erdemcanaz/EE464-Emine-BOOSTanci/Reports/Emine_BOOSTanci_simulation_presentation_24_04_2024_09_21.pptx

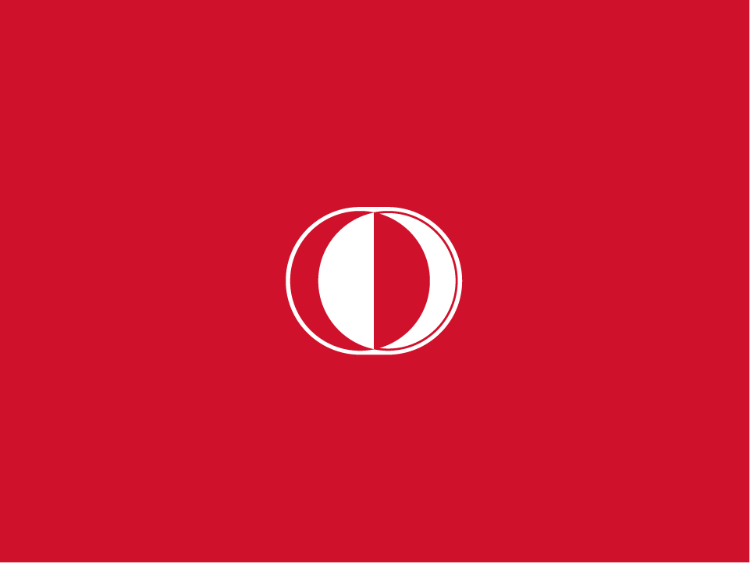
[picture p19: figure]

## Slide 2

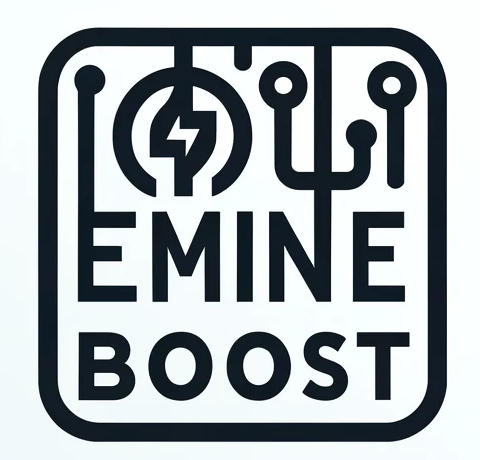
[picture p20: figure]

EE464 HARDWARE PROJECT PRESENTATION
By Emine BOOSTancı

Canberk Kaçan
Erdem Canaz
Erkin Atay Toka

24.04.2024

## Table of Contents

1. Design Criteria
2. Topology & Design Selection
3. Magnetic Design
4. Simulation Results
5. Component Selection
6. Future Work

## 1. Design Criteria

- Minimum Input Voltage: 20 V
- Maximum Input Voltage: 40 V
- Output Voltage: 12 V
- Output Power: 60 W
- Output Voltage Peak-to-Peak Ripple: 3%
- Line Regulation: 3%
- Load Regulation: 3%
- Isolated Converter
- Close Loop Feedback

## 2. Topology & Design Selection

- Flyback Converter: low power applications
- (up to 100 Watts)
- Forward Converter: 50 Watts to a couple of hundred watts
- Push Pull Converter: medium power levels (100 Watts to a few kilowatts)
- Half and Full Bridge Converter: medium to high power ranges (100 Watts to over 500 Watts)
- Push Pull, Half and Full Bridge Convertes are overdesign.

## 2. Topology & Design Selection

- Flyback Converter

- No restriction on D
- Less components (only transformer)
- No resetting the core’s flux
- Easiest to design
- Leakage inductance
- Less efficiency
- More ripple and worse regulation

- Forward Converter

- Restriction on D
- More components (transformer & inductor)
- Resetting the core’s flux
- Harder to design
- Magnetizing inductance
- Higher efficiency
- Less ripple and better regulation

## 2. Topology & Design Selection

- Single Switch Flyback Converter

- Two Switch Flyback Converter

- D < 0.5 for CCM
- Complexity (high side switch)
- High input capacitance
- Higher efficiency

Target Efficiency = %80

- No restriction on D
- Simplicity
- Snubber Design
- Less efficiency

## 2. Topology & Design Selection

- CCM or DCM: CCM. Less ripple but worse core utilization. Analytically easy but nonlineer Bode plot.
- Switching Frequency: 90 kHz.
- Turns Ratio and Duty Cycle Range: 0.23<D<0.375 N=1


## 3. Magnetic Design

- Lm Determination:

L_m >((V_(in)^(max) D_(min) )^2)/(2 P_(in) f_s K_(RF))=((40V 0.238)^2)/(2 (75W)(90kHz)0.7)=9.6 μH


L_m =20 μH

## 3. Magnetic Design

- Core Selection:
- Aim: Operate around 100mT to minimize losses.
- Disadvantage: Volume increase. Losses might increase.
- Choose ferrite core → less leakage. Fringing fields problem
- Higher window area → fill factor auxilary winding
- 0R45530EC (https://www.mag-inc.com/Media/Magnetics/Datasheets/0R45530EC.pdf)

## 3. Magnetic Design

- Core Selection: N_1 ∅=L_m I_(max,pri)

## 3. Magnetic Design

- Core Selection:

L_m =(N_1^2)/(R_(gap))

N1=N2=7 turns
lgap=0.7 mm
Bmax=96 mT

## 3. Magnetic Design

- Cable Selection:
- Choose 2δ (@90kHz 0.44 mm) > Dconductor
- AWG 26 ( D=0.4 mm, A=0.129 mm^2 )
- Maximum RMS Current is 10A.
- J=3 A/mm^2
- #parallels=(I_(rms,max))/(J A)=26
- For safety take 30 parallel.
- From core geometry find MLT and length of the copper.
- R_(primary) =R_(secondary) =3.9mΩ
- P_(Cu) =P_(primary) +P_(secondary) =0.793 W
- Fill Factor=0.1683

[1]

## 3. Magnetic Design

- Core Losses:
- Steinmetz Coefficients

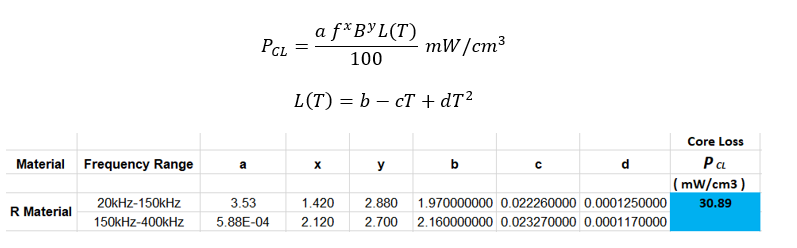
[picture p21: figure]

P_(core) =2VP_(CL) =3.21 W

[2]

## 3. Magnetic Design

- Experimental Results:

L_m =20.94 μH L_(leak) =0.21μH R_(Cu) =4.6 mΩ

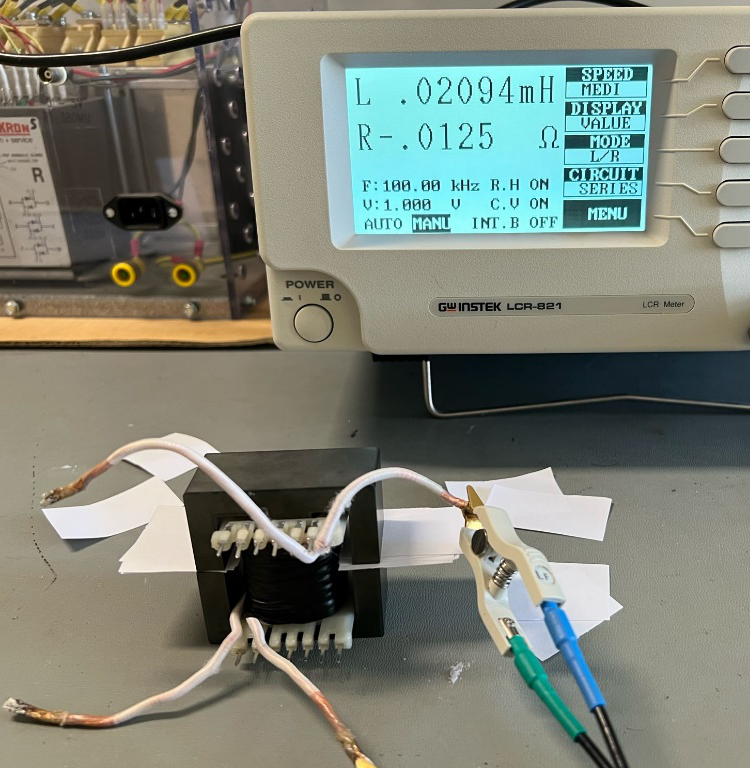
[picture p22: figure]
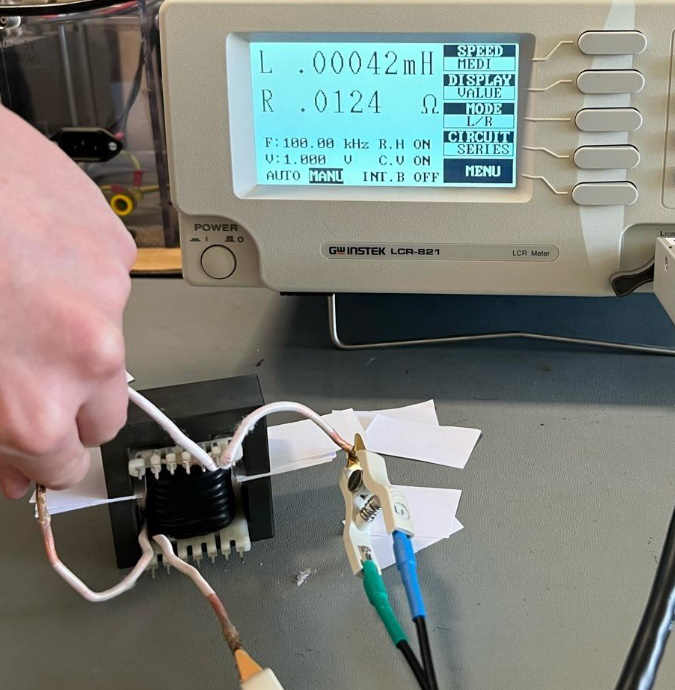
[picture p23: figure]

## 4. Simulation Results:Block diagram

Source model

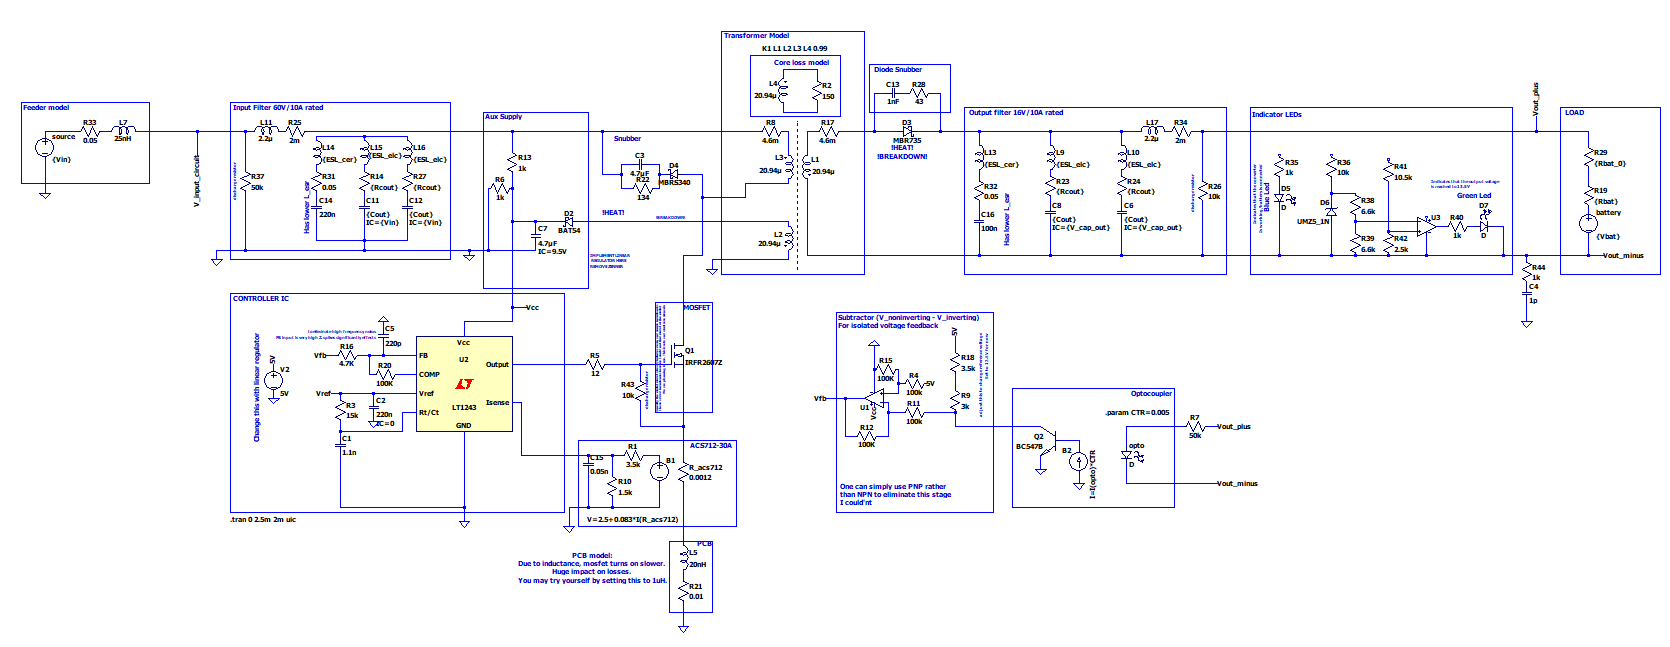
[picture p24: figure]

Input Fil.

Aux. Sup.

Transformer

Diode Snub.

Output Fil.

Indicators

Bat. Model

Snub.

Controller IC

MOSFET

Current
feedback

PCB model

Voltage
feedback

## 4. Simulation Results:Block diagram

Single run for Vin = 40V, Vbat = 12V

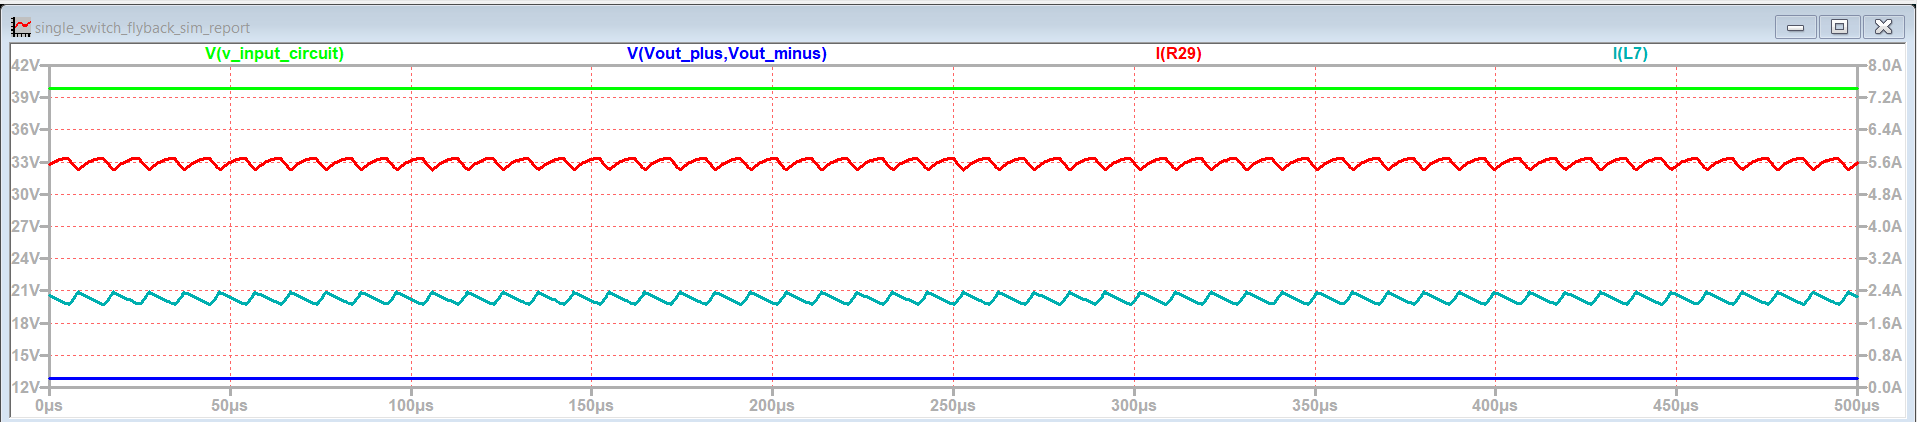
[picture p25: figure]

Vin

Iin

Iout

Vout

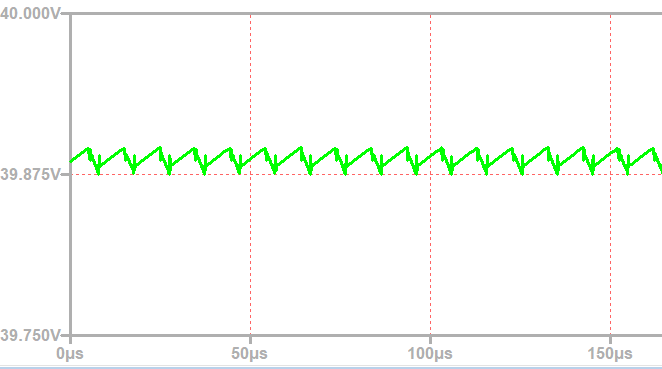
[picture p26: figure]

Vin

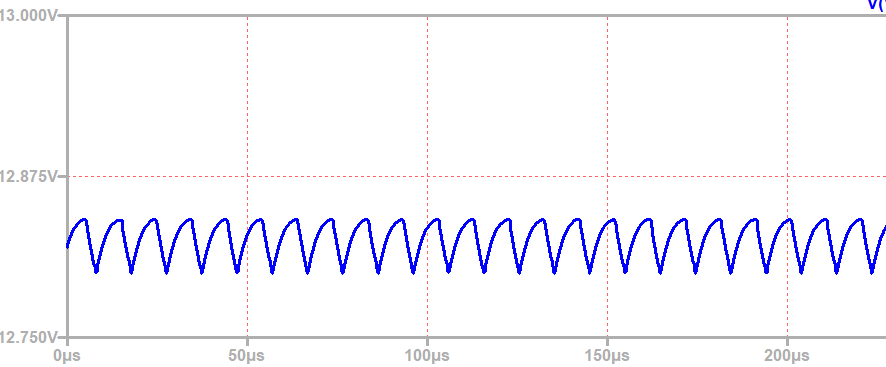
[picture p27: figure]

Vout

## Slide 18

4. Simulation models: Current Feedback

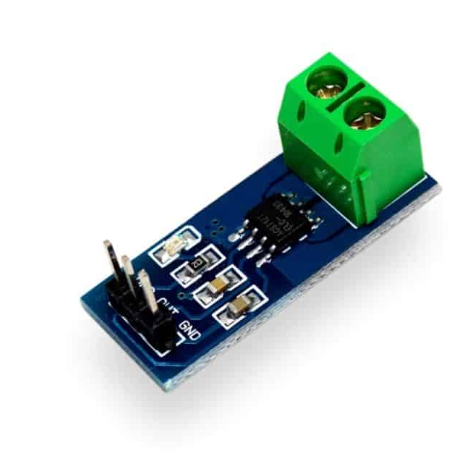
[picture p28: figure]
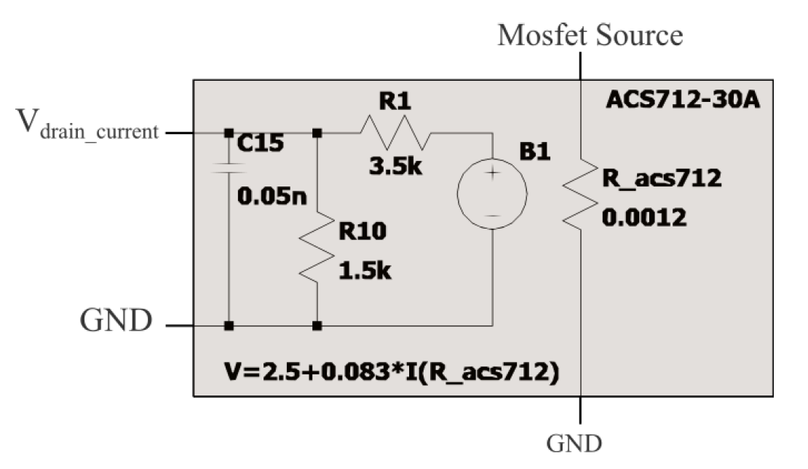
[picture p29: figure]

## Slide 19

4. Simulation Results: Voltage Feedback

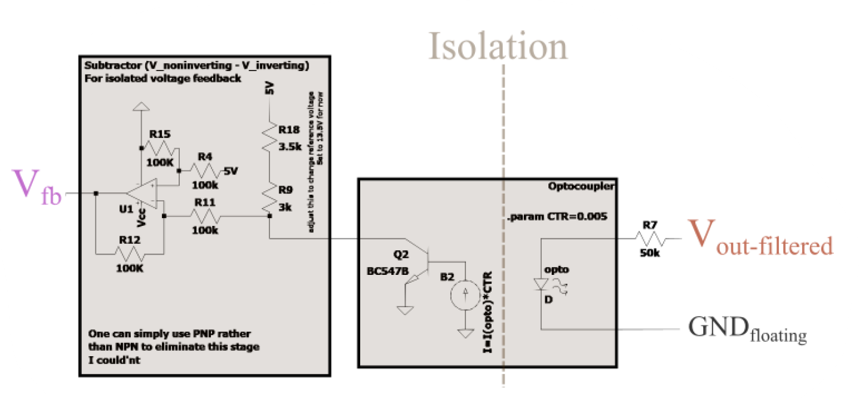
[picture p30: figure]

## Slide 20

4. Simulation Results: Snubber (40V Vin)

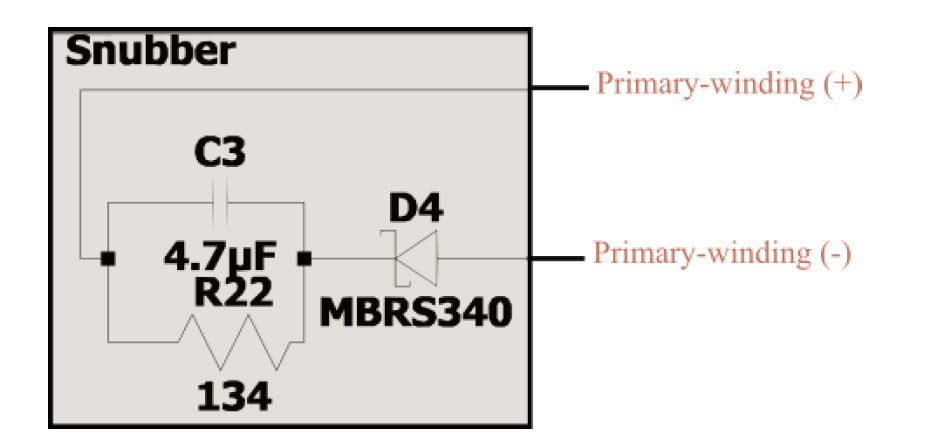
[picture p31: figure]

20v

3.2w

60v

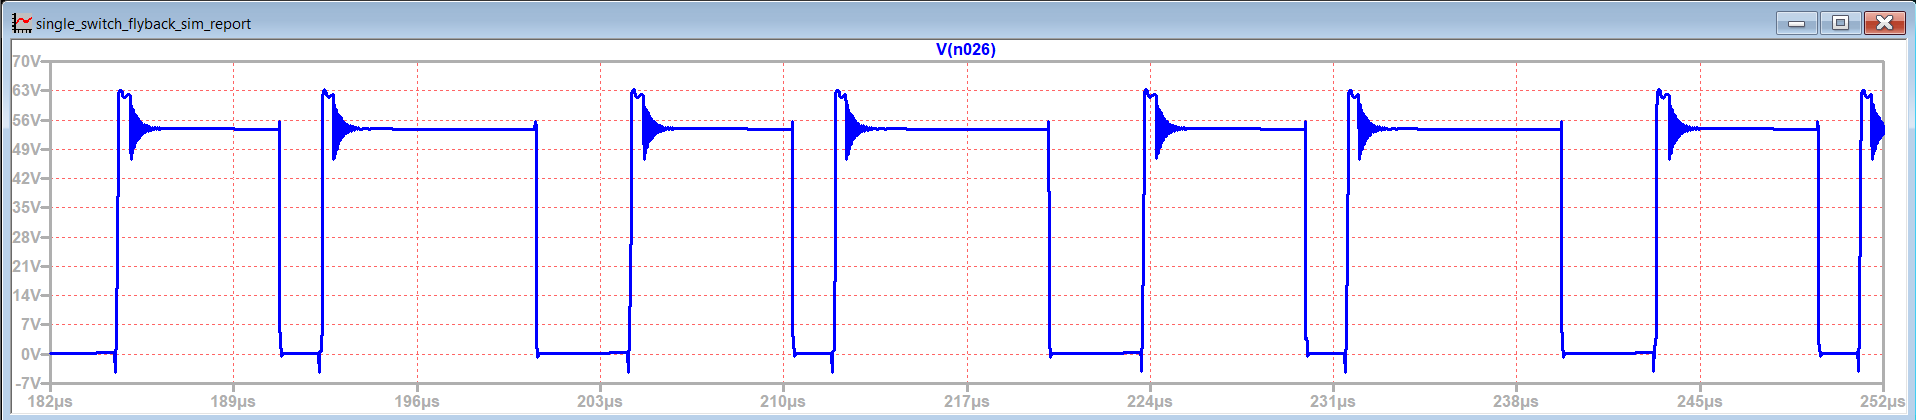
[picture p32: figure]

Drain-to-Source Voltage of MOSFET

## Slide 21

4. Simulation Results: Transformer Model

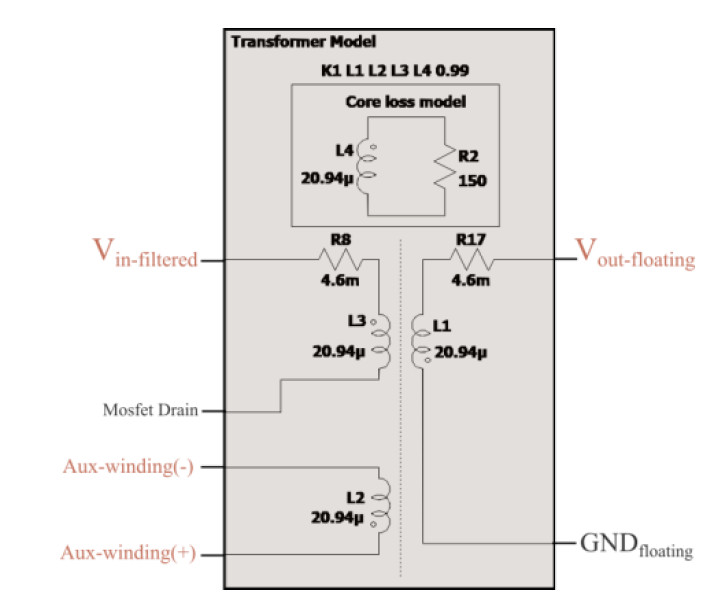
[picture p33: figure]

Coupling Factor
%1

## Slide 22

4. Simulation Results: Output Filter Model

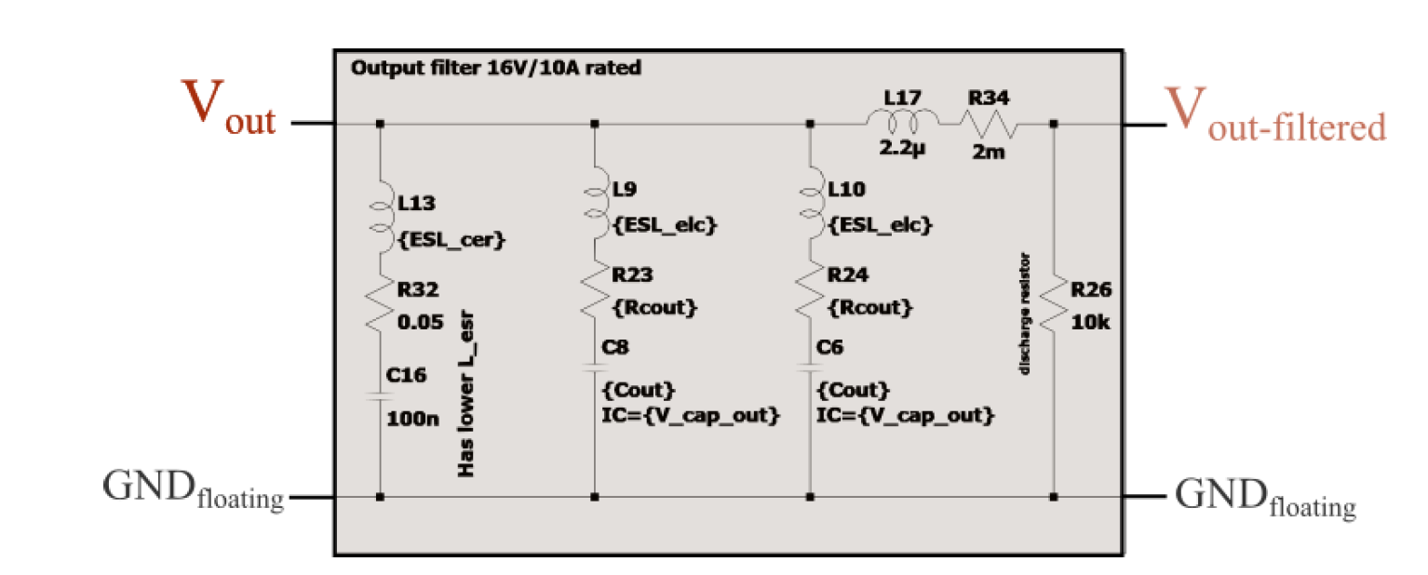
[picture p34: figure]

## Slide 23

4. Simulation Results: Capacitor Model

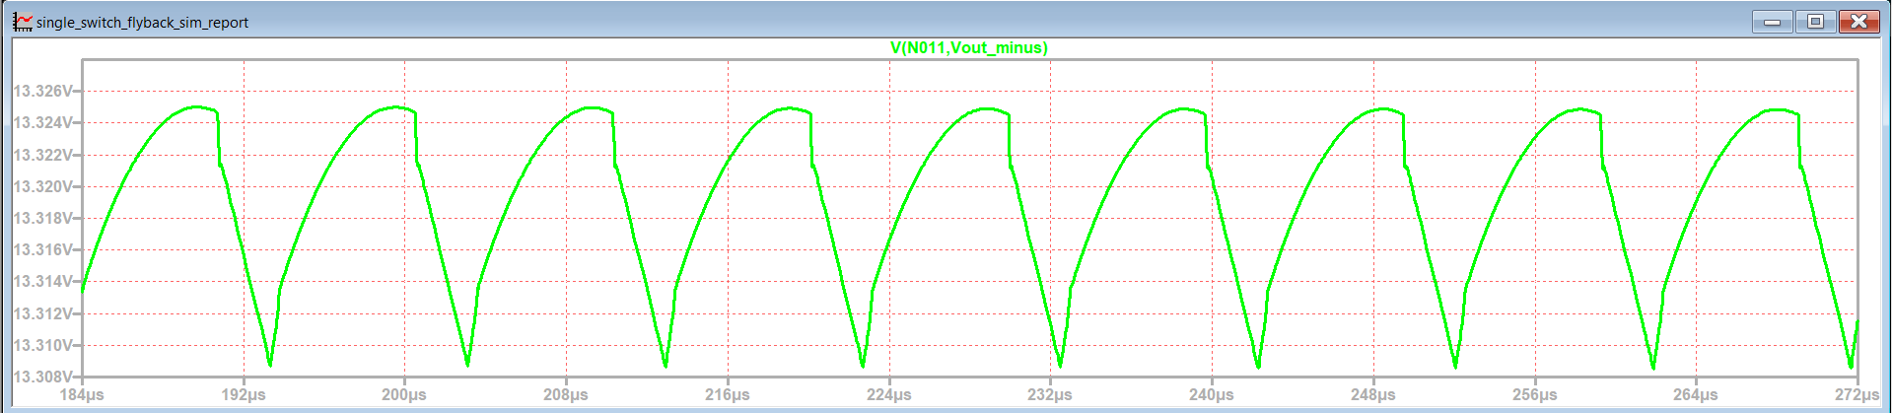
[picture p35: figure]

C

C-R

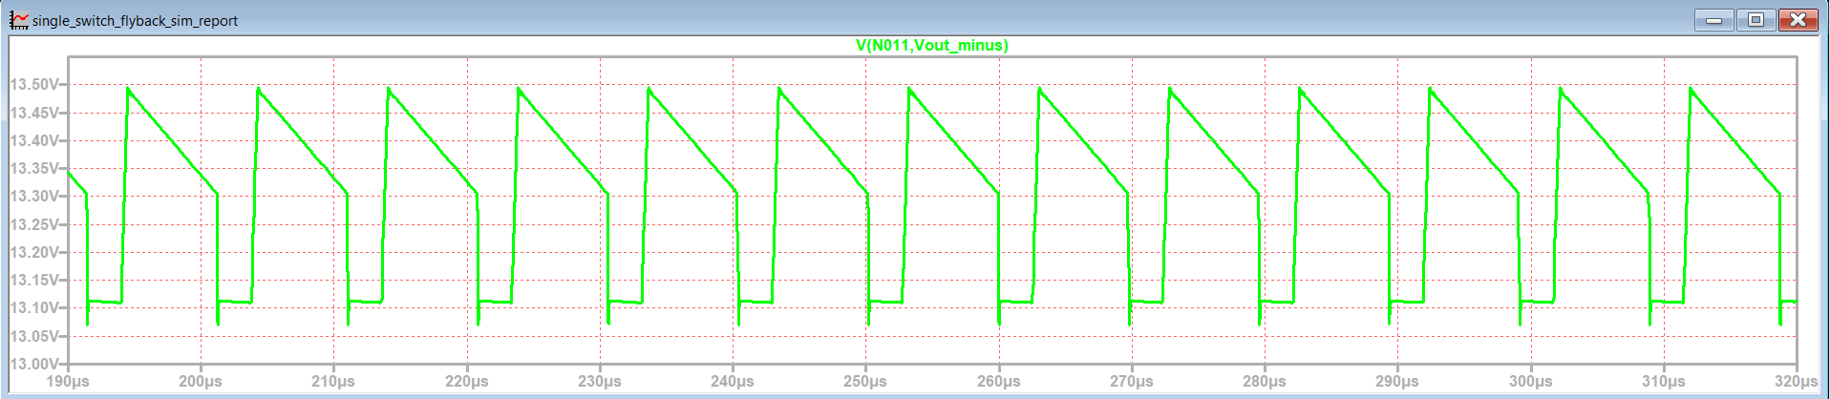
[picture p36: figure]
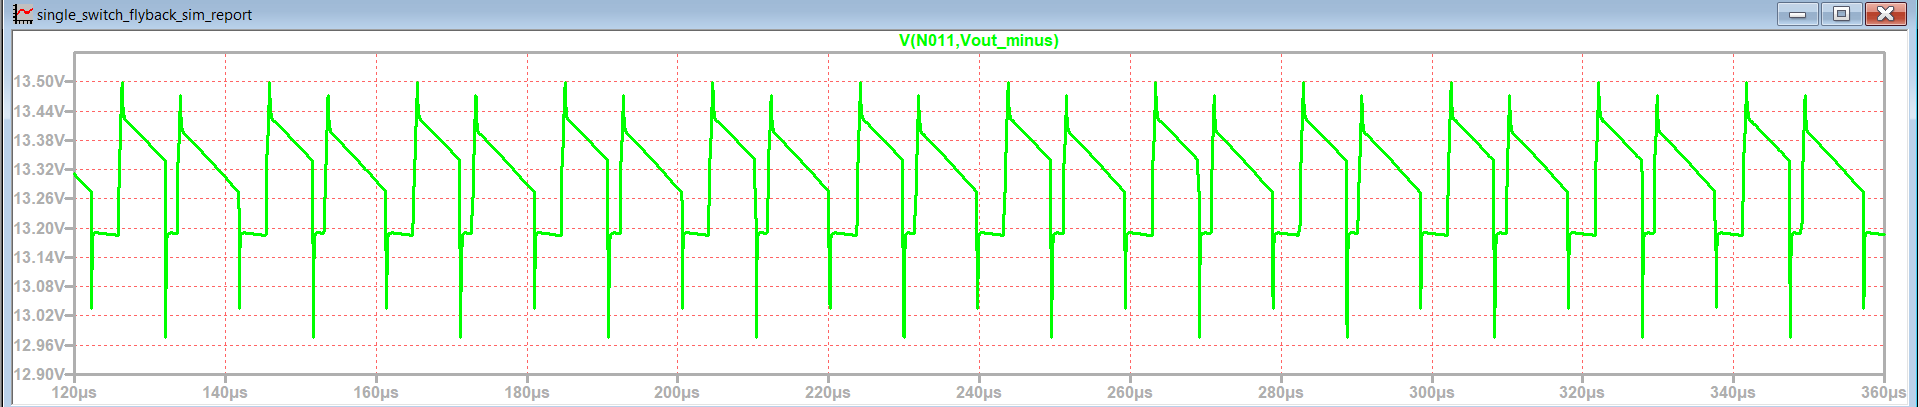
[picture p37: figure]

Output voltages seen at secondary terminals

C-R-L

## Slide 24

4. Simulation Results: Auxiliary Supply Model

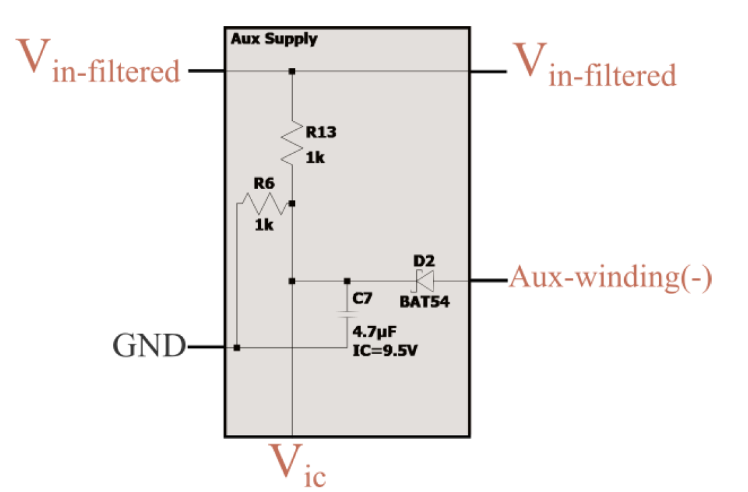
[picture p38: figure]

## Slide 25

4. Simulation Results: Indicator LEDs

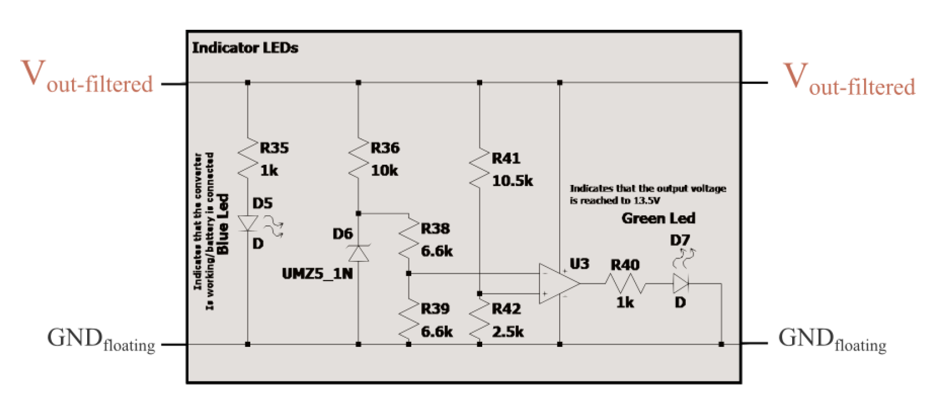
[picture p39: figure]

## 4. Simulation Results: Summary

Vin = {20, 25, 30, 35, 40}V

Vbat = {11, 12, 13}V

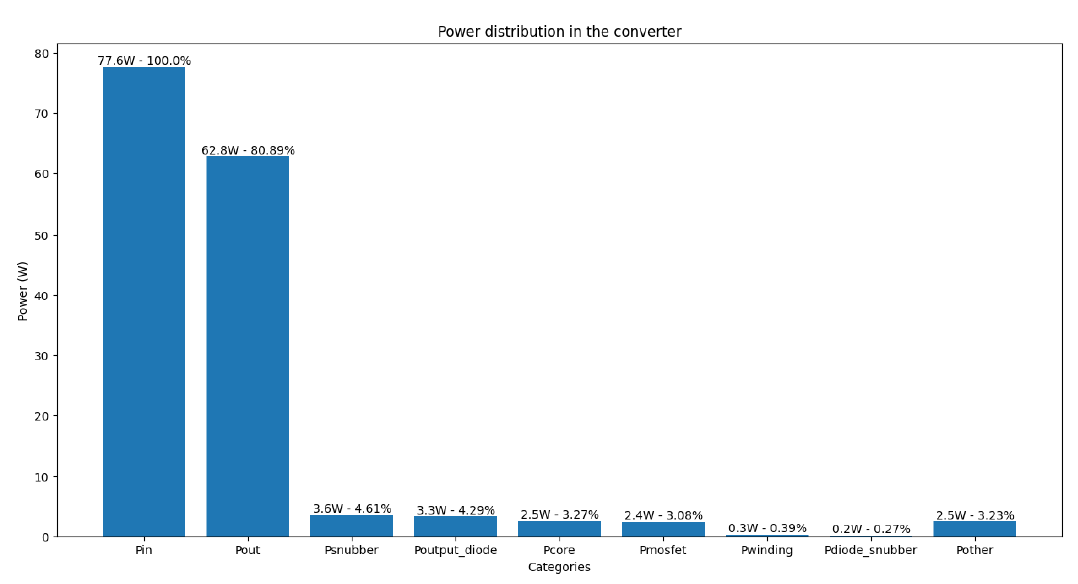
[picture p40: figure]

## 4. Simulation Results: Detailed results

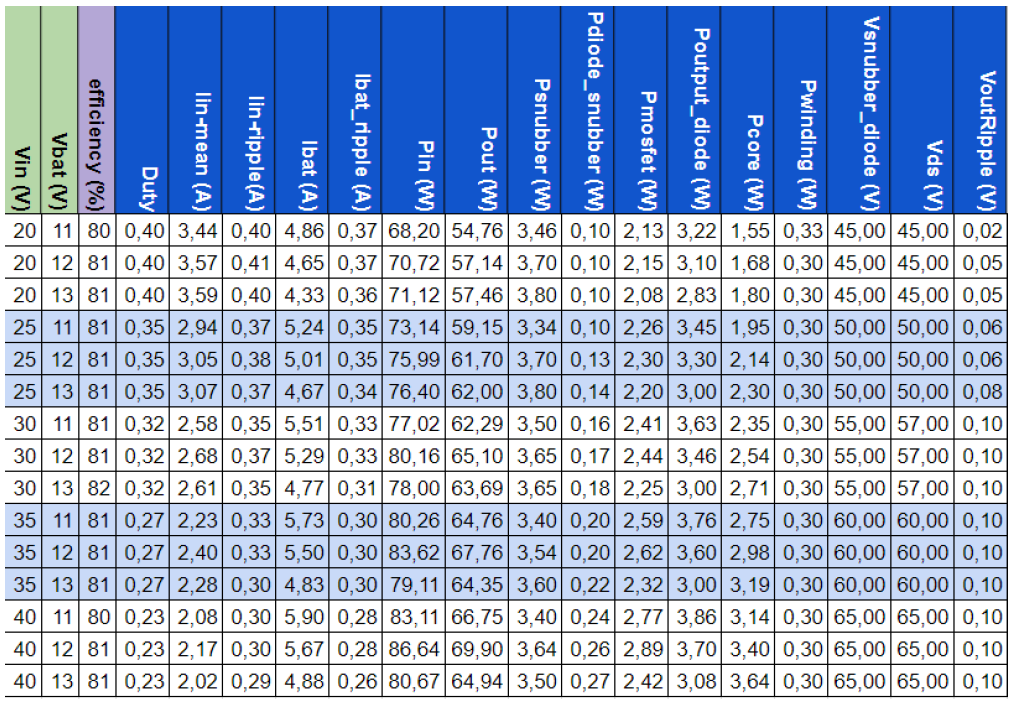
[picture p41: figure]

## 4. Simulation Results: Summary

- About %75-80 efficiency is expected
- Ratings are acceptable
- The snubber works properly
- Voltage regulations are satisfied

## 5. Component Selection

- MOSFET: IRFU3710ZPbF (https://cdn.ozdisan.com/ETicaret_Dosya/652386_243124.pdf)
- ID,max ≈ 10A
- VDS,max ≈ 65V

| Parameter | Max. | Units
ID @ TC = 25°C | Continuous Drain Current VGS @ 10V | 56 | A
ID @ TC = 100°C | Continuous Drain Current, VGS @ 10V | 39 | A
VGS | Gate-to-Source Voltage | ± 20 | V
RDS(on) | Drain-to-Source On-Resistance | 18 | mΩ
VGS(th) | Gate Threshold Voltage | 4.0 | V
tr | Rise Time | 43 | ns
tf | Fall Time | 42 | ns

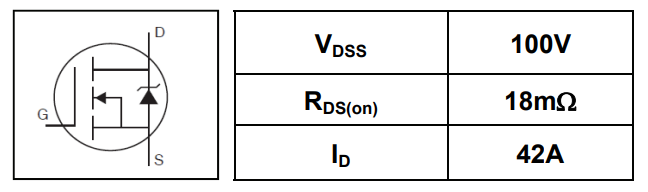
[picture p42: figure]

[3]

## 5. Component Selection

- Diode: DSA30C100PB (https://cdn.ozdisan.com/ETicaret_Dosya/483083_5853486.pdf) (Both for the snubber and the secondary side)
- Schottky diode is chosen due to its speed.

| Parameter | Max. | Units
VRRM(TVJ = 25°C) | max. repetitive reverse blocking voltage | 100 | V
VF (IF = 15A, TVJ = 25°C) | forward voltage drop | 0.91 | V
VF (IF = 15A, TVJ = 125°C) | forward voltage drop | 0.73 | V
IFAV (TVJ = 125°C) | average forward current | 15 | A
CJ | junction capacitance | 146 | pF
IR | reverse current, drain current | 250 | µA

Snubber
IF,max ≈ 8A
Vmax ≈ 65V

Secondary Side
IF,max ≈ 9.5A
Vmax ≈ 62V

[4]

## 5. Component Selection

- Output Filter Inductance: SRI1209-100M (https://pdf.direnc.net/upload/10uh-12x12-datasheet.pdf)

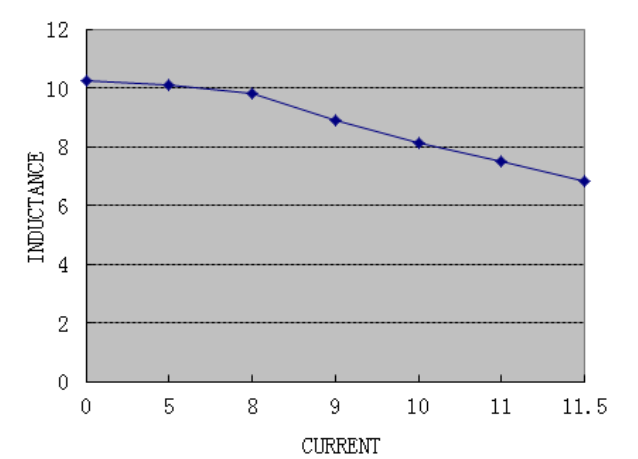
[picture p43: figure]

Parameter | Max. | Units
L | 10 ± 20% | µH
RDC | 0.03 | Ω
IDC | 10 | A

Test Conditions:
1KHZ / 0.25V

Output
Current

[5]

## 5. Component Selection

Input Capacitor:
4xPKLH-063V471 (https://cdn.ozdisan.com/ETicaret_Dosya/465839_6115297.pdf)
63V 470µF

Output Capacitor:
4xPKLH-016V471 (https://cdn.ozdisan.com/ETicaret_Dosya/342170_703953.pdf)
16V 470µF

Control IC:
UC3845AN (https://cdn.ozdisan.com/ETicaret_Dosya/501245_5372110.pdf)
Due to duty cycle limiting behaviour

Current Sensor IC:
ACS712-30A (https://pdf.direnc.net/upload/acs712-datasheet.pdf)

And various resistors

[6-9]

## 6. Future Work

- Optocoupler Design Finalization
- Design Implementation on Stripboard
- Thermal Analysis
- PCB Design (Bonus)
- Case Design (Bonus)

## 6. References

[1] W. (n.d.). Round Wire ac Resistance Calculator. https://chemandy.com/calculators/round-wireac-resistance-calculator.htm
[2]“Magnetics - Ferrite Core Loss Calculator.” https://www.mag-inc.com/Design/DesignTools/Ferrite-Core-Loss-Calculator
[3] https://cdn.ozdisan.com/ETicaret_Dosya/652386_243124.pdf [4]https://cdn.ozdisan.com/ETicaret_Dosya/483083_5853486.pdf
[5] https://pdf.direnc.net/upload/10uh-12x12-datasheet.pdf
[6] https://cdn.ozdisan.com/ETicaret_Dosya/465839_6115297.pdf
[7] https://cdn.ozdisan.com/ETicaret_Dosya/342170_703953.pdf
[8] https://pdf.direnc.net/upload/acs712-datasheet.pdf
[9] https://cdn.ozdisan.com/ETicaret_Dosya/501245_5372110.pdf

## In memory of …

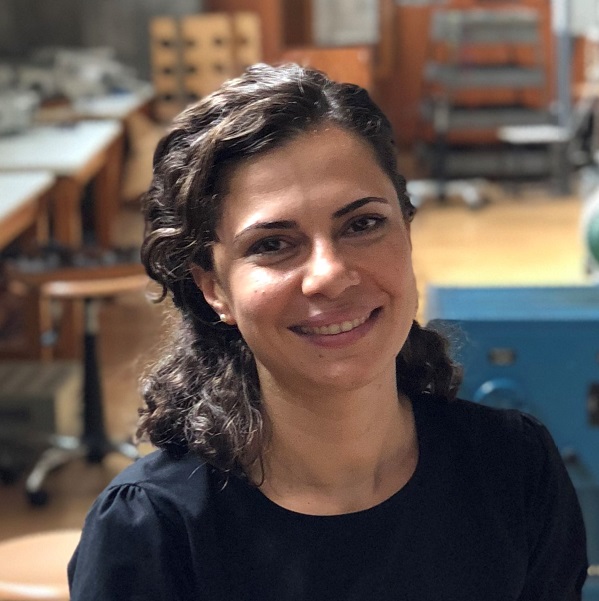
[picture p44: figure]
Powerlab - Team

## Slide 36
