erdemcanaz/EE464-Emine-BOOSTanci/Reports/HW1.docx

Formlar ve Görseller | ODTÜ ELEKTRİK - ELEKTRONİK MÜHENDİSLİĞİ

MIDDLE EAST TECHNICAL UNIVERSITY

DEPARTMENT OF ELECTRICAL AND ELECTRONICAL ENGINEERING

EE 464 HOMEWORK 1

Magnetic Design of the Hardware Project

Student 1: Erkin Atay Toka 2443968

Student 2: Canberk Kaçan 2443240

Student 3: Erdem Canaz 2374676

GitHub Page: https://github.com/canberkkacan/EE464_HW1

Submission Date: 24.03.2024

# Introduction

In this homework, the magnetic design and the basic analysis of the project is completed. The specifications of the project are listed below.

Minimum Input Voltage: 20 V

Maximum Input Voltage: 40 V

Output Voltage: 12 V

Output Power: 60 W

Output Voltage Peak-to-Peak Ripple: 3%

Line Regulation (Deviation of percent output voltage when input voltage is changed from its minimum to maximum or vice versa): 3%

Load Regulation (Deviation of percent output voltage when load current is changed from 10% to 100% or vice versa): 3%

DC/DC Converter must be isolated.

For this project flyback converter working in the CCM operation is chosen as the topology. First, duty cycle range and the turns ratio are determined. Then magnetic design of the project is completed by selecting the core deciding the magnetizing inductance and turn numbers of the primary and secondary. While making these decisions DCM boundary and the core saturation are taken into account. Then the AWG cables are selected for primary and secondary considering the AC resistance and current carrying capacity. After that the fill factor is calculated. Then the copper losses and the core losses which is given by the manufacturer are calculated for the transformer. Later, ideal condition and the unideal condition is simulated. In the unideal condition besides the losses the leakage inductance is taken into account. For flyback converters leakage inductance may harm the switches. Thus, a snubber design is made. At the end efficiency of the converter is evaluated for different load conditions considering the magnetic core losses, copper losses and semiconductor losses.

# Question 1

a) Select a duty cycle range for your topology. For this selection, find the turns ratio of transformer.

Flyback converter is selected as isolated converter for this project. The input output voltage relation for the flyback converter is given below.

(V_(out))/(V_(in))=(N_2)/(N_1)D/((1-D))

For this project (V_(out))/(V_(in)) is in the range of 0.6 to 0.3. To decide the turns ratio and the duty cycle range these parameters are plotted with respect to each other for maximum and minimum voltage gain. This plot is given in Figure 1.

Figure 1 Duty Cycle vs Turns Ratio wrt Max and Min Voltage Gain

Selecting duty cycle high will fail due to the parasitic elements. Moreover, selecting duty cycle small will also fail due to small charging time in the power transformer inductance. This will lead to saturation. Thus, it is safe to choose duty cycle around 0.5. According to Figure 1 turns ratio is selected as 0.5 so that the duty cycle range is between 0.375 to 0.5455 which is shown with yellow dashed line in Figure 1.

b) Design a transformer and estimate its equivalent circuit parameters. Explain the design procedure in detail. The cores given in the link will be available for you to borrow, but you can use any commercially available core.

Before selecting the core the magnetizing inductance in the primary side L_m is determined. The L_m decided so that the converter does not work in DCM mode but also the peak inductor current is not too high so that the core is not saturated. For these conditions the average inductor current and the current ripple are important. The average inductor current depends on the average current and duty cycle. To find average input current the efficiency of the converter must be known. For now, efficiency of the converter will be estimated as 83%.

P_(in) =(P_(out))/tf=72.29 W

I_(in,avg,max) =(P_(in))/(V_(in,min))=3.6145 A

I_(in,avg,min) =(P_(in))/(V_(in,max))=1.8073 A

Input current is equal to the primary side inductor current for DTs and zero for the rest of the switching period. The relationship between the primary side inductor current and the input current is given as follows.

I_(Lm,avg) =(I_(in,avg))/D

Maximum and minimum average primary side inductor current is calculated as 6.6265 A and 4.8193 A respectively.

For current ripple Krf is defined as ripple factor as given in Figure 2.


Figure 2 Ripple Factor

In order to avoid DCM operation KRF must be smaller than 1. Also, smaller KRF will decrease the output voltage ripple. However, lower KRF might increase the transformer flux which will lead to the saturation of the core. For safety 0.7 KRF is avoided. The needed inductance can be calculated as follows.

L_m >((V_(in)^(max) D_(min) )^2)/(2 P_(in) f_s K_(RF))=((40V 0.375)^2)/(2 (72.29W)(100kHz)0.7)=22.23 μH

Primary side inductance is selected as 30 µH.

The saturation must be avoided. The saturation is determined by the peak current. The primary peak current is plotted with respect to the input voltage in Figure 3.

Figure 3 Peak Primary Current vs Input Voltage

From Figure 3 it can be seen that the maximum peak current occurs when the input voltage is minimum. This value is calculated as 8.45 A.

Now it is time for magnetic core selection. For core selection there are two options, a distributed gap core or a ferrite core. Relative permeability of the distributed gap cores is small, the leakage inductance is higher with respect to the ferrite core. Since the leakage inductance is dangerous for the switches a ferrite core 0R45530EC which is available in the laboratory is selected. One of the reasons to select this core is that its cross section area is high thus the saturation of the core can be easily avoided. Also, operating around 100 mT is aimed so that the core losses will be minimized although the volume of the core is increased. Another reason for selecting this core is the fact that its window area is the largest. This will ease the winding procedure. In addition to the primary and secondary windings we will utilize the auxiliary winding to power up the controller.

To decide the number of turns in the primary side the core flux density and the length of the air gap will be considered. Half of the flux passing through the center leg of the core will be passing through the side legs. Nevertheless, the cross section area of the side legs is not exactly the half of the cross section area of the center leg. Therefore, the magnetic field density will not be equal in the center leg and the side legs. It is known that maximum primary current will occur when duty cycle is maximum. Thus, the maximum magnetic field density will occur in maximum duty cycle. The relationship between primary turns number and magnetic field density is given below.

R_(core) =(N_1^2)/(L_m)

∅=(N_1 I_(Lm,peak))/(R_(core))=(L_m I_(Lm,peak))/(N_1)

B=(∅)/A=(L_m I_(Lm,peak))/(A N_1)

To illustrate the relation between magnetic flux density and primary turns number these two are plotted with respect to each other in Figure 4. It can be seen that the center leg saturates more than the side legs.

Figure 4 Magnetic Field Density vs Primary Turns Number

Before selecting the primary turns number, we need to also consider the air gap length. Since the relative permeability of the core is 2300 the reluctance of the core is negligible with respect to air gap reluctance. The magnetic circuit of the transformer is given in Figure 5.


Figure 5 Magnetic Circuit of the Transformer

Reluctance of side legs and center leg can be found as follows.

R_(side) =(l_(gap))/(μ_0 A_(side))

R_(center) =(l_(gap))/(μ_0 A_(center))

R_(core) =R_(center) +(R_(side))/2=(N_1^2)/(L_m)

l_(gap) =(N_1^2)/(L_m)(2μ_0 A_(center) A_(side))/(A_(center) +2A_(side))

In order to determine the primary turns number, the air gap length is plotted with respect to the primary turns number in Figure 6.

From Figure 5 it can be seen that increasing the primary turns number will decrease the magnetic field density. However, increasing the primary turns number will also increase the air gap length. This is not desired due to the increasing fringing fields with increasing airgap length which can be seen from Figure 6. From both of these figures the primary turns number is selected as 6. It can be seen that maximum magnetic flux density of the center leg is 100.3 mT and air gap length is 3.315 mm for the selected turns number. The peak magnetic flux density is small enough to minimize the core loss and also the air gap length is small enough to ignore the fringing fields.

N_1 =6 turns

N_2 =(N_2)/(N_1)N_1 =0.5*6=3 turns

Figure 6 Air Gap Length vs Primary Turns Number

Magnetic field density vs the duty cycle for center and side legs are given in Figure 7.

Figure 7 B Field vs Duty Cycle

Now we need to choose an AWG cable for primary and secondary. First the skin depth is calculated for the switching frequency which is 100 kHz.

δ=√((ρ_(Cu))/(μ_0 πf_s))=√((1.724 10^(-8))/(μ_0 π 100 10^3))=0.209 mm

A_(strand) =πδ^2 =0.1372 mm^2

The copper area must be equal or smaller than the strand area. Hence, AWG26 with 0.129 mm² is selected as primary and secondary cable.

Now we need to find how many cables to parallel in order to carry primary and secondary currents. Thereby, the rms value of the primary and the secondary currents are calculated. RMS value for a inductor current given in Figure 8 can be calculated as follows.

Shows inductor current ripple with minimum and maximum peak | Download Scientific Diagram

Figure 8 Typical Inductor Current

I_(L,rms) =√(I_L^2 +(∆I_L^2)/12)

According to this formulation rms primary current vs input voltage is plotted in Figure 9. From Figure 9 it can be seen that the rms primary current reaches its maximum value of 6.71 A at minimum input voltage. The secondary maximum rms current can be found as 13.42 A from the below relation.

I_(secondary) =(N_1)/(N_2)I_(primary)

Figure 9 RMS Primary Current vs Input Voltage

The current carrying capacity of the AWG26 cable is 0.361 A. However, this value is indicated for straight line. Since we will wound the cable, the capacity will drop. For take wounding effect into count, the current carrying capacity will be multiplied with 0.75. Number of parallel cabled can be found as follows.

#parallel cables=nearest integer((I_(rms max))/(0.75 Current carrying capacity_(AWG26)))

For primary and secondary the number of parallel cables is calculated as 25 and 50 respectively. The area of an AWG26 cable is 0.129 mm². Total cable area can be calculated as follows.

A_(Cable) =A_(AWG26) (N_1 #primary parallel cables+ N_2 #secondary parallel cables)

A_(Cable) =38.7 mm^2

The window area of the core is calculated from its dimensions as 375 mm².

Fill Factor=(A_(Cable))/(A_(window))=0.103

The fill factor is acceptable up to 0.3 to 0.4. Although our choice might seem like an overdesign, we plan to utilize auxiliary winding to power up the controller.

Since the radius of the conductor is chosen smaller than the skin depth both AC resistance is quite same as the DC resistance. This is verified from a website that measures AC resistance of a specified cable [1]. The mean length turn of the core is calculated from the geometry in order to find the length of the wounded cable. Also, a safety factor of 1.15 is taken due to the cable thickness. This mean length turn is multiplied by the turns number to find total length of the cables.

R_(primary) =ρl/A=1.678 10^(-8) Ωm (0.5756 m)/(25 π((0.439 10^(-3))/2m)^2)=3.1 mΩ

R_(secondary) =ρl/A=1.678 10^(-8) Ωm (0.2878 m)/(50 π((0.439 10^(-3))/2m)^2)=0.77 mΩ

Maximum copper losses can be calculated from the maximum rms current which is found as 6.71 A and 13.42 A for primary and secondary respectively.

P_(copper,primary) =I_(primary rms)^2 R_(primary) =0.1387 W

P_(copper,secondary) =I_(secondary rms)^2 R_(secondary) =0.1387 W

P_(copper) =P_(copper,primary) +P_(copper,secondary) =0.2774 W

For core losses an excel file is obtained for ferrite materials from [2]. In this Excel file Steinmetz coefficients are available. Steinmetz equation and coefficients for the R type material are given below.

P_(CL) =(a f^x B^y L(T))/100 mW/cm^3

L(T)=b-cT+dT^2

Figure 10 Steinmetz Coefficients for R Material

For maximum core loss, maximum flux density which is 1.03 T has been chosen. For operating temperature and frequency 60°C and 100kHz is chosen respectively. Core loss density is calculated as 63.53 mW/cm³ for this operation condition. To find the core loss the core loss density is multiplied with twice the volume of the core (volume of the core is 208 cm³). Since two EC cores are used. Total core loss is found to be 6.67 W. Core loss is approximately 20 times higher than the copper loss. Since we operate at high frequencies this is acceptable.

For maximum core loss, maximum flux density which is 1.03 T has been chosen. For operating temperature and frequency 60°C and 100kHz is chosen respectively. Core loss density is calculated as 63.53 mW/cm³ for this operation condition. To find the core loss the core loss density is multiplied with twice the volume of the core (volume of the core is 208 cm³). Since two EC cores are used. Total core loss is found to be 6.67 W. Core loss is approximately 20 times higher than the copper loss. Since we operate at high frequencies this is acceptable. In order to use in unideal modelling of the converter Rcore can be found as follows.

R_(core) =(V_(out)^2)/(P_(core))((N_1)/(N_2))^2 =86.35 Ω

c) Simulate the converter with ideal switches and transformer (including Lm of course). Calculate the main parameters of the converter and show the relevant graphs.

After calculating the transformer parameters, as discussed in part b, the output capacitance value must be calculated for the flyback converter. To calculate the output capacitor value, the following equation has been utilized:

C= (DV_O)/(Rf∆V_O)=(0.55*12)/(2.4*100k*0.36)≅77μF

After calculating the output capacitor value, the converter has been simulated. The converter circuit can be seen in Figure 11.

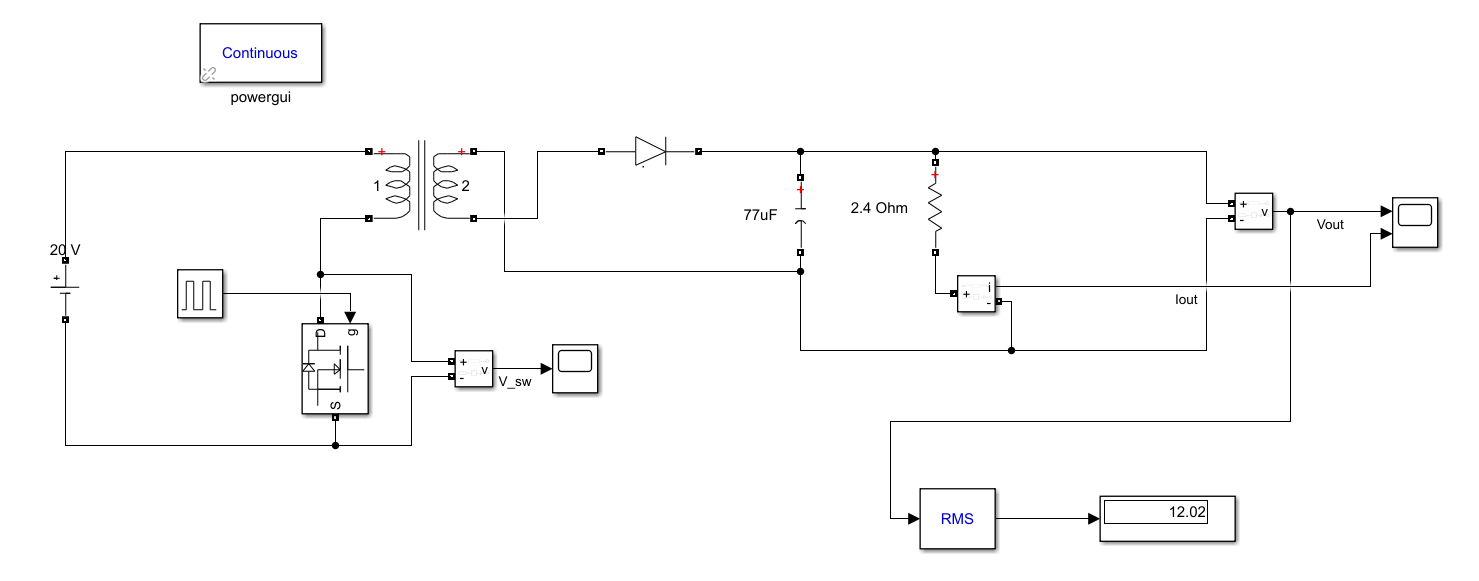
[picture p60: figure]

Figure 11 Simulated flyback converter

The converter has various parameters. First of all the duty cycle is one of the most important parameters of the converter which changes with the change of the input voltage since we try to supply a constant voltage at the load side. Change of the duty cycle with the input voltage can be seen in Figure 12.

Figure 12 Input voltage vs. duty cycle graph

The second parameter is the load voltage and current. In the project, a constant and nearly ripple free, peak-to-peak ripple must not exceed 3%, load voltage and current must be reached. In the simulation we have seen that we could meet these requirements, as shown in Figure 13.

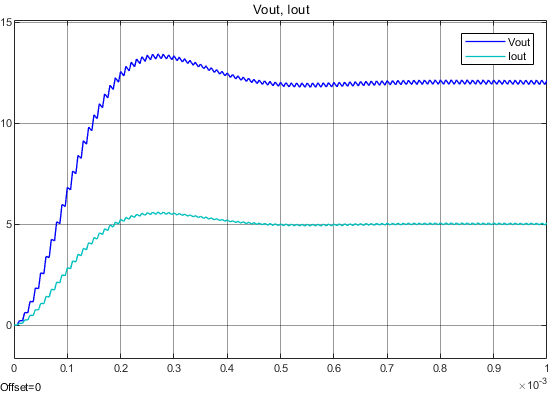
[picture p61: figure]

Figure 13 Output voltage and current waveforms.

The last parameter is the switch voltage. Since high voltage levels on the switch can cause switching failure, the voltage on the switch must be observed. You can see the switch voltage in Figure 14.

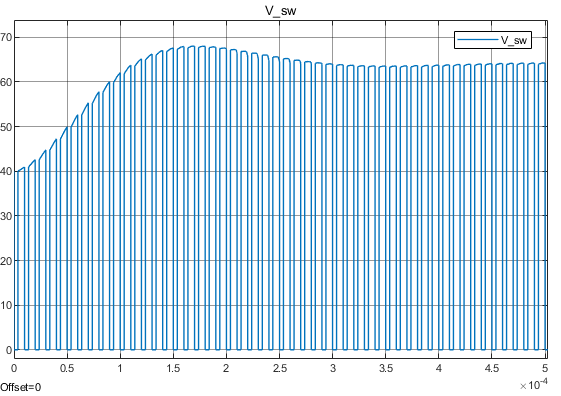
[picture p62: figure]

Figure 14 Switch voltage waveform.

As you can see, in the ideal case, the switch voltage goes up to approximately 70V, which is a value most of the switches can handle; thus, there is no need to implement a snubber circuit for the ideal case.

d) Calculate the minimum load current you can work without getting into the DCM, and calculate the min-max transformer current. (Your hardware design may be work in DCM, this question is just for homework).

At the boundary of DCM and CCM operation, the average current is half of the ripple. The minimum load current without entering DCM for Vin,max and Vin,min can be found as follows.

For V_(in,max) =40 V :

I_(LB) =((1-D_(min) ))/(2 L_m f_s) (N_1)/(N_2)V_o =((1-0.375))/(2 (30μH) (100kHz)) (2) (12)=2.5A

I_(load,min) =I_(LB) (N_1)/(N_2)(1-D_(min) )=3.125 A

For V_(in,min) =20 V :

I_(LB) =((1-D_(max) ))/(2 L_m f_s) (N_1)/(N_2)V_o =((1-0.5455))/(2 (30μH) (100kHz)) (2) (12)=1.818A

I_(load,min) =I_(LB) (N_1)/(N_2)(1-D_(max) )=1.6525 A

Maximum input voltage determines the minimum current so that the converter operates at CCM for all input voltage range. Minimum load current that ensures CCM operation is 3.125 A. Primary winding current is calculated as 2.5 A and secondary side current is 5A (primary current is divided by the turns ratio).

e) Simulate the transformer with parasitic components (transformer leakage inductance etc.) and non-ideal switches to observe the voltage-current oscillations in the switches. Although it is encouraged to choose the switch that you will use, you can make the simulations with any non-ideal switches. The idea is just to observe the voltage-current stress in the switches. Design any snubbers if required. You may refer to application notes for this purpose.

In Fig. 15, The simulated and practically realizable circuit is shown. In this circuit, the leakage is simply assumed to be %5 of the magnetizing inductance and the series winding resistance is assumed to be 0.1 Ω .

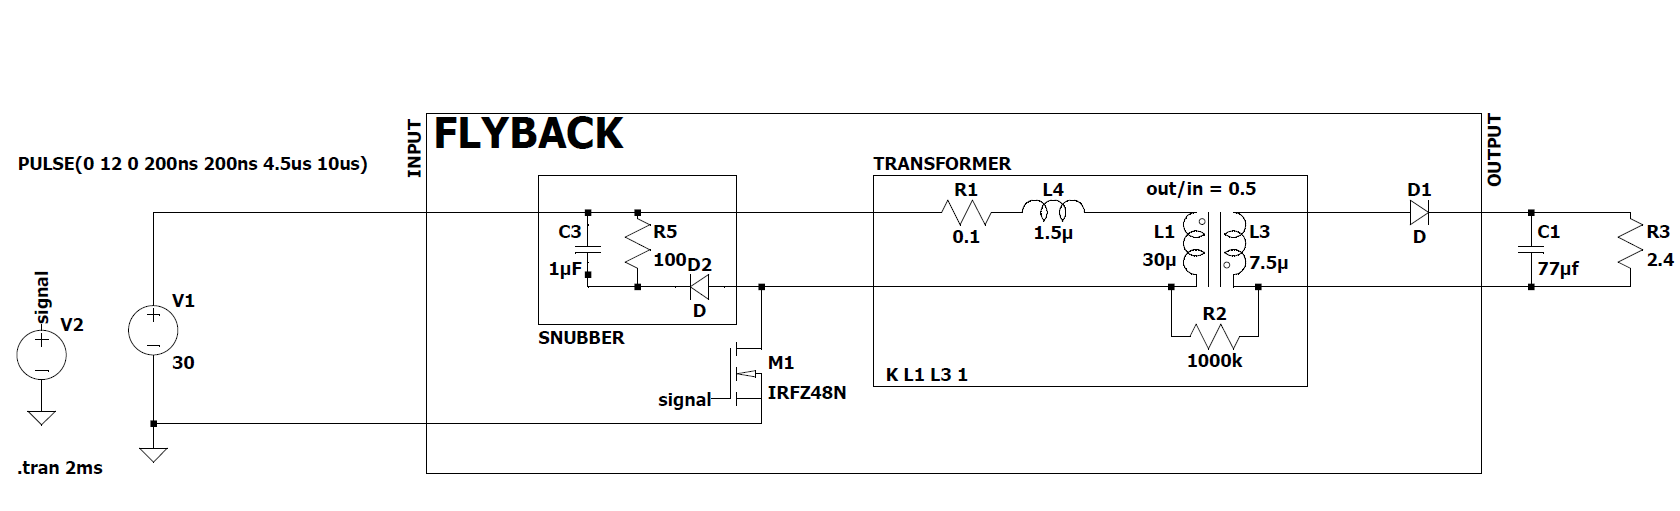
[picture p63: figure]

Figure 15 Simulation where parasitic effects of the transformer are considered

When the snubber is used, the drain to source voltage and drain current of the switch is given in Fig. 16

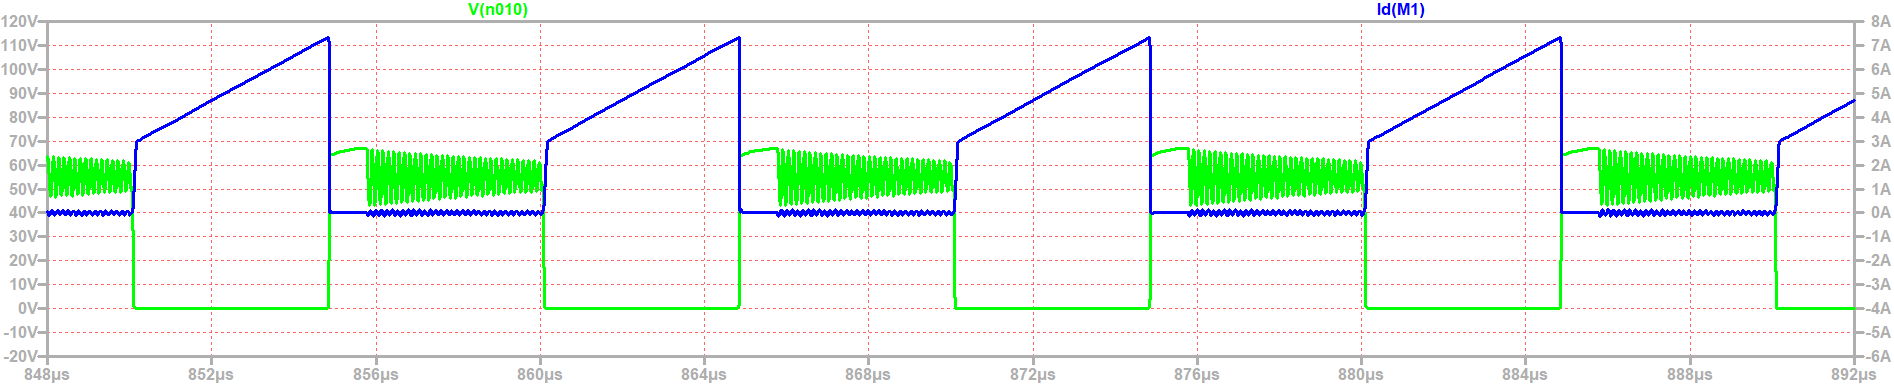
[picture p64: figure]

Figure 16 Simulation of the flyback where snubber is utilized

The case where snubber is disconnected (i.e. replace diode with open circuit), the drain to source voltage and drain current of the switch is given in Fig. 17.

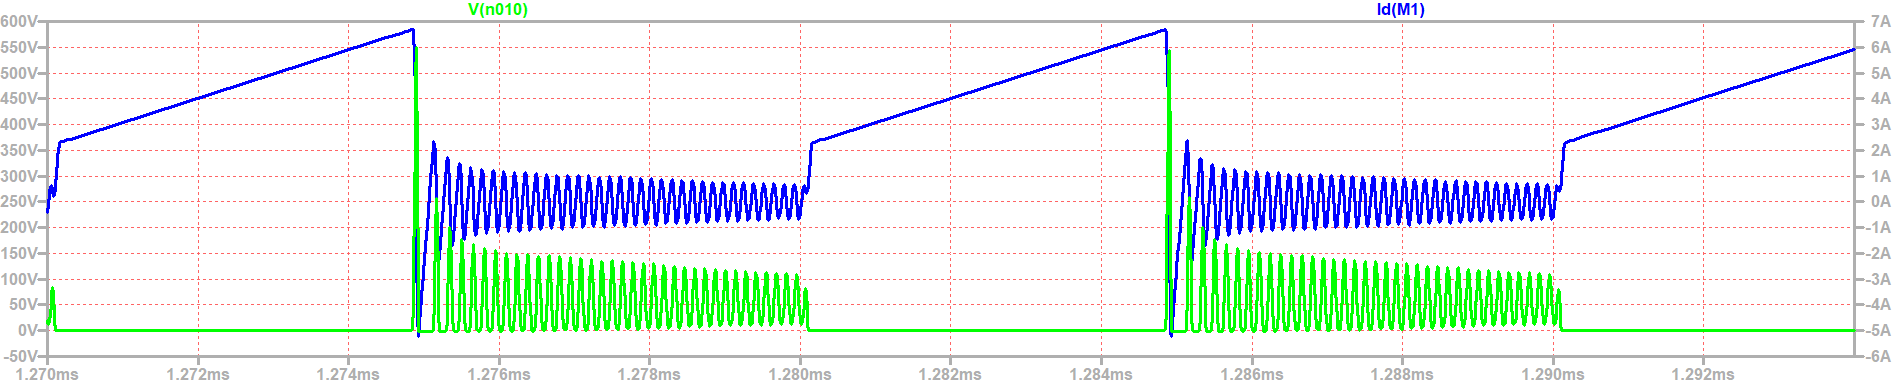
[picture p65: figure]

Figure 17 Simulation of the flyback where snubber is not utilized

It's clear that without a snubber circuit, the switch can be exposed to very high voltage levels that it might not be able to handle. This happens because the switch's very low drain-to-source capacity (about 50nC) compared to the transformer's leakage inductance (about 1.5uH), which leads to very strong and rapid voltage swings. Therefore, adding a snubber circuit is critical to keep the switch safe. However, a major downside of using a snubber circuit is that it turns some of the energy into heat. For example, the resistor R5 in Figure 16 uses up 12W of power. Considering the system needs to supply 60W to the load, losing this much power affects efficiency noticeably. In addition to searching for ways to design more efficient snubber, future work will look into topologies that can save this energy by sending it back to the power source or battery instead of turning it into heat, which could make the system more efficient. Regarding current stress, there are no dangerous effects. However, oscillations seen in Fig. 17 may lead to electromagnetic interference (EMI) issues, which can also be effectively addressed by a snubber circuit.

# f) Calculate the efficiency of your converter (including transformer and semicondutor losses) at 100%, 50% and 25% load conditions for both voltage limits.

In order to calculate efficiency of the converter LTSpice model shown in Figure 18 is constructed.

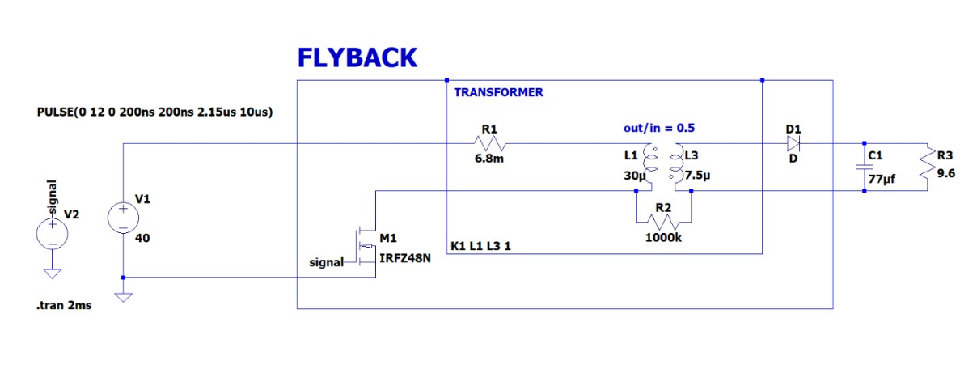
[picture p66: figure]

Figure 15 LTSpice Converter Model

For 100%, 50% and 25% load conditions output resistance is set to 2.4 Ω, 4.8 Ω and 9.6 Ω respectively and the duty cycle is adjusted so that output voltage is regulated to 12V. Input voltage is adjusted to 20V and 40V for each load condition. This model includes all losses except the core loss. From the peak primary current peak flux is calculated. By using the Steinmetz equation given in [2] the core losses are calculated. The real input power is calculated by adding the simulated average input power from LTSpice and core loss. Output power is also calculated from the LTSpice. The efficiency of the converter is calculated from these values. Results are tabulated below.

Load | Pin (W) (without Pcore) | Pcore (W) | Pin (W) | Pout (W) | Ƞ (%)
100% 20V | 66.05 | 5.028 | 71.08 | 60.58 | 85.23
100% 40V | 62.9 | 3.3 | 66.2 | 58 | 87.61
50% 20V | 33.6 | 1.4 | 35 | 30.8 | 88
50% 40V | 33.719 | 1.287 | 35 | 31.3 | 89.41
25% 20V | 16.59 | 0.46 | 17.05 | 15.42 | 90.44
25% 40V | 15.797 | 0.448 | 16.24 | 14.65 | 90.18

Table 1 Efficiency Table for Different Load Conditions

From Table 1, it can be seen that efficiency is not below 83% which is the target value.

# Conclusion

To conclude, in this homework we have made magnetic design for a flyback converter transformer. We have decided on the turns ratio and calculated the operating duty cycle of the converter. The decisions and calculations were made using various parameters such as leakage inductance values and switching frequency. We have simulated the converter for two cases, ideal and non-ideal case. We have seen that the converter was not working properly without a snubber in the non-ideal case and we have realized that the switching component choice is extremely important for the flyback converter since the voltage and current stress on the switch is quite high. Moreover, we have decided to progress swiftly to realization of transformer for acquiring real transformer parameters such as leakage values.

# References

[1] W. (n.d.). Round Wire ac Resistance Calculator. https://chemandy.com/calculators/round-wire-ac-resistance-calculator.htm

[2]“Magnetics - Ferrite Core Loss Calculator.” https://www.mag-inc.com/Design/Design-Tools/Ferrite-Core-Loss-Calculator
