erdemcanaz/EE464-Emine-BOOSTanci/Magnetic Design/Magnetics-Ferrite-Core-Loss-Equations.xlsx

 |  |  | FERRITE MATERIAL
 |  |  | CORE LOSS CALCULATOR
 |  |  |  |  |  |  | Enter
 |  |  | PCL | Core Loss ( mW/cm3 ) |  |  | Values Here | Units
 |  |  | f | Frequency ( Hertz )* |  |  | 100000 | Hertz
 |  |  | B | Peak Flux Density ( Tesla ) |  |  | 0.1 | Tesla
 |  |  | T | Temperature (°C) |  |  | 60 | (°C)
 |  |  | L(T)= | b-c(T)+d(T2) For All Other Temperatures
 |  |  | L(T) = | 1 for 100°C
 |  |  |  |  |  |  |  | Core Loss
Material | Frequency Range | a | x | y | b | c | d | PCL
 |  |  |  |  |  |  |  | ( mW/cm3 )
R Material | 20kHz-150kHz | 3.53 | 1.420 | 2.880 | 1.970000000 | 0.022260000 | 0.0001250000 | 63.53
 | 150kHz-400kHz | 0.000588 | 2.120 | 2.700 | 2.160000000 | 0.023270000 | 0.0001170000
P Material | 20kHz-200kHz | 3.2 | 1.460 | 2.750 | 2.450000000 | 0.031000000 | 0.0001650000 | 134.43
F Material | 10kHz-200kHz | 3.5 | 1.400 | 2.500 | 0.880000000 | 0.013000000 | 0.0001420000 | 67.65
T Material | 20kHz-150kHz | 92.1664345 | 1.045 | 2.440 | 1.332363000 | 0.007939800 | 0.0000461615 | 57.42
 | 150kHz-300kHz | 0.00747062 | 1.955 | 3.070 | 1.654230800 | 0.012600000 | 0.0000605769
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
