erdemcanaz/EE464-Emine-BOOSTanci/datasheet/figures/pout_efficiency.png

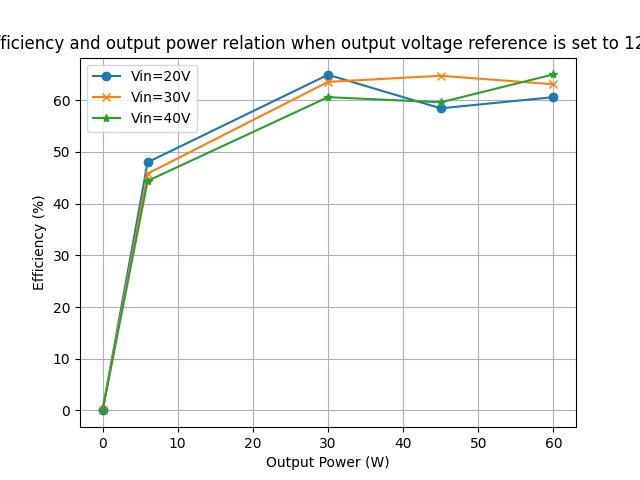
datasheet/figures/pout_efficiency.png
