erdemcanaz/EE464-Emine-BOOSTanci/datasheet/figures/pout_maxmostemp.png

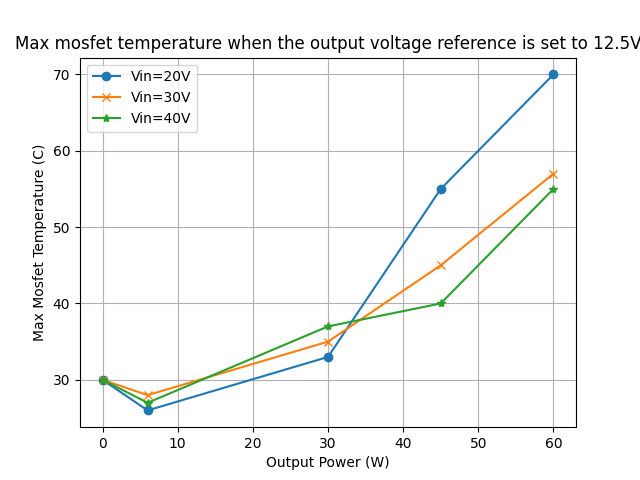
datasheet/figures/pout_maxmostemp.png
