erdemcanaz/EE464-Emine-BOOSTanci/datasheet/figures/pout_maxtemp.png

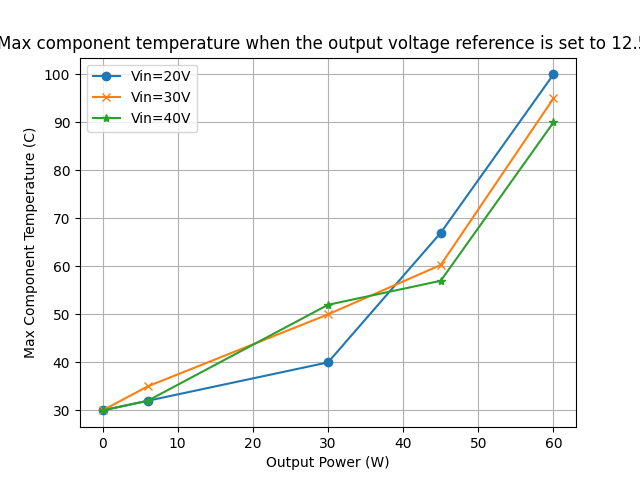
datasheet/figures/pout_maxtemp.png
