erdemcanaz/EE464-Emine-BOOSTanci/datasheet/figures/pout_pin.png

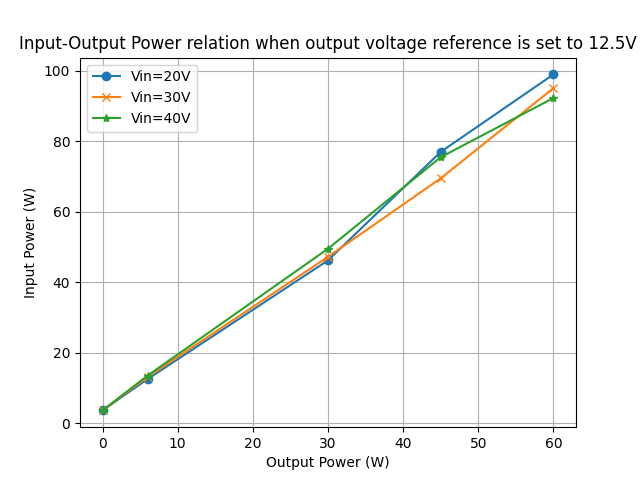
datasheet/figures/pout_pin.png
