erdemcanaz/EE464-Emine-BOOSTanci/datasheet/figures/pout_vout.png

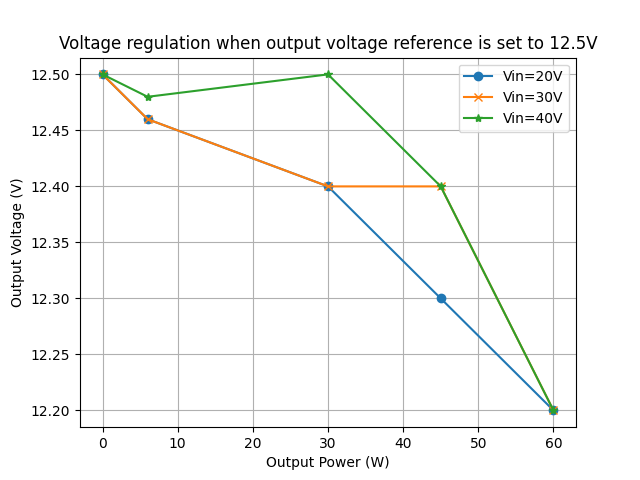
datasheet/figures/pout_vout.png
