erdemcanaz/EE464-Emine-BOOSTanci/Demo circuit/circuit schematic.png

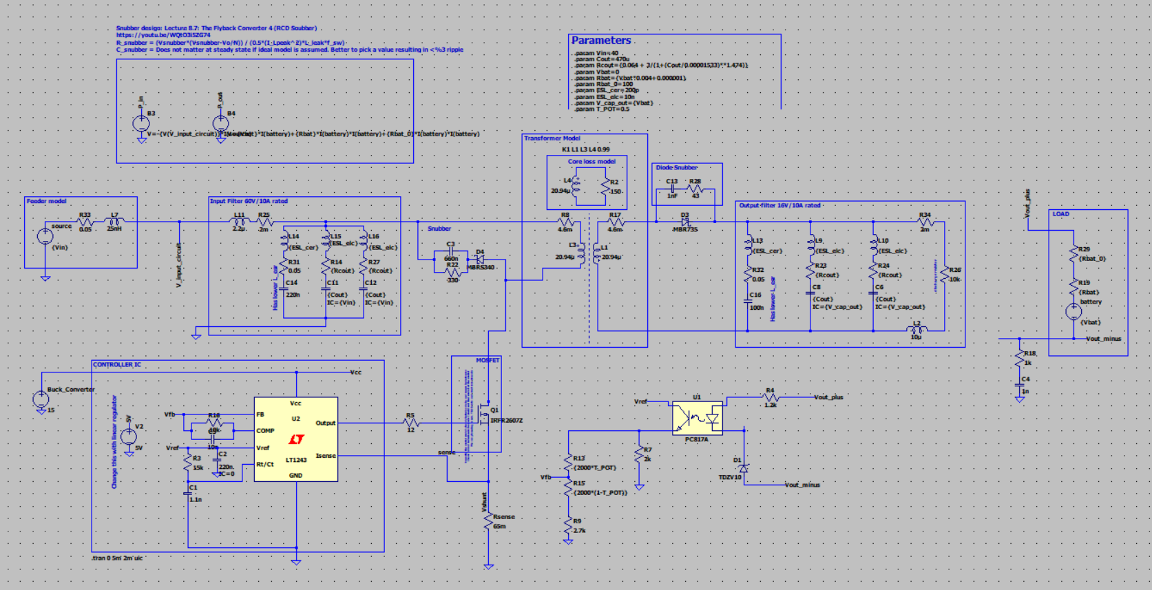
Demo circuit/circuit schematic.png
