erdemcanaz/EE464-Emine-BOOSTanci/Final report/power_distrubiton.png

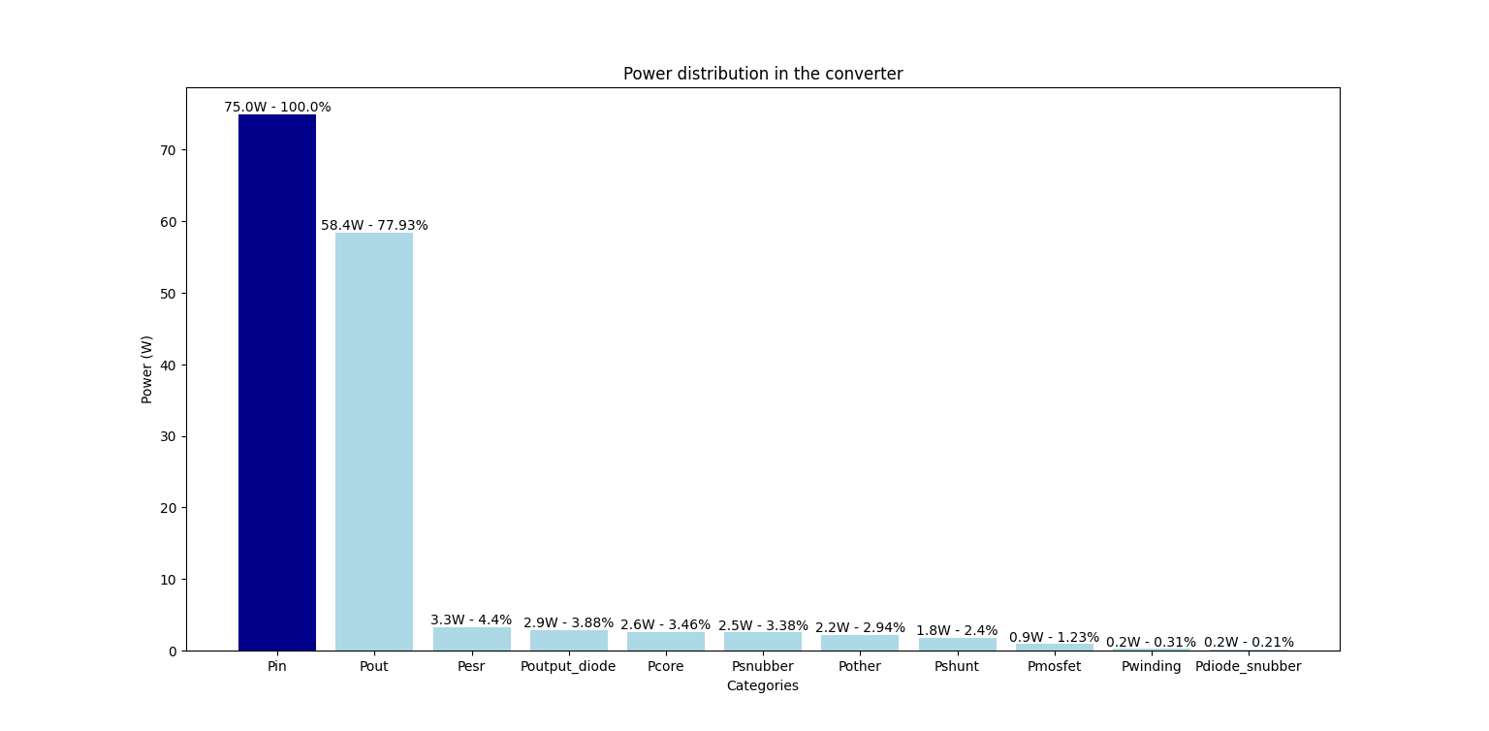
Final report/power_distrubiton.png
