erdemcanaz/EE464-Emine-BOOSTanci/Components/components.xlsx

diode | ringing 70V, 8A
mos | ringing 70V, Rds küçük olacak, akımı 42A çünkü patlarız diye korktuk
IXTP44N10T | https://ozdisan.com/guc-yari-iletkenleri/mosfetler/discrete-mosfetler/IXTP44N10T/340340
IRF540N | https://ozdisan.com/guc-yari-iletkenleri/mosfetler/discrete-mosfetler/IRF540NPBF/3488 | 3
IRFU3710ZPbF | https://ozdisan.com/guc-yari-iletkenleri/mosfetler/discrete-mosfetler/IRFR3710ZTRPBF/652386
DSA30C100PB | https://ozdisan.com/guc-yari-iletkenleri/diyotlar-modul-diyotlar-ve-dogrultucular/schottky-diyotlar/DSA30C100PB/483083 | 10
ACS712-30A | https://www.direnc.net/acs712-30a-smd-akim-sensoru-entegresi-soic8 | 4
ACS712 | https://www.direnc.net/acs712-akim-sensoru-30a-30a-modul | 4
LM78L12/TA-HTC | https://www.direnc.net/lm78l12/ta-htc-12v-100ma-lineer-voltaj-regulator-to92-3 | 3
LM78L15F-HTC | https://ozdisan.com/entegre-devreler-icler/guc-entegreleri/lineer-voltaj-regulatorleri/LM78L15F-HTC/587705 | 3
LM2596 | https://www.robolinkmarket.com/lm2596-ayarlanabilir-dc-dc-voltaj-regulatoru | 2
UC3845AN | https://ozdisan.com/entegre-devreler-icler/guc-entegreleri/dc-dc-voltaj-kontrolorleri/UC3845AN/501245 | 3
1N5351B | https://ozdisan.com/guc-yari-iletkenleri/diyotlar-modul-diyotlar-ve-dogrultucular/zener-diyotlar/1N5351B/14573 | 10
PKLH-063V471MH200-T/A5.0 | https://ozdisan.com/pasif-komponentler/kapasitorler/aluminyum-kapasitorler/PKLH-063V471MH200-TA5-0/465839 | 10
PKLH-063V102MJ355 | https://ozdisan.com/pasif-komponentler/kapasitorler/aluminyum-kapasitorler/PKLH-063V102MJ355/345727 | 10
PKLH-016V471MG125-T/A5.0 | https://ozdisan.com/pasif-komponentler/kapasitorler/aluminyum-kapasitorler/PKLH-016V471MG125-TA5-0/342170 | 10
PKLH-016V102MG200 | https://ozdisan.com/pasif-komponentler/kapasitorler/aluminyum-kapasitorler/PKLH-016V102MG200/501035 | 10
LTV-816 | https://ozdisan.com/optolar-ve-sensorler/optolar/transistor-ve-fotovoltaik-cikisli-optokuplorler/LTV-816/356190 | 10
LM358L-D08-T | https://ozdisan.com/entegre-devreler-icler/lineer-entegreler/amplifikatorler/LM358L-D08-T/502650 | 10
DELİKLİ PERTİNAKS 10X10 | https://ozdisan.com/maker-ve-iot-urunleri/maker-arac-ve-gerecleri/prototipleme-devreleri/DELIKLI-PERTINAKS-10X10/643012 | 3
DELİKLİ PERTİNAKS 5X5 | https://ozdisan.com/maker-ve-iot-urunleri/maker-arac-ve-gerecleri/prototipleme-devreleri/DELIKLI-PERTINAKS-5X5/643014 | 5
OZDAS0098EL25 | https://ozdisan.com/elektromekanik-komponentler/sogutucular/aluminyum-sogutucular/OZDAS0098EL25/495565 | 2
145AS15 AL. SOĞUTUCU | https://ozdisan.com/elektromekanik-komponentler/sogutucular/aluminyum-sogutucular/145AS15-AL-SOGUTUCU/443451 | 6
1R 5W Taş Direnç | https://www.direnc.net/1r-5w-tas-direnc | 5
3.3R 5W Taş Direnç | https://www.direnc.net/33r-5w-tas-direnc-1 | 5
6.8R 5W Taş Direnç | https://www.direnc.net/68r-5w-tas-direnc-1 | 5
10R 5W Taş Direnç | https://www.direnc.net/10r-5w-tas-direnc | 5
33R 5W Taş Direnç | https://www.direnc.net/33r-5w-tas-direnc | 5
68R 5W Taş Direnç | https://www.direnc.net/68r-5w-tas-direnc | 5
100R 5W Taş Direnç | https://www.direnc.net/100r-5w-tas-direnc | 5
680R 5W Taş Direnç | https://www.direnc.net/1r-5w-tas-direnc-11673 | 5
330R 5W Taş Direnç | https://www.direnc.net/330r-5w-tas-direnc | 5
1KR 5W Taş Direnç | https://www.direnc.net/1k-5w-tas-direnc | 5
2'li Bariyer Klemens | https://www.direnc.net/2li-bariyer-klemens | 5
10uH 12X12 10A | https://www.direnc.net/10uh-12x12-10a-smd-guc-bobini-sri1209 | 3
10uH 12X12 9.2A | https://www.direnc.net/10uh-12x12-92a-smd-guc-bobini-sri1207 | 3
IRF3710PBF | https://ozdisan.com/guc-yari-iletkenleri/mosfetler/discrete-mosfetler/IRF3710PBF/39256 | 3
IRF3710Z | https://www.arkotekelektronik.com/irf3710z-to-220?gad_source=1 | 5
