erdemcanaz/EE464-Emine-BOOSTanci/Demo circuit/measurement_points.txt

#######################
GND-1
vin_beforefilter
vin_afterfilter
mosfet_drain

IC_output
IC_FB
IC_comp
IC_rtct
IC_Isense

opto_feedback_voltage

snubber_positive
snubber_negative

output_current (additional acs712 will be used)

######################
GND-2
vout_afterfilter
vout_transformer
vout_beforefilter
