erdemcanaz/EE464-Emine-BOOSTanci/Demo circuit/lm741 files/webpage.pdf

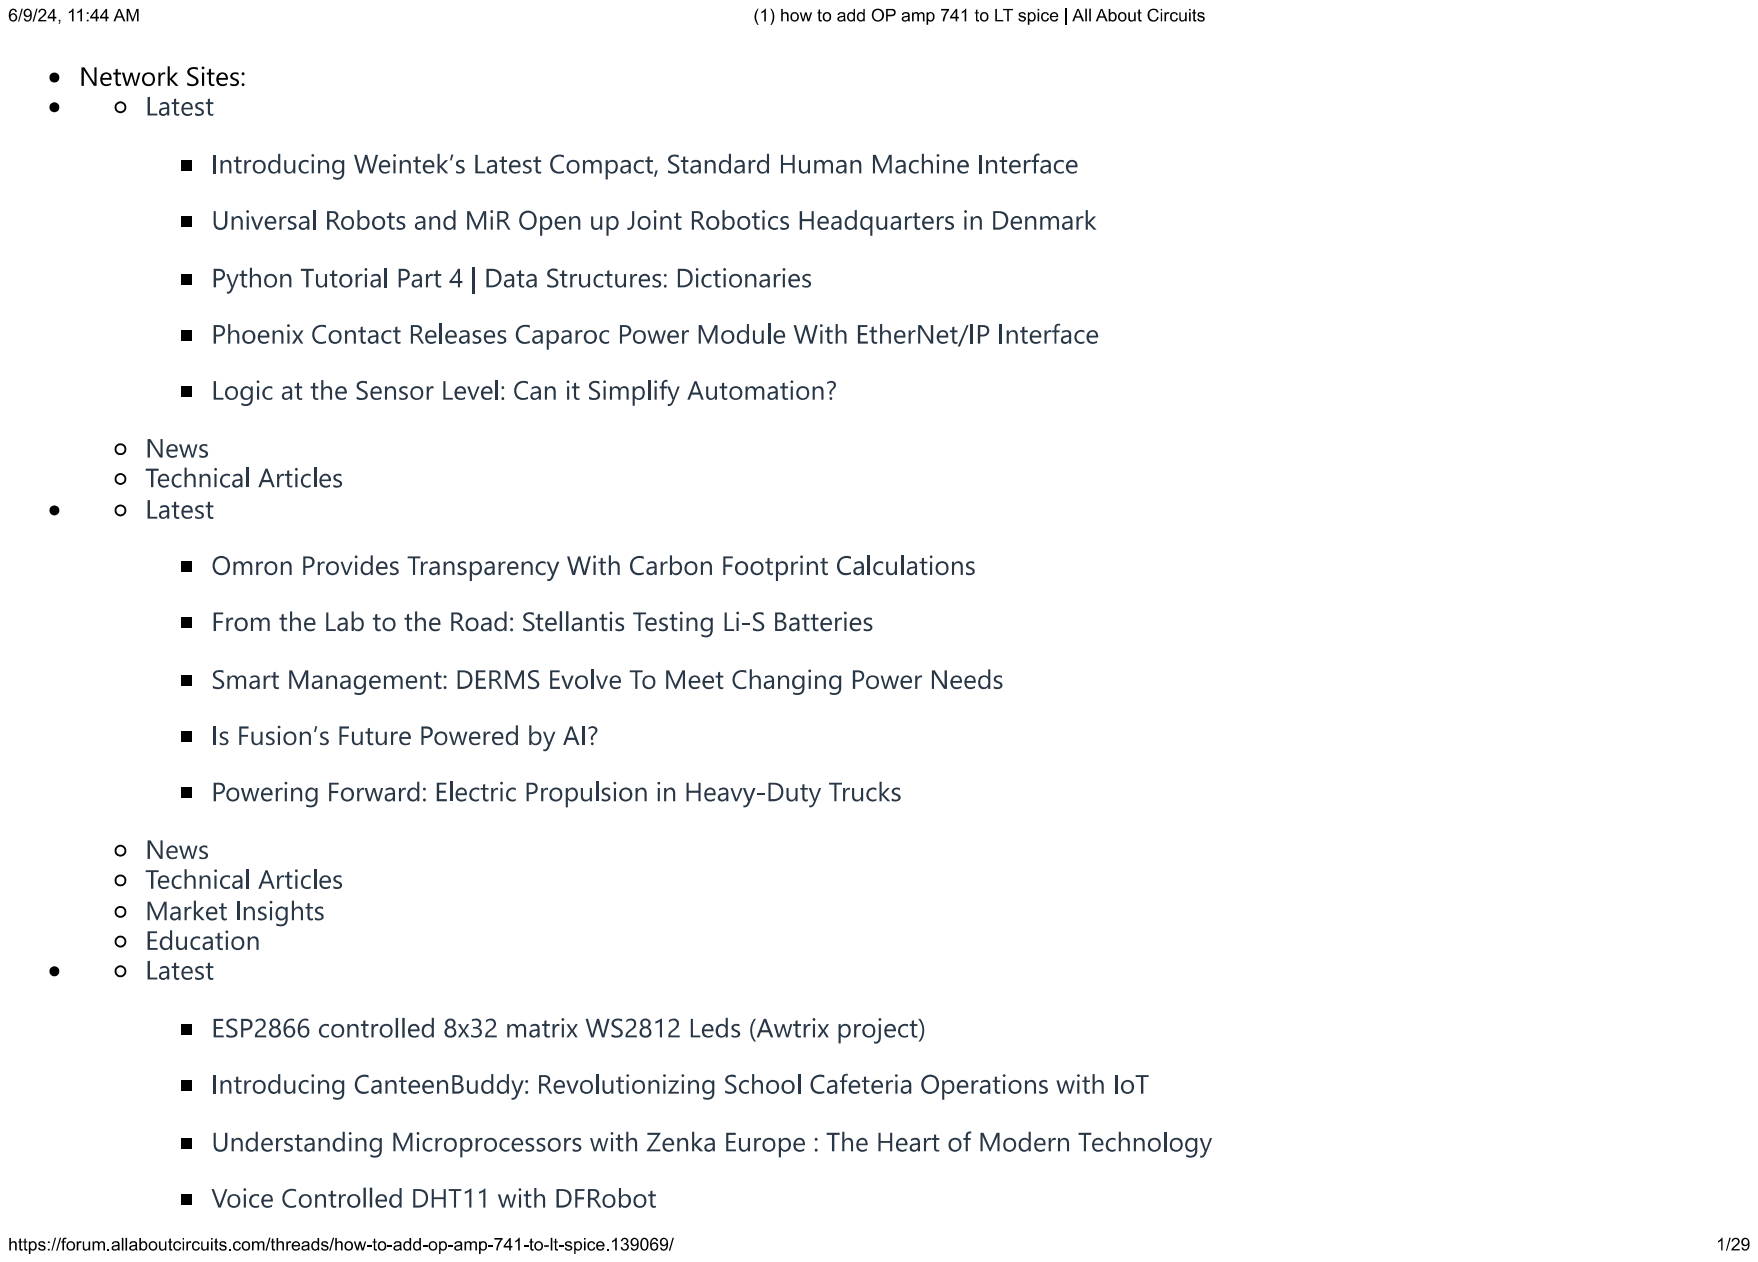
[picture p128: page 1]

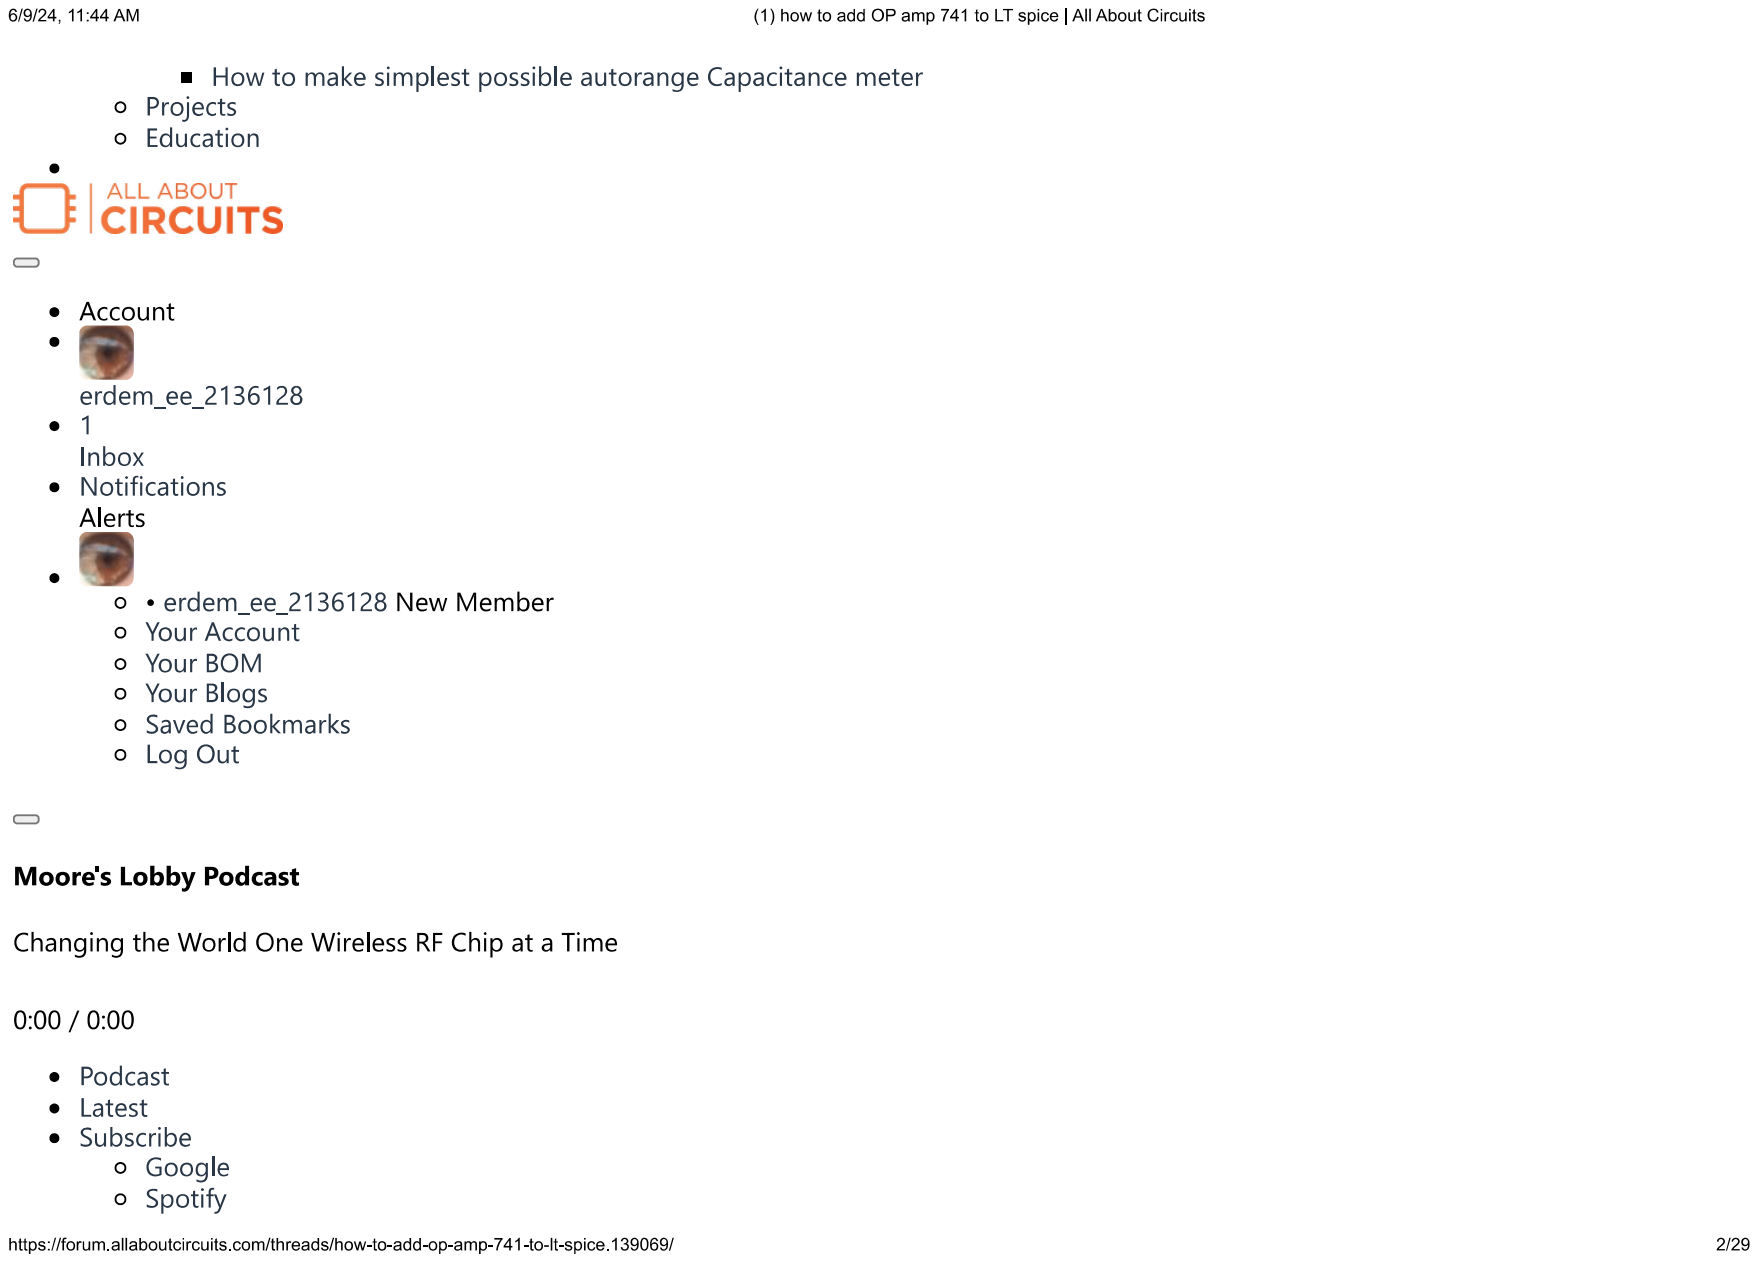
[picture p129: page 2]

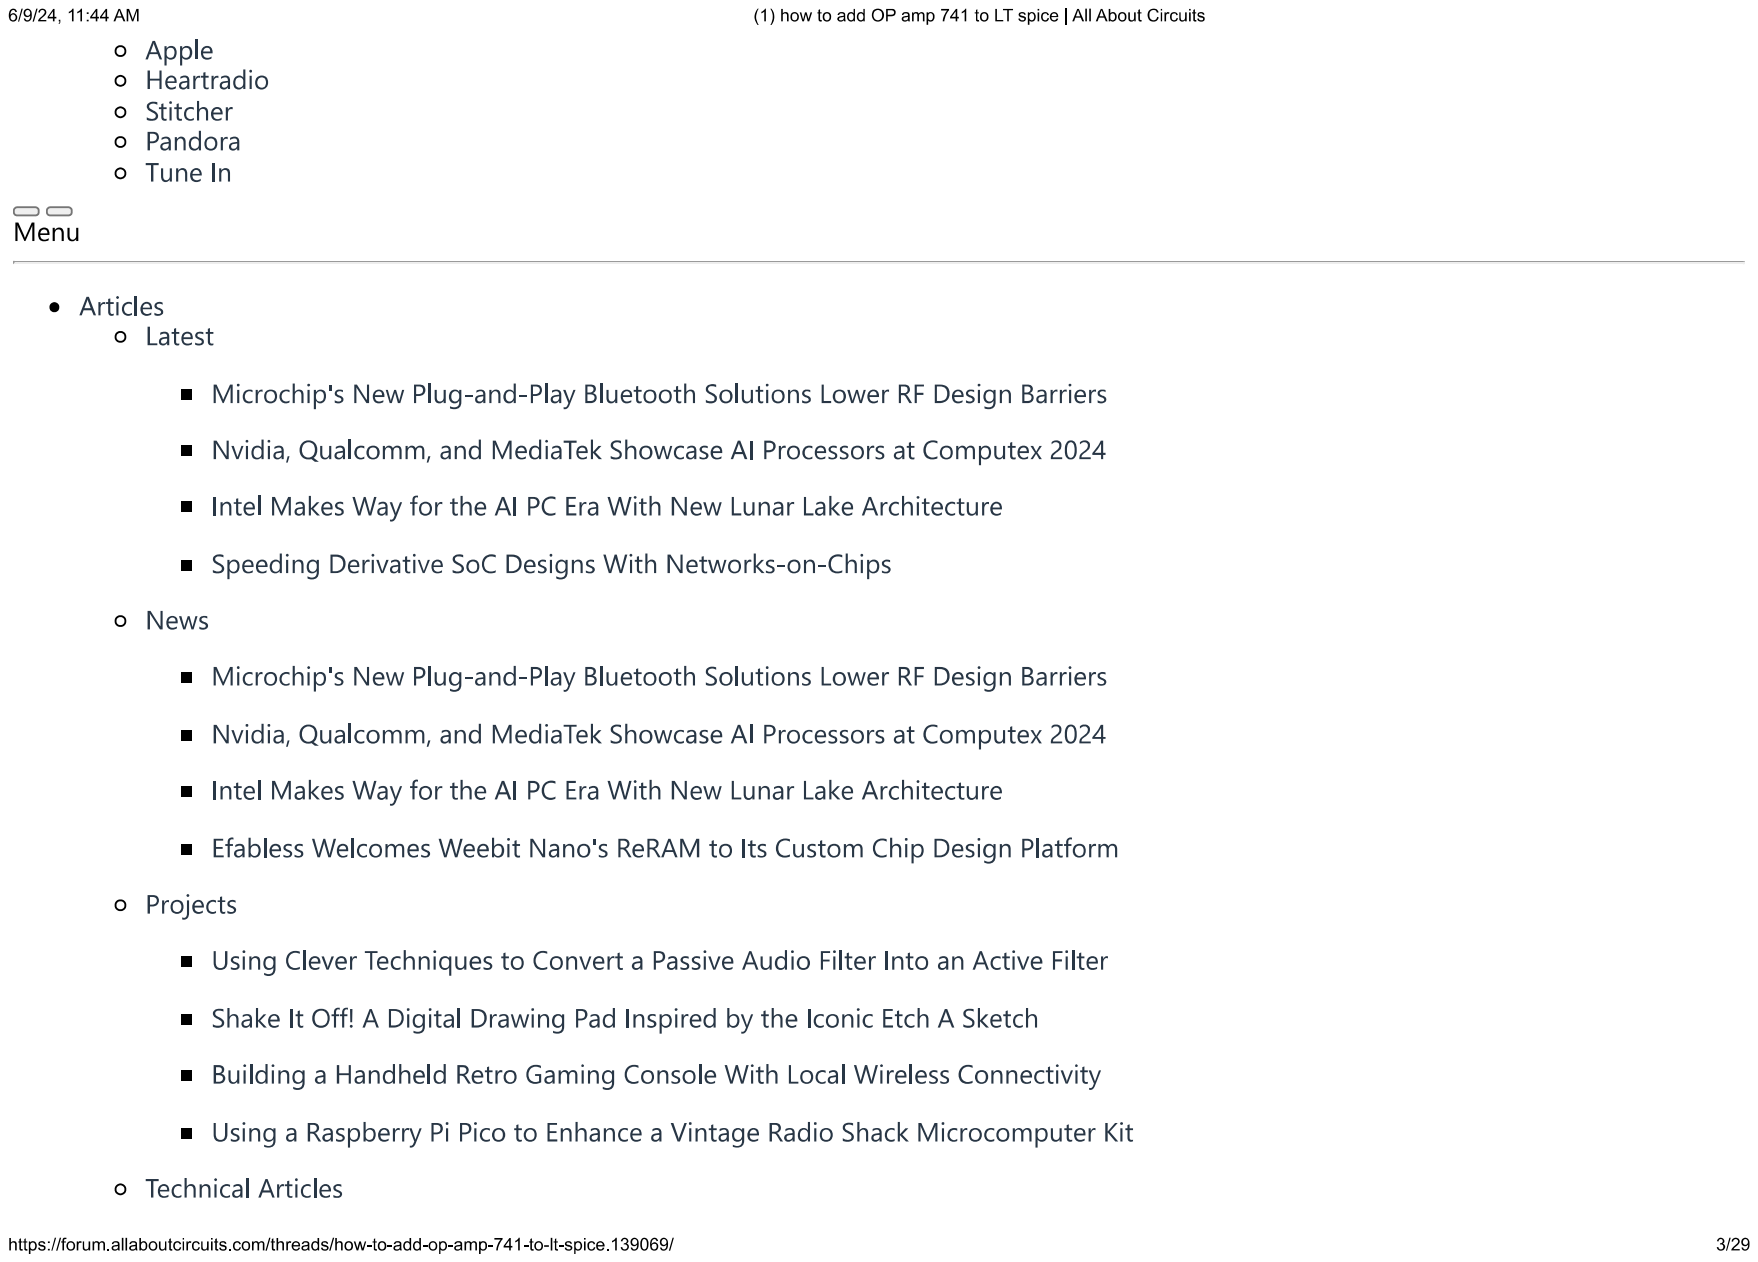
[picture p130: page 3]

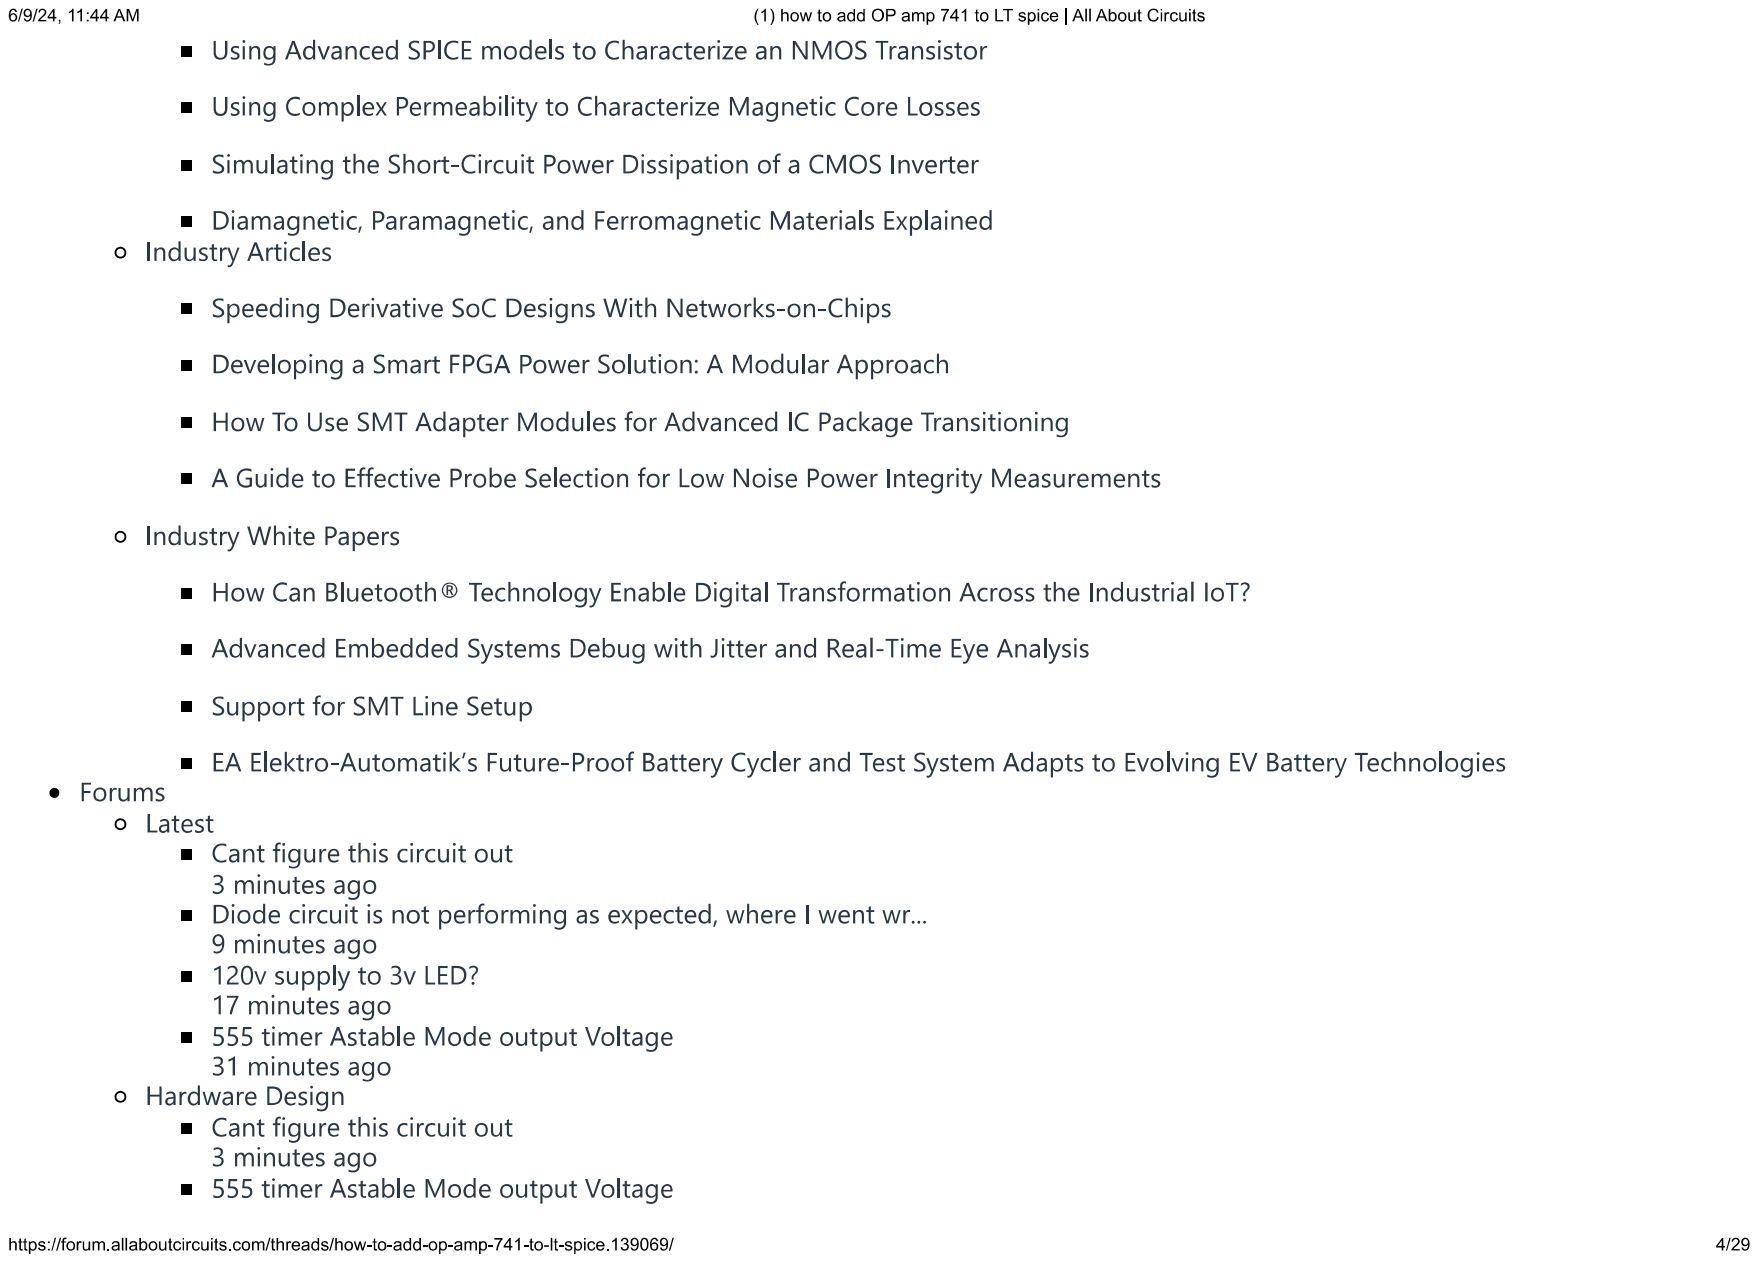
[picture p131: page 4]

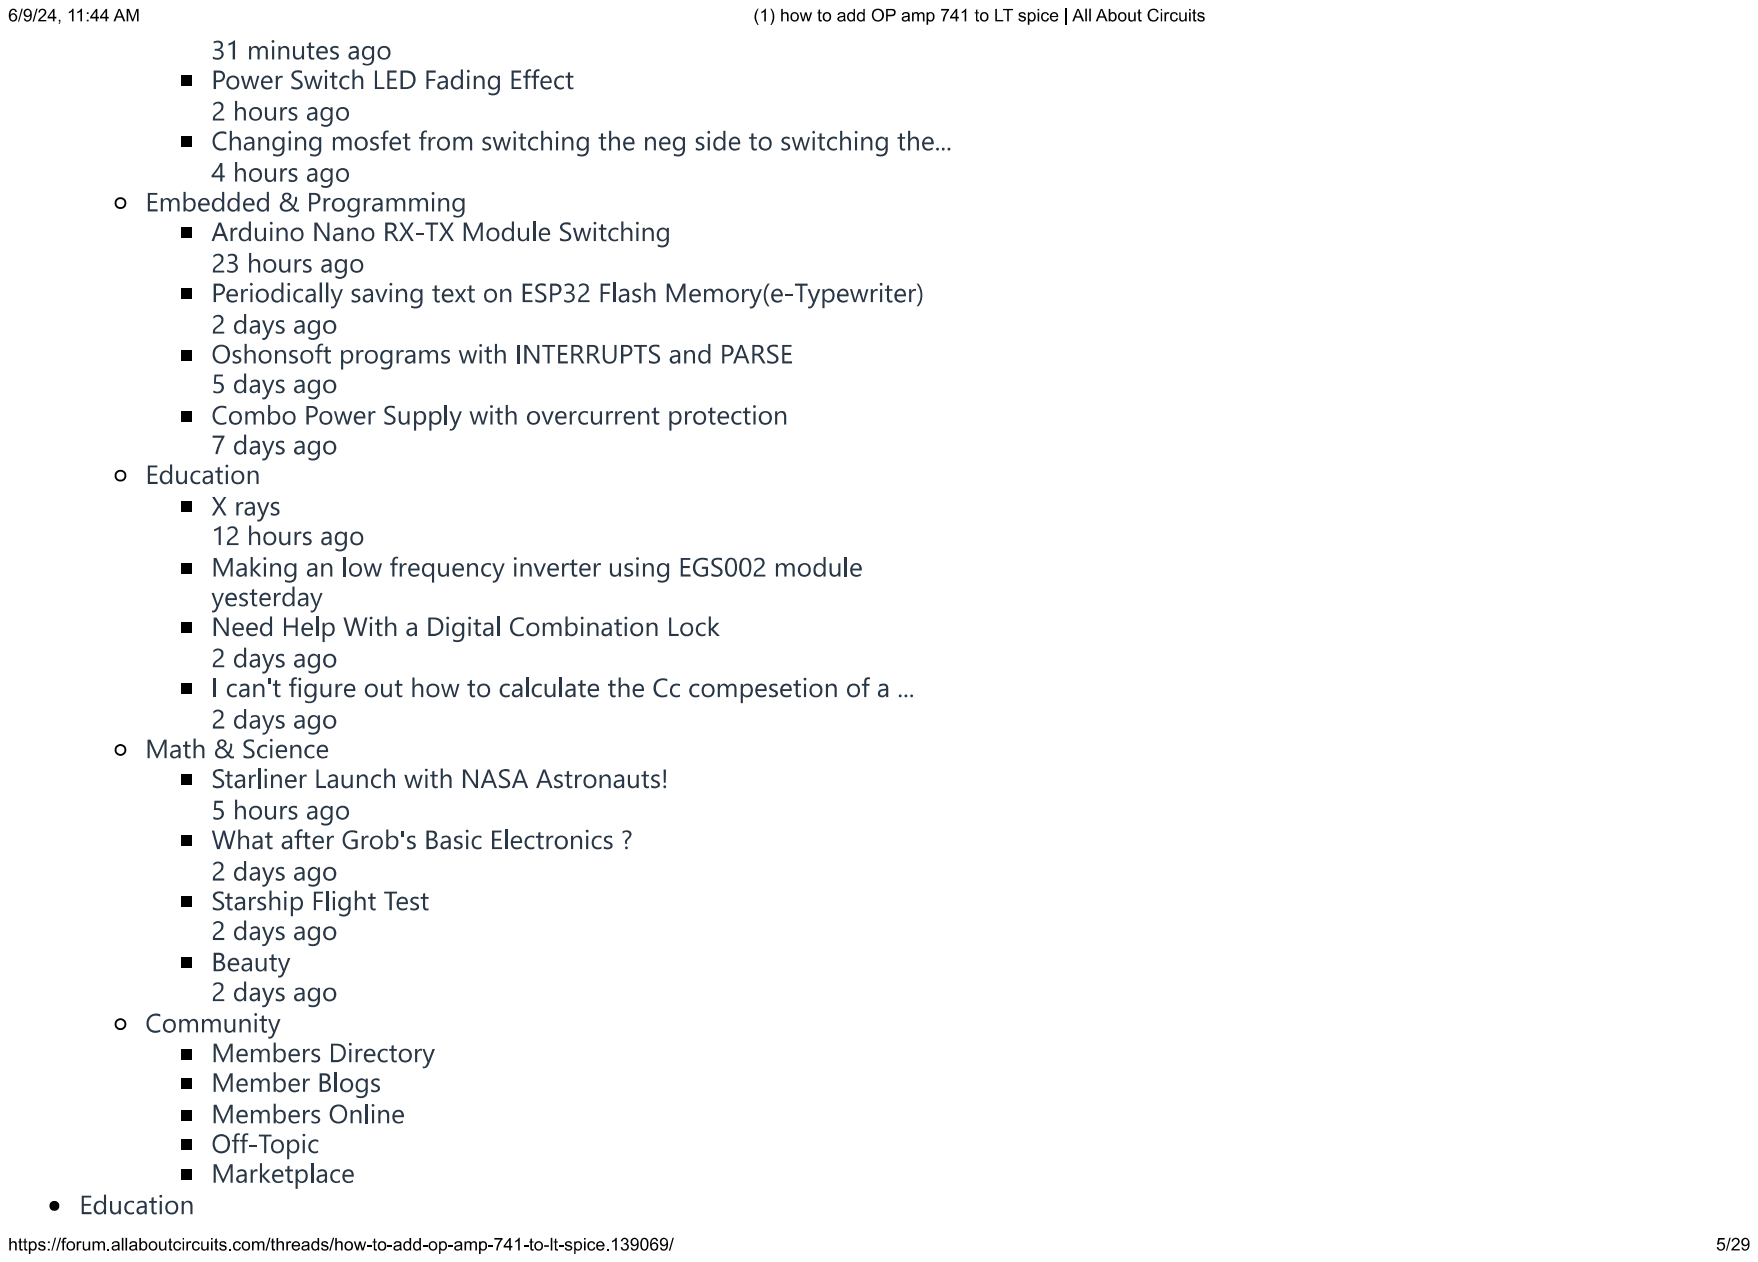
[picture p132: page 5]

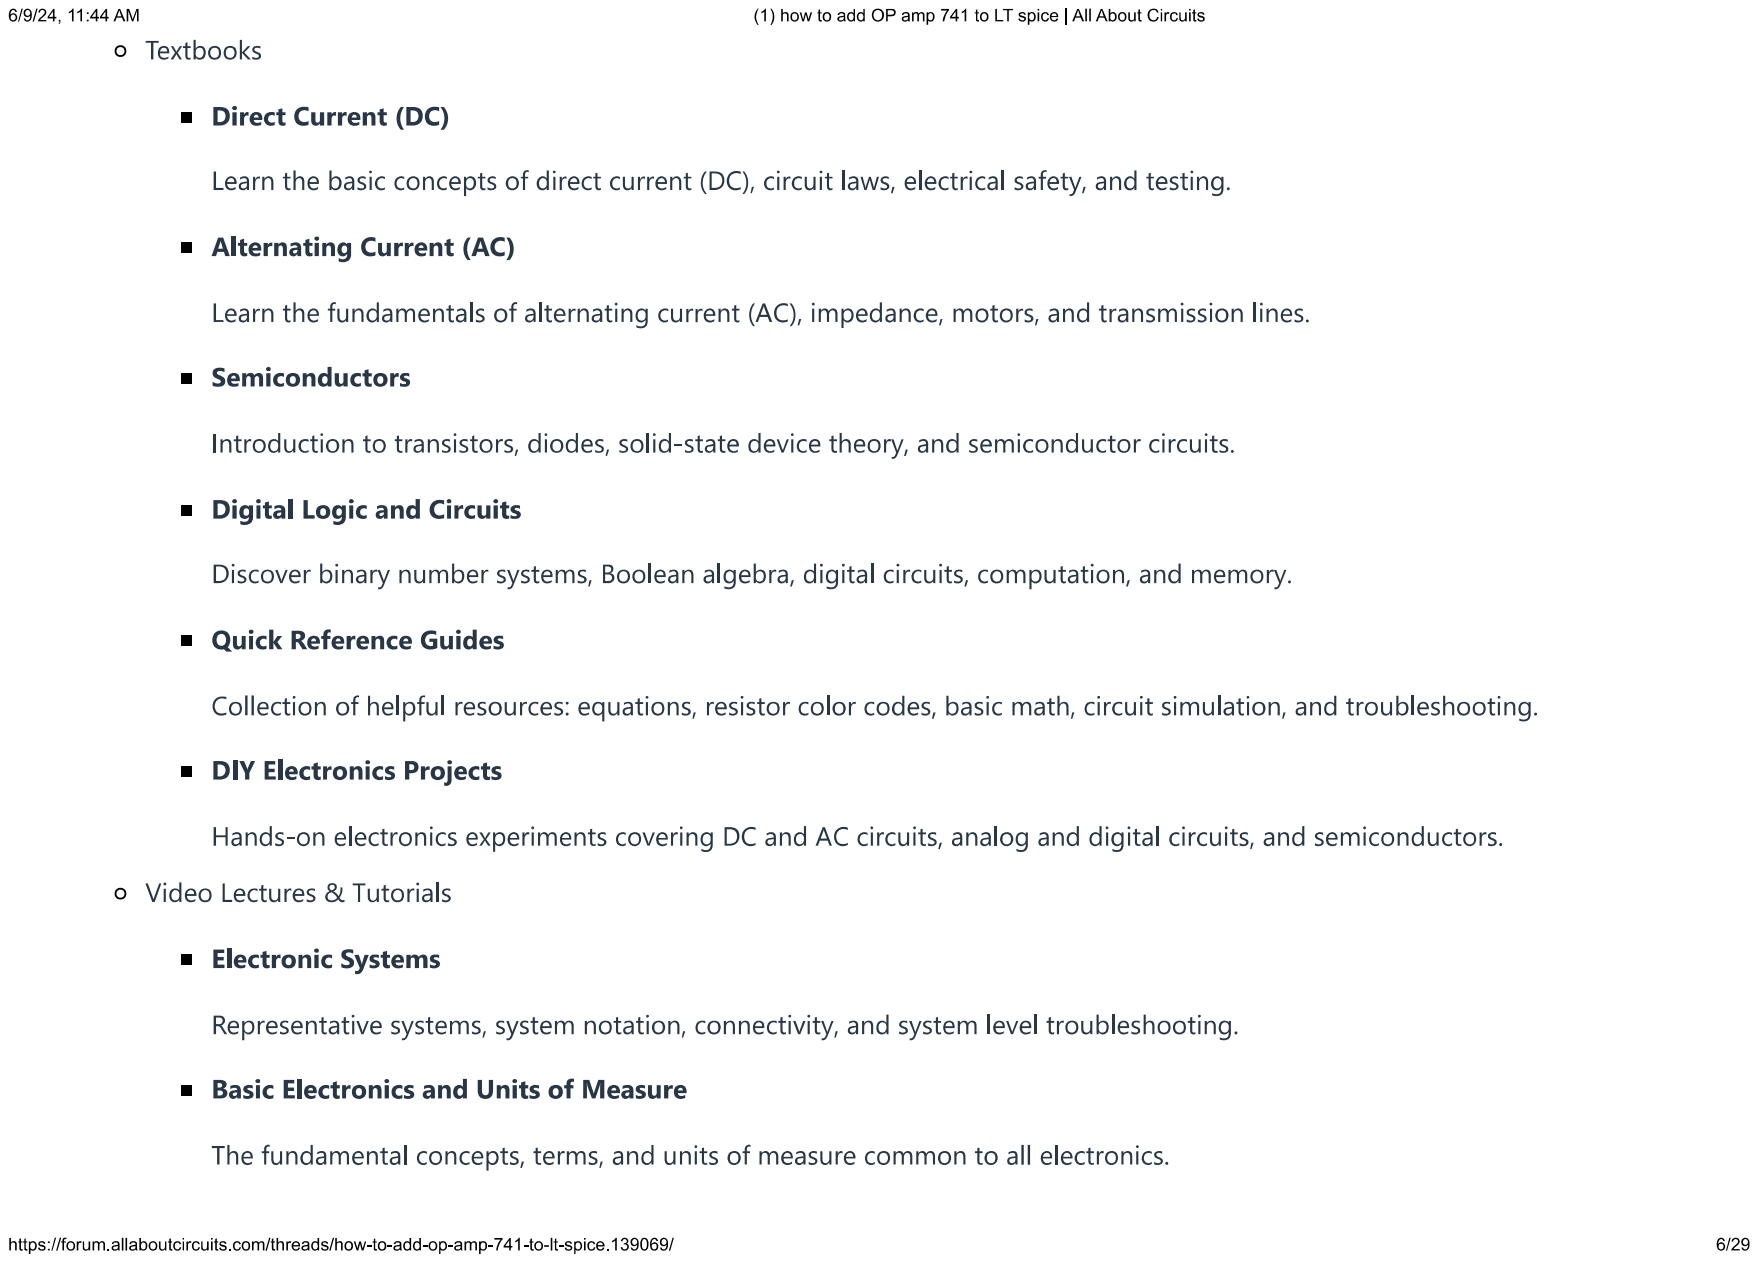
[picture p133: page 6]

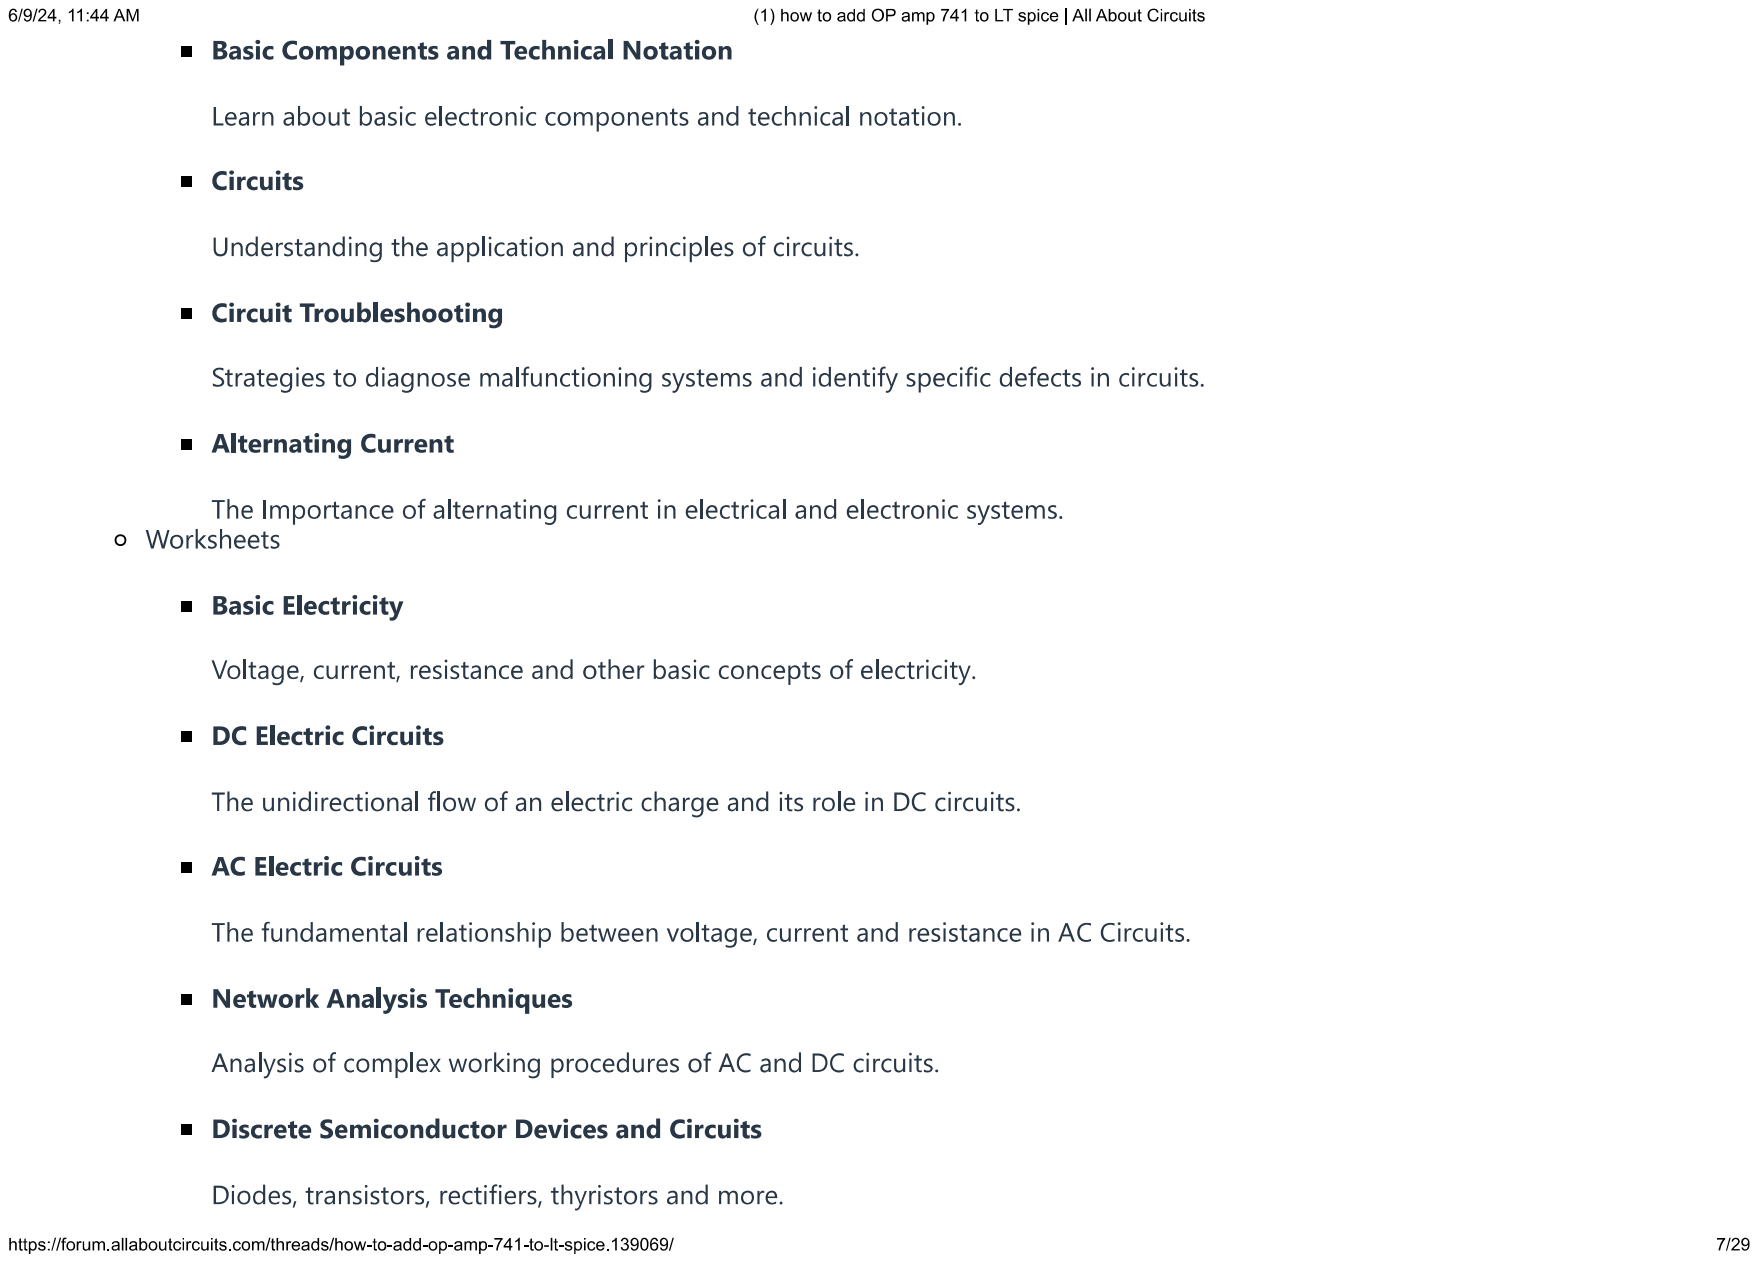
[picture p134: page 7]

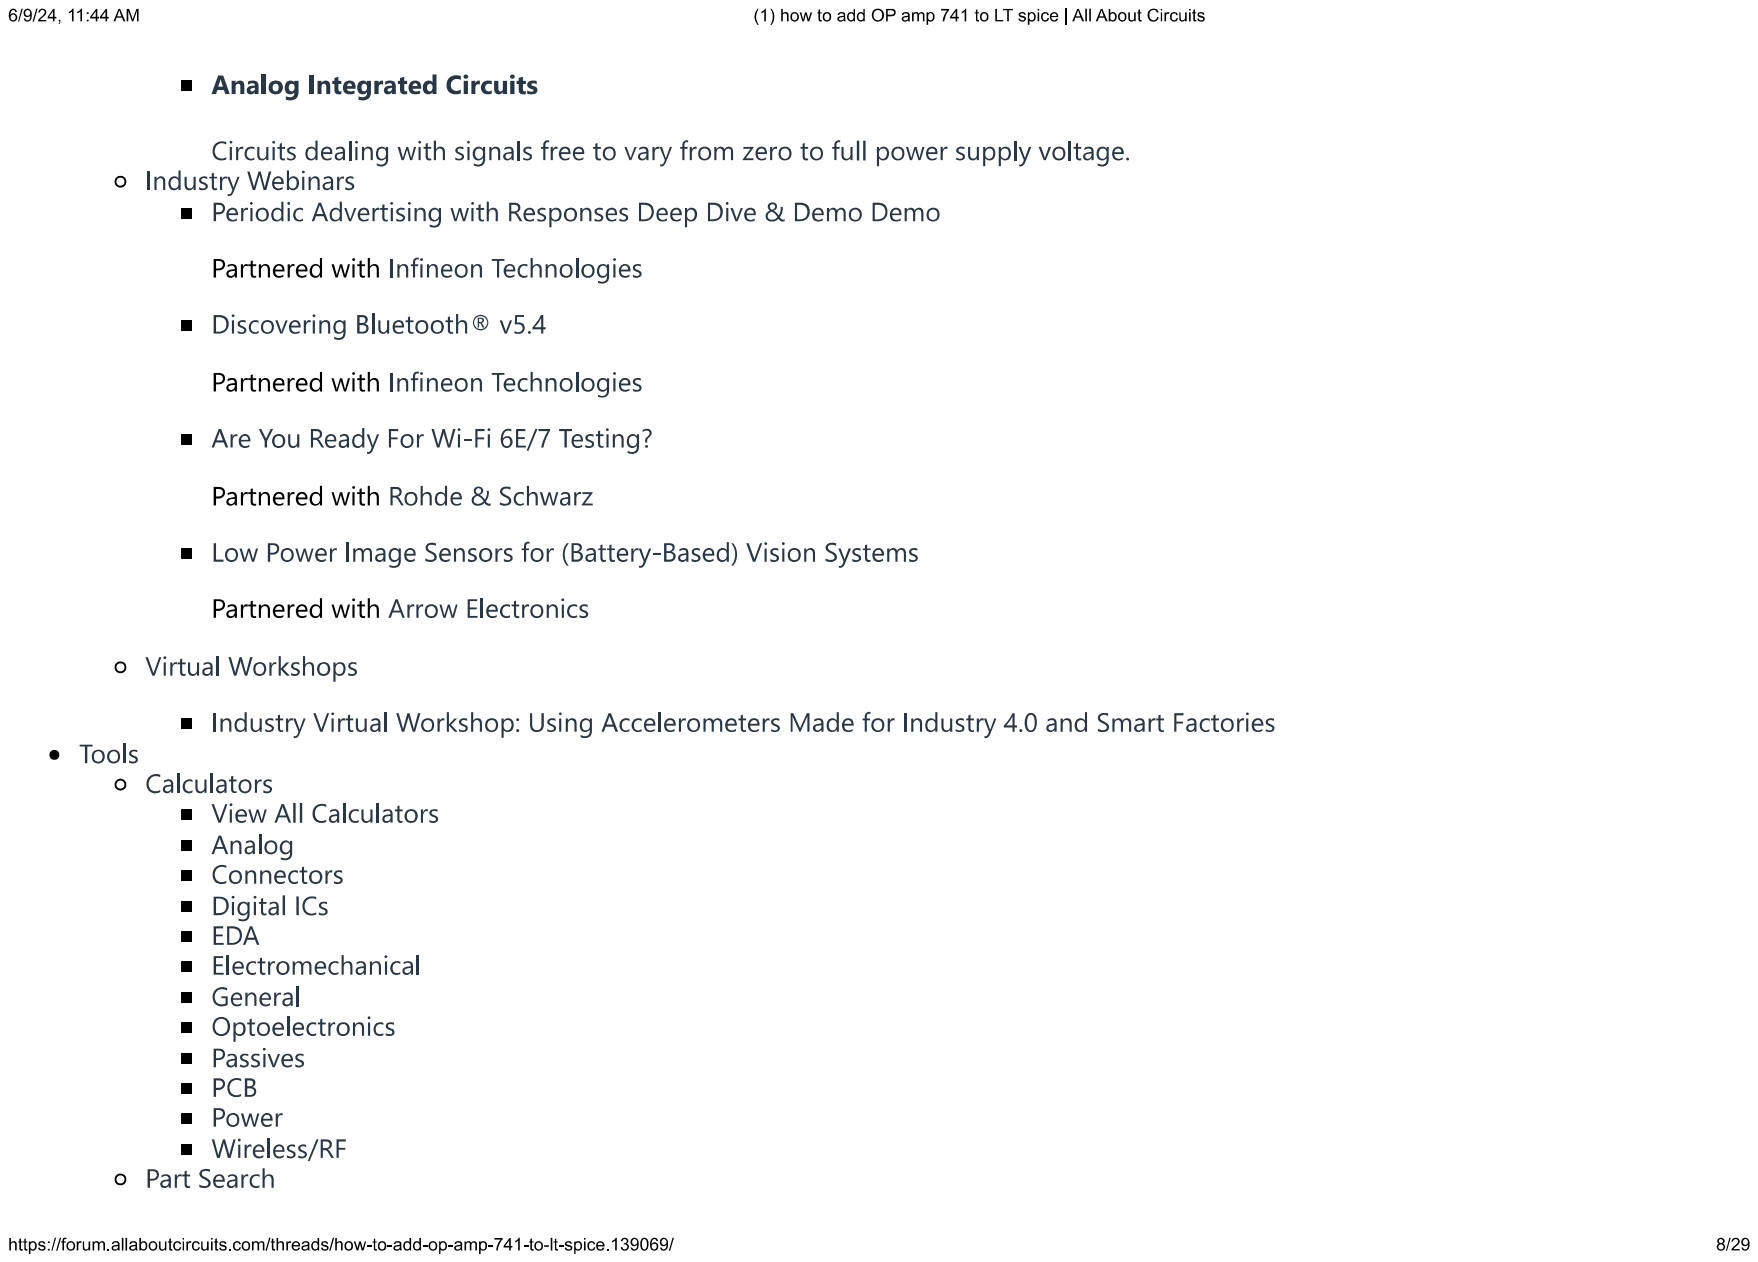
[picture p135: page 8]

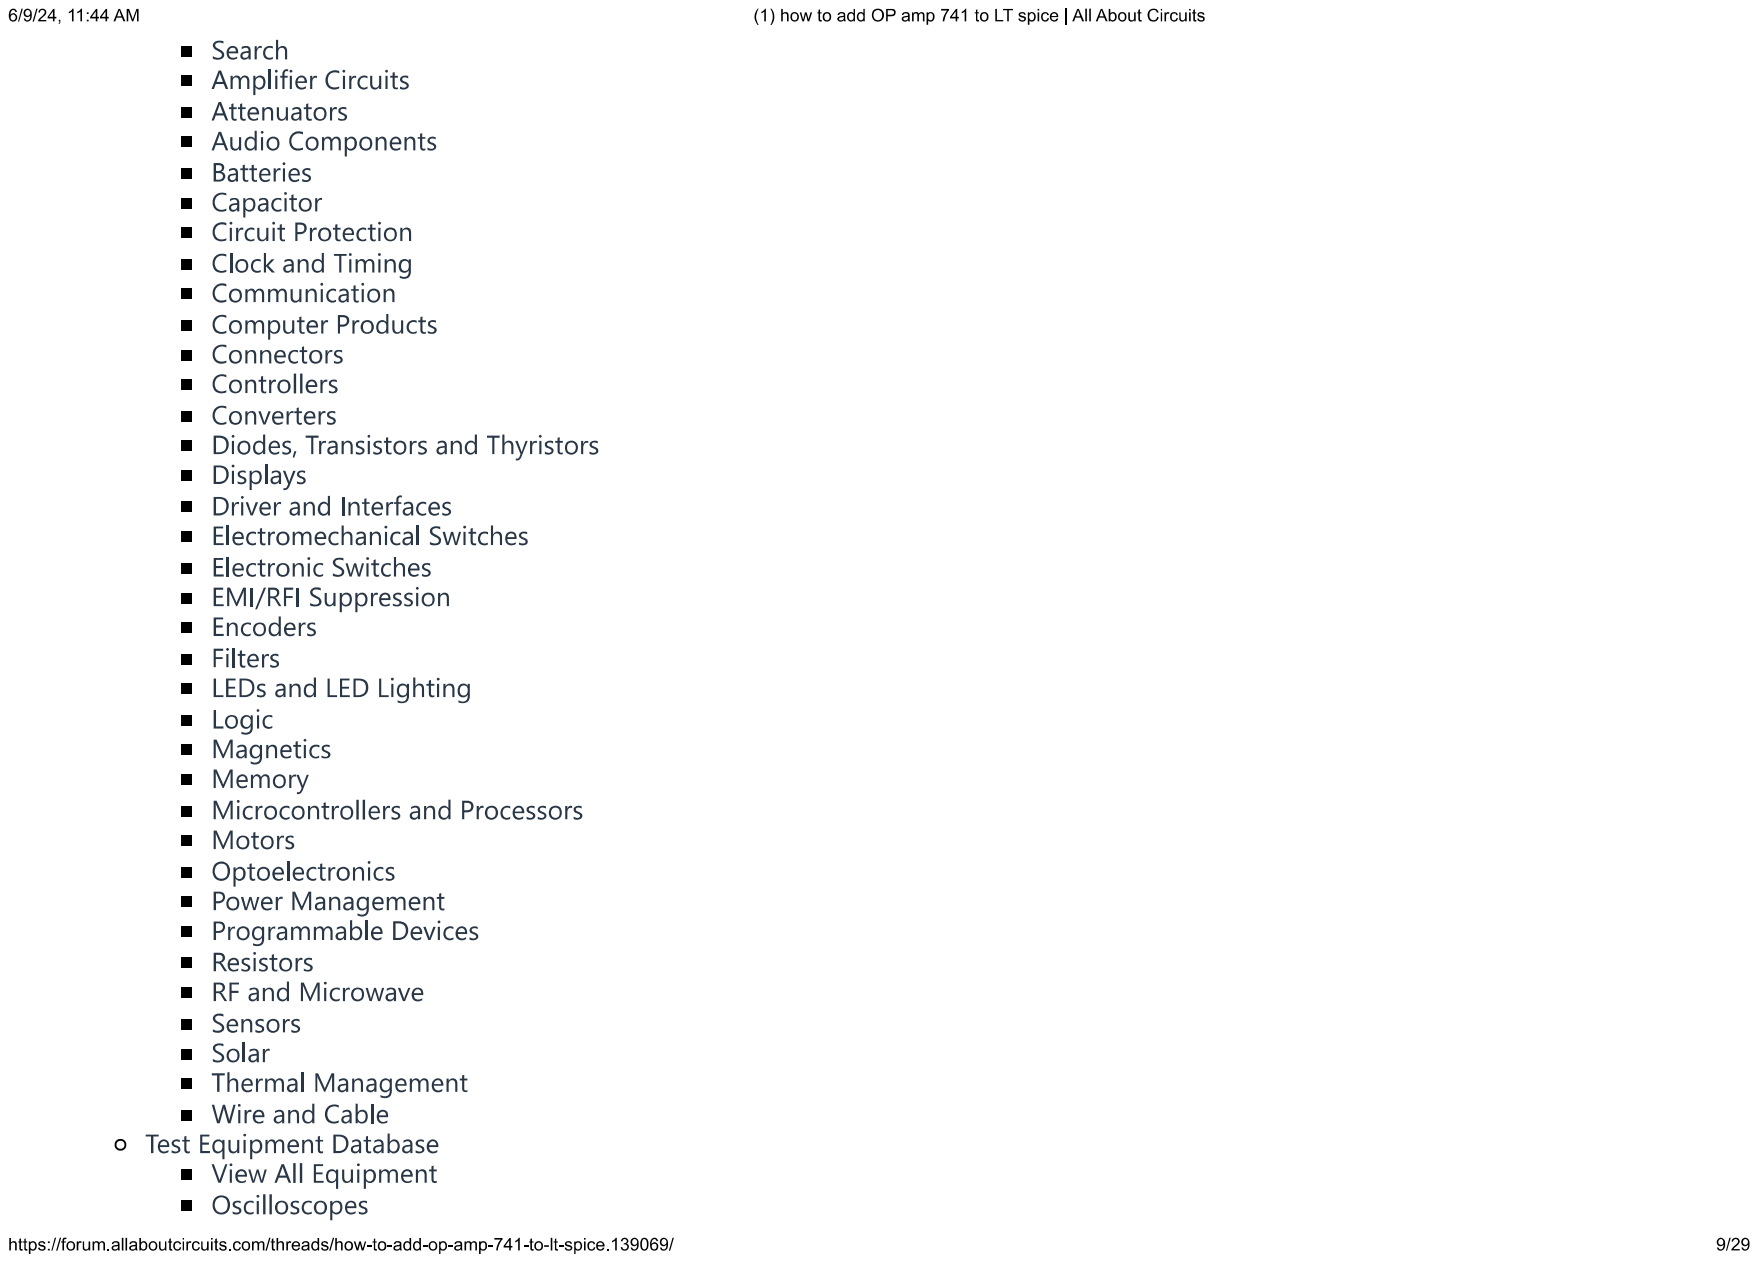
[picture p136: page 9]

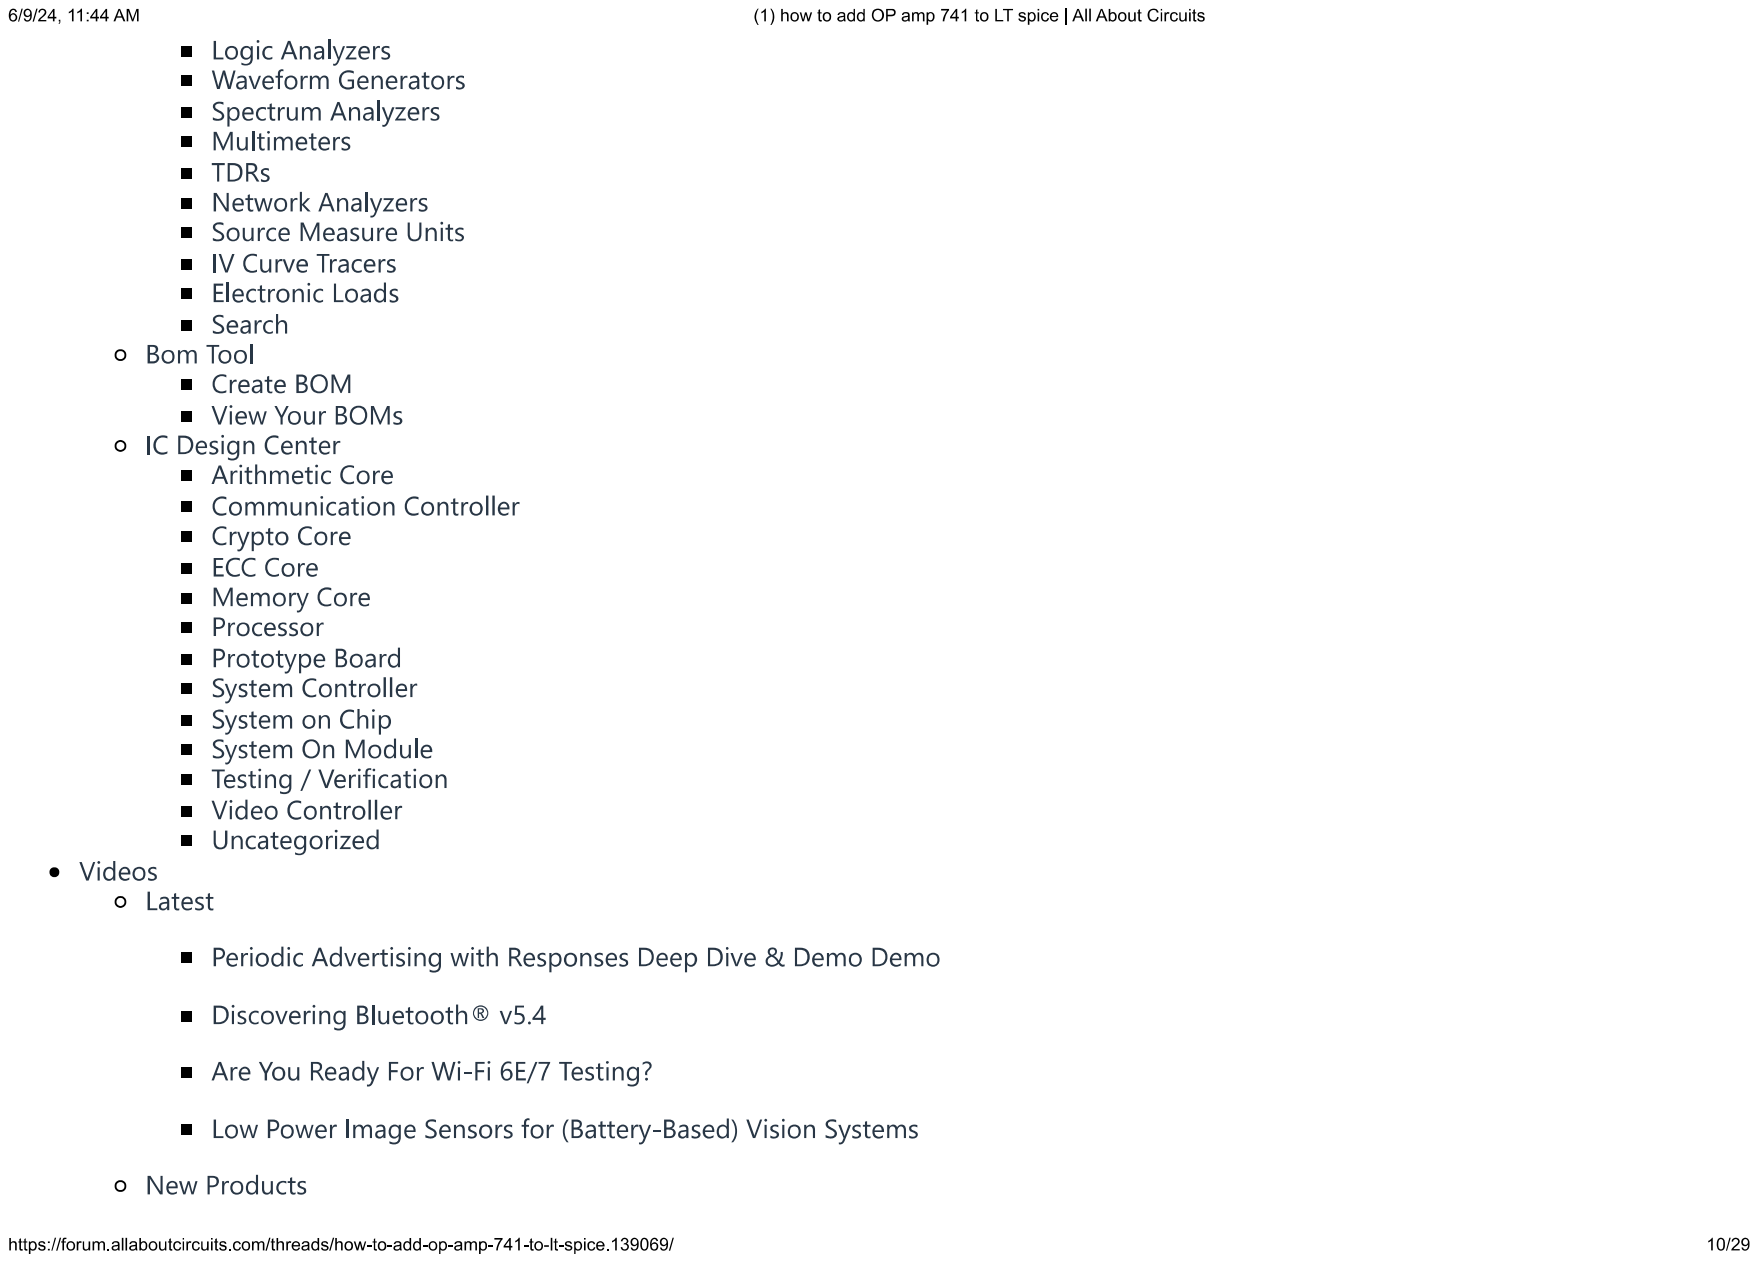
[picture p137: page 10]

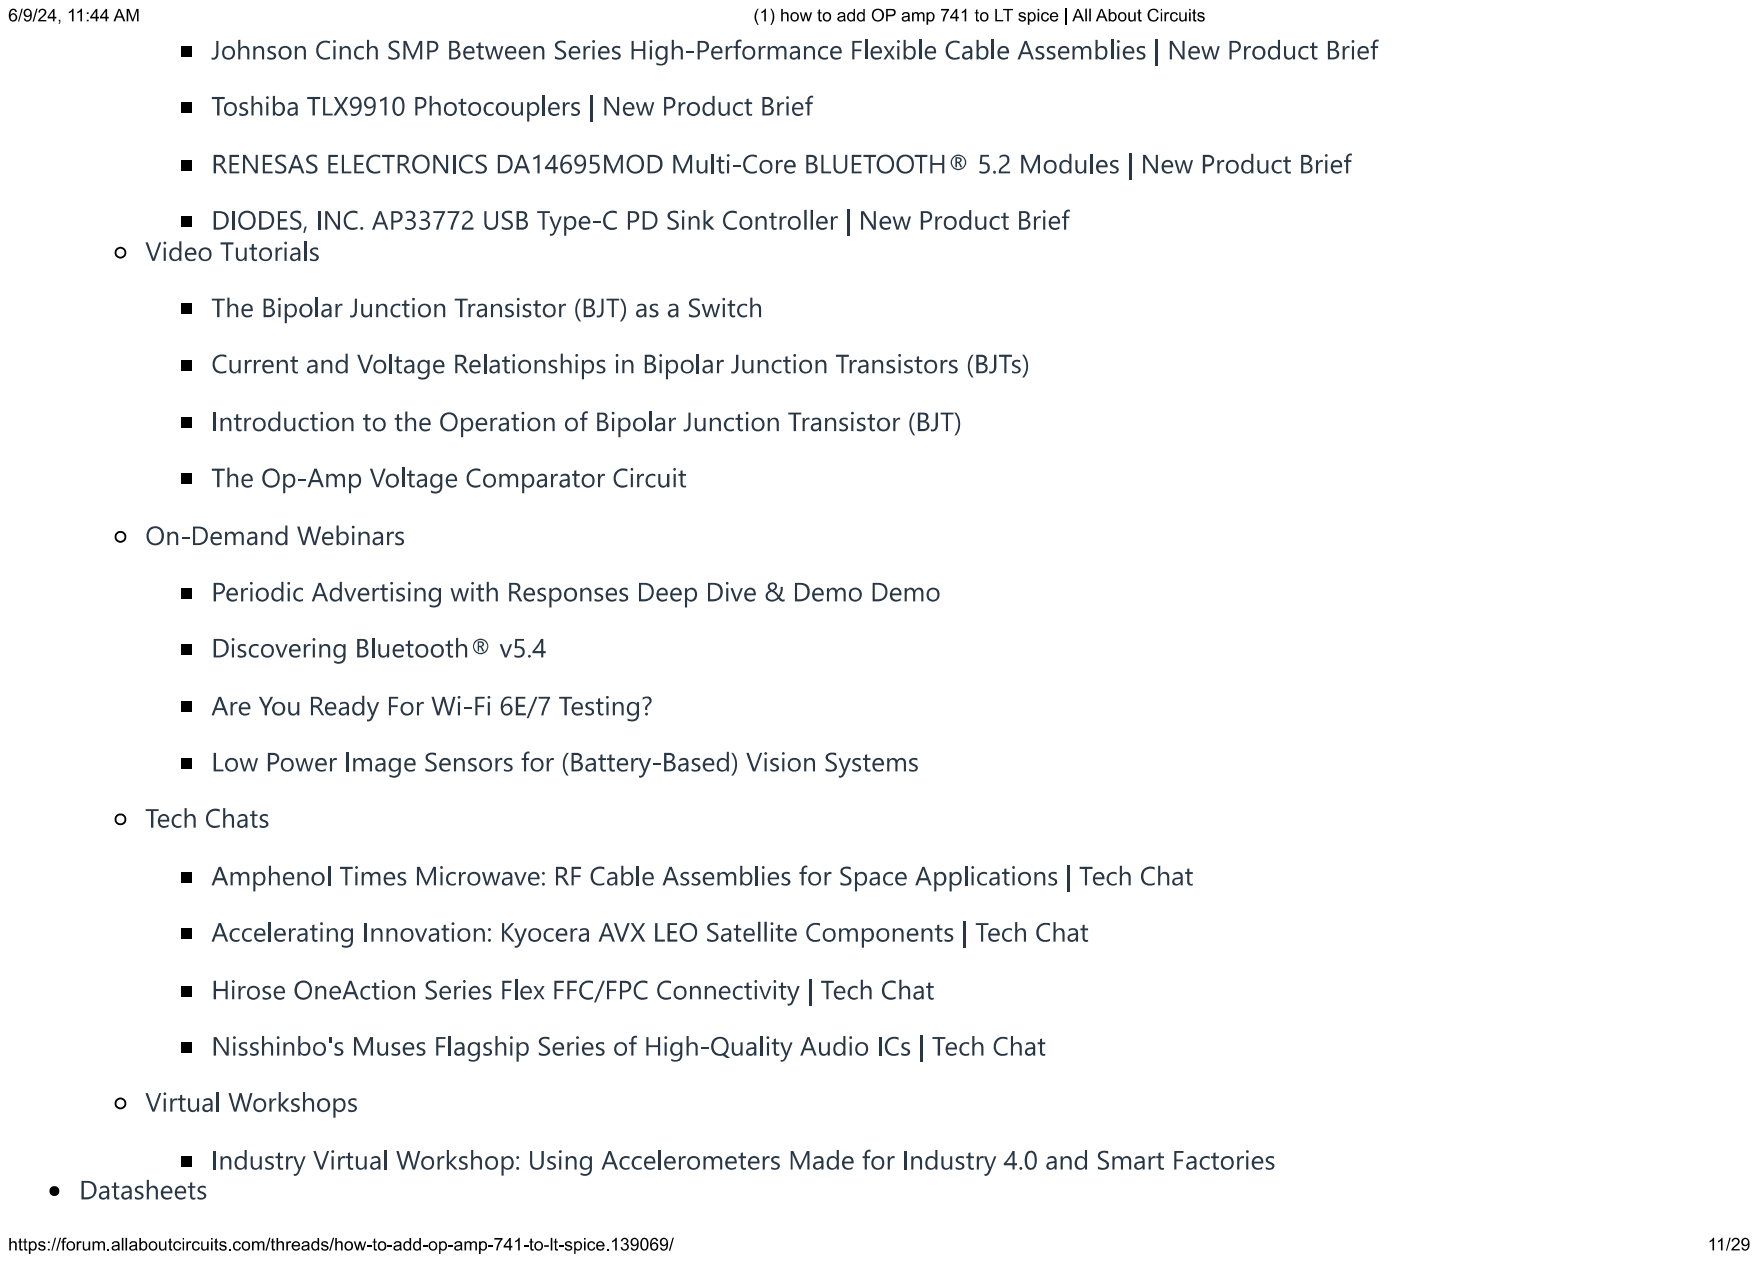
[picture p138: page 11]

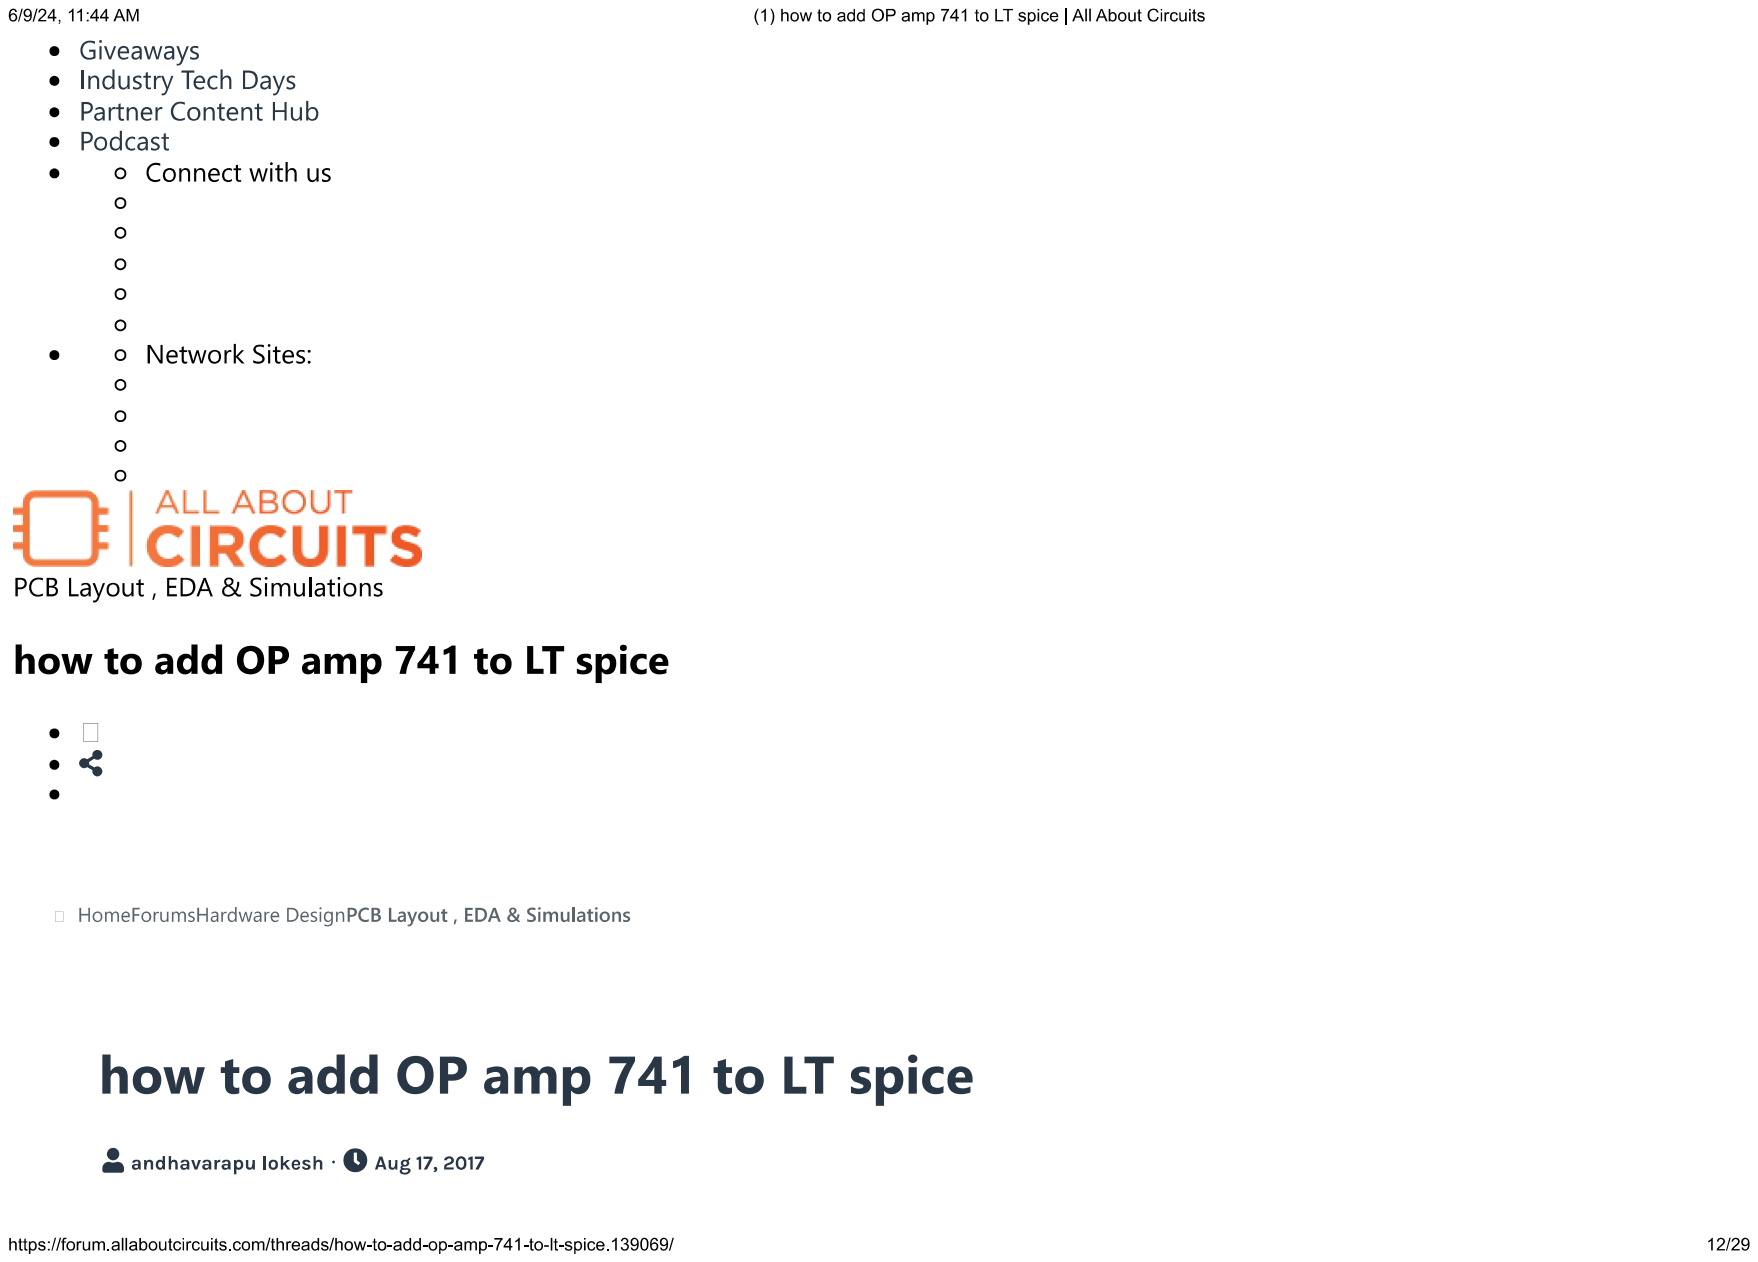
[picture p139: page 12]

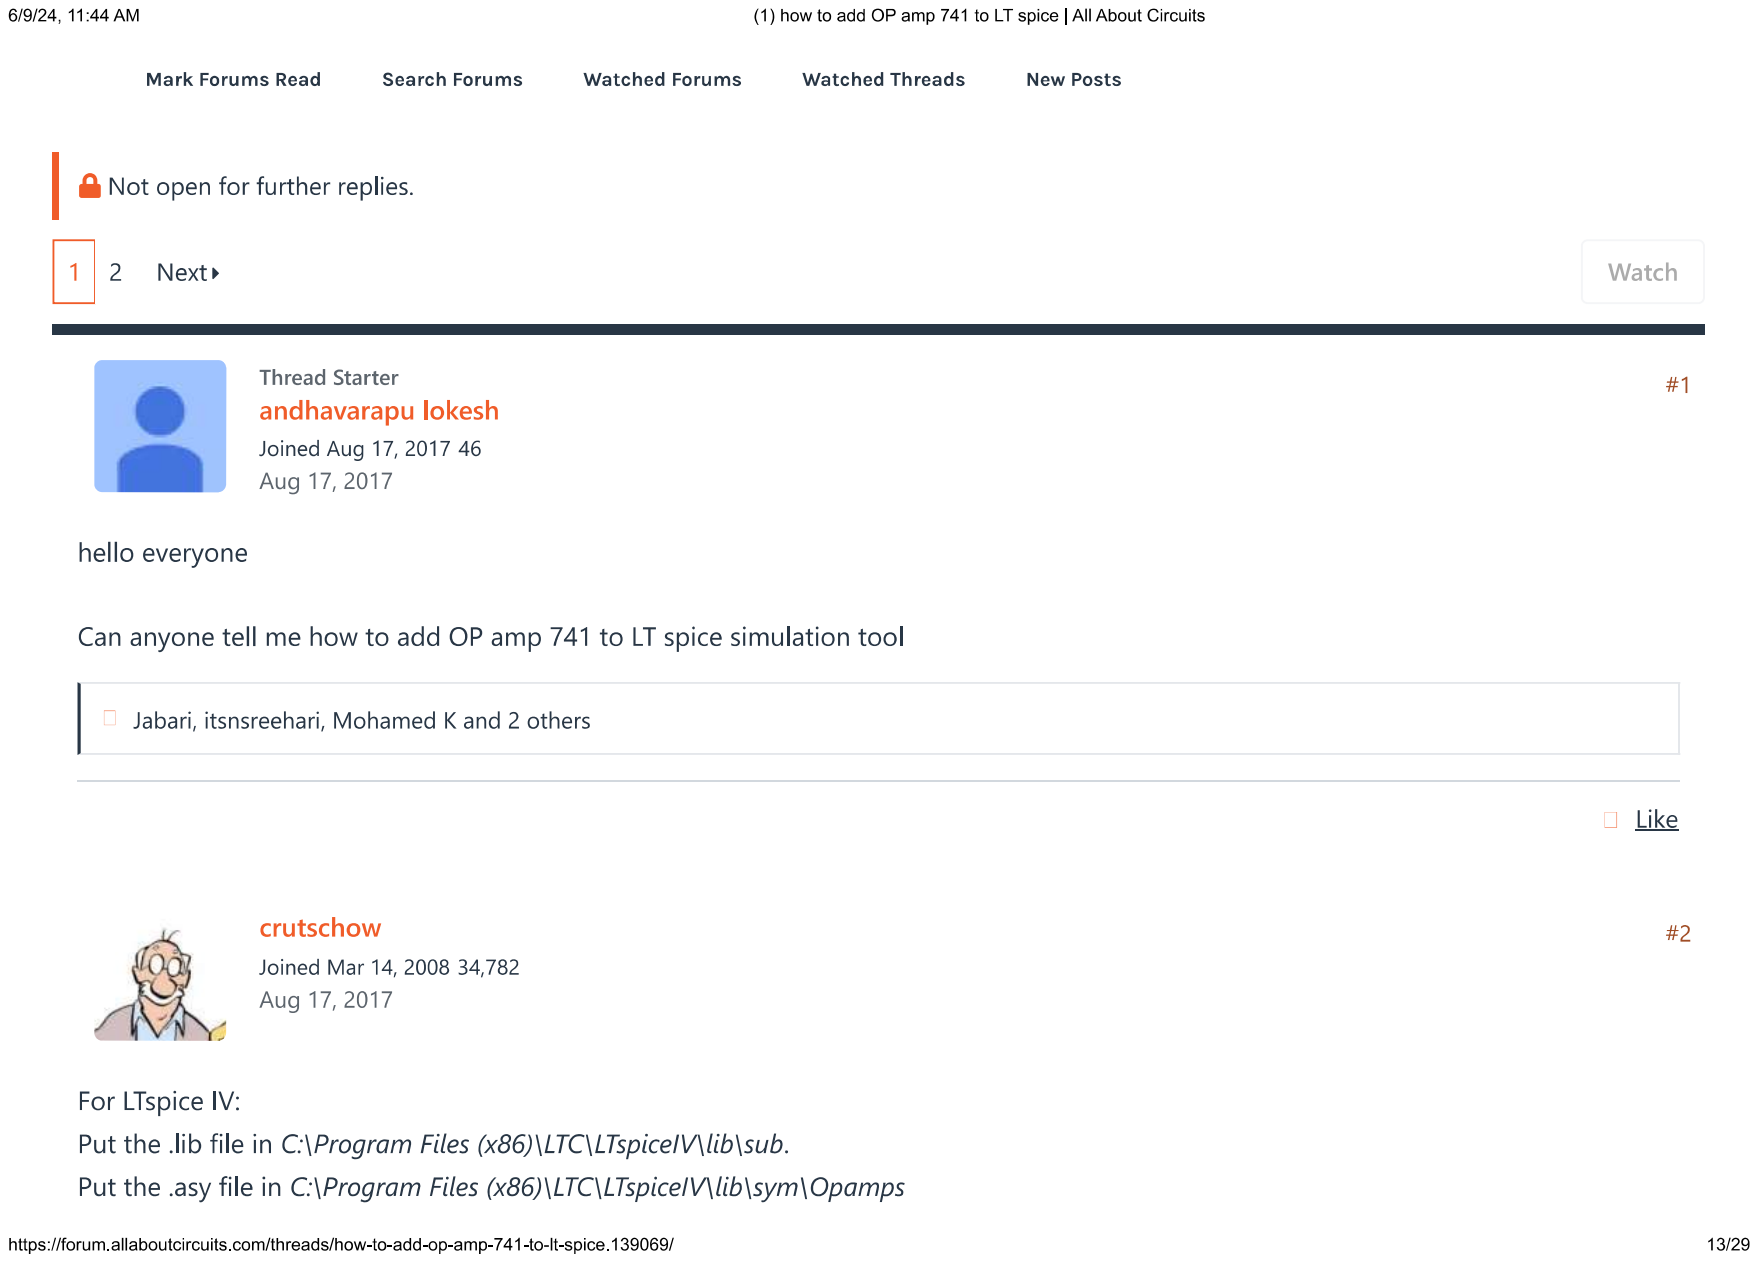
[picture p140: page 13]

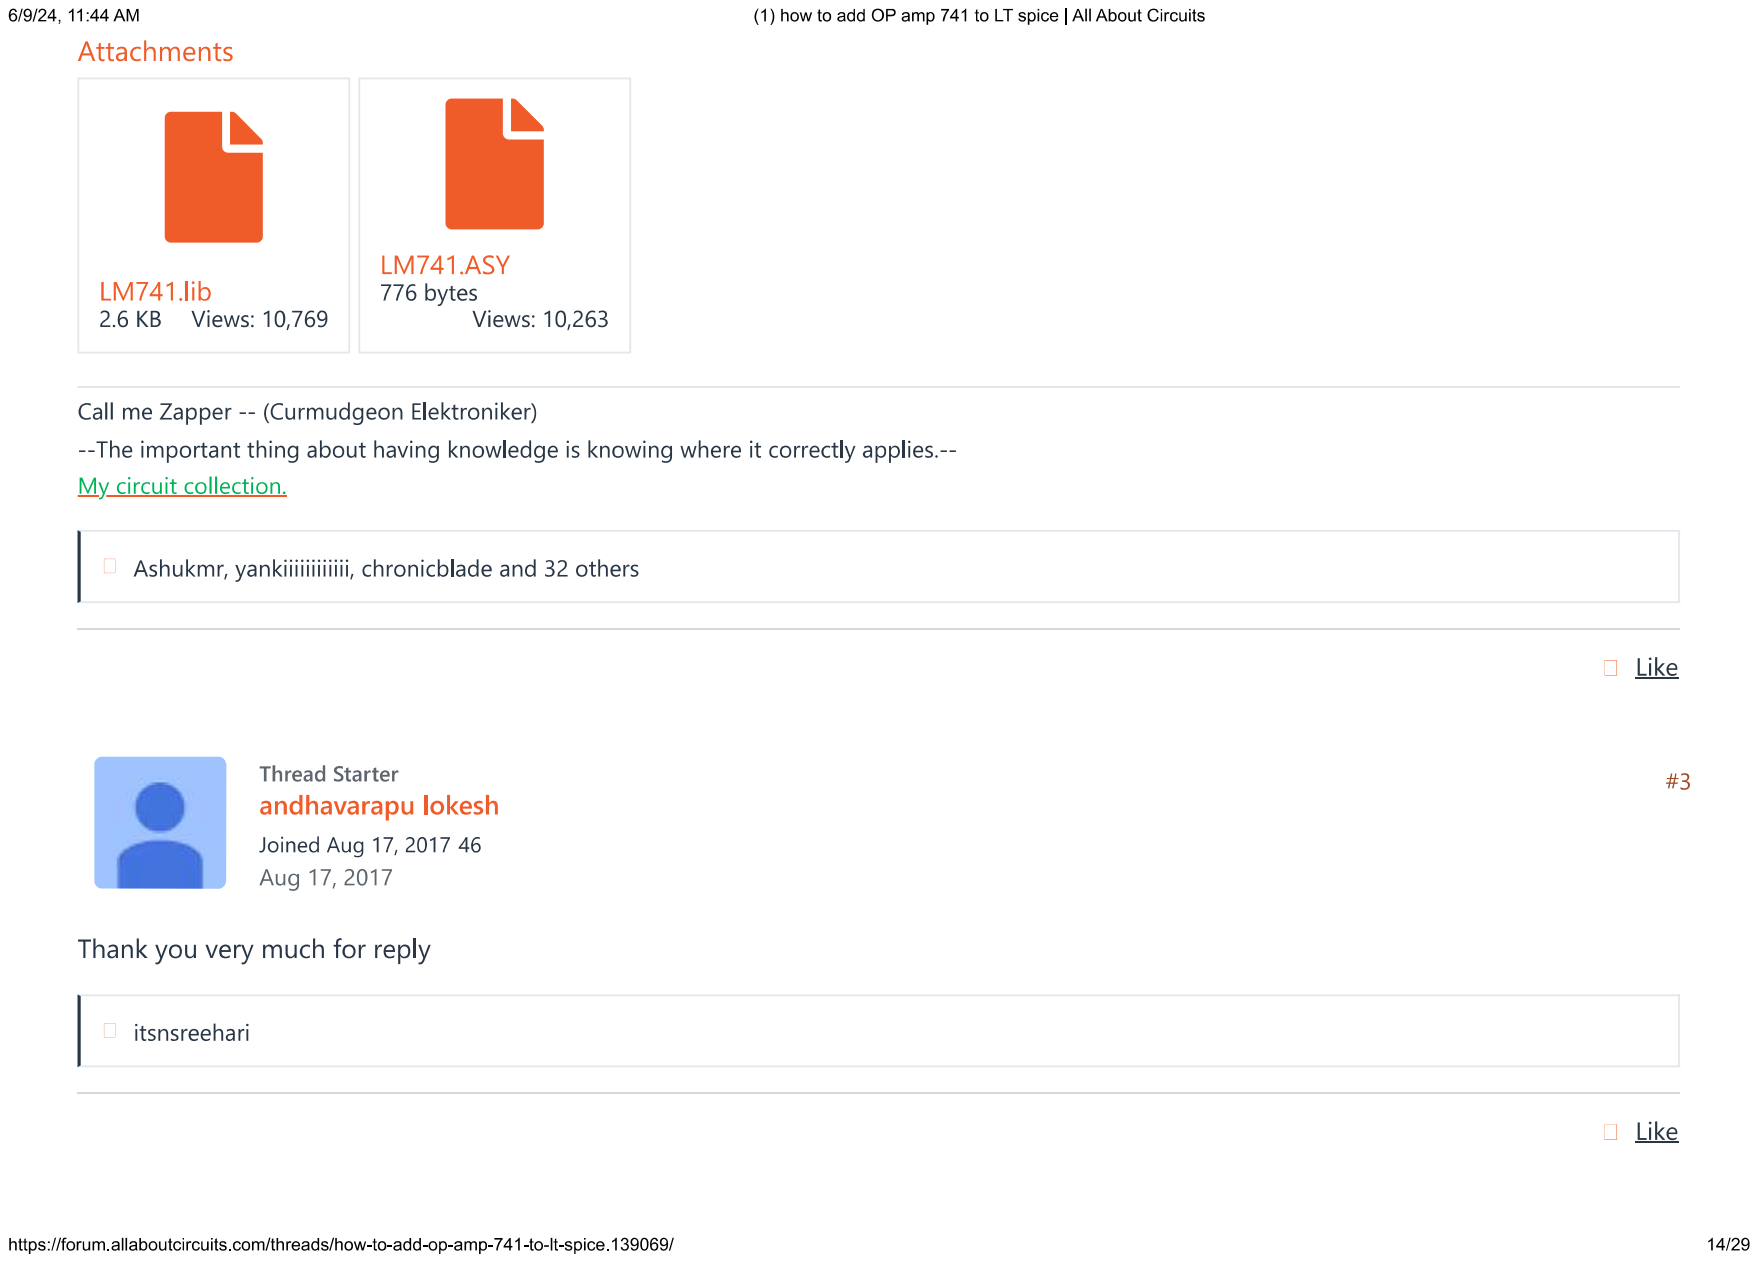
[picture p141: page 14]

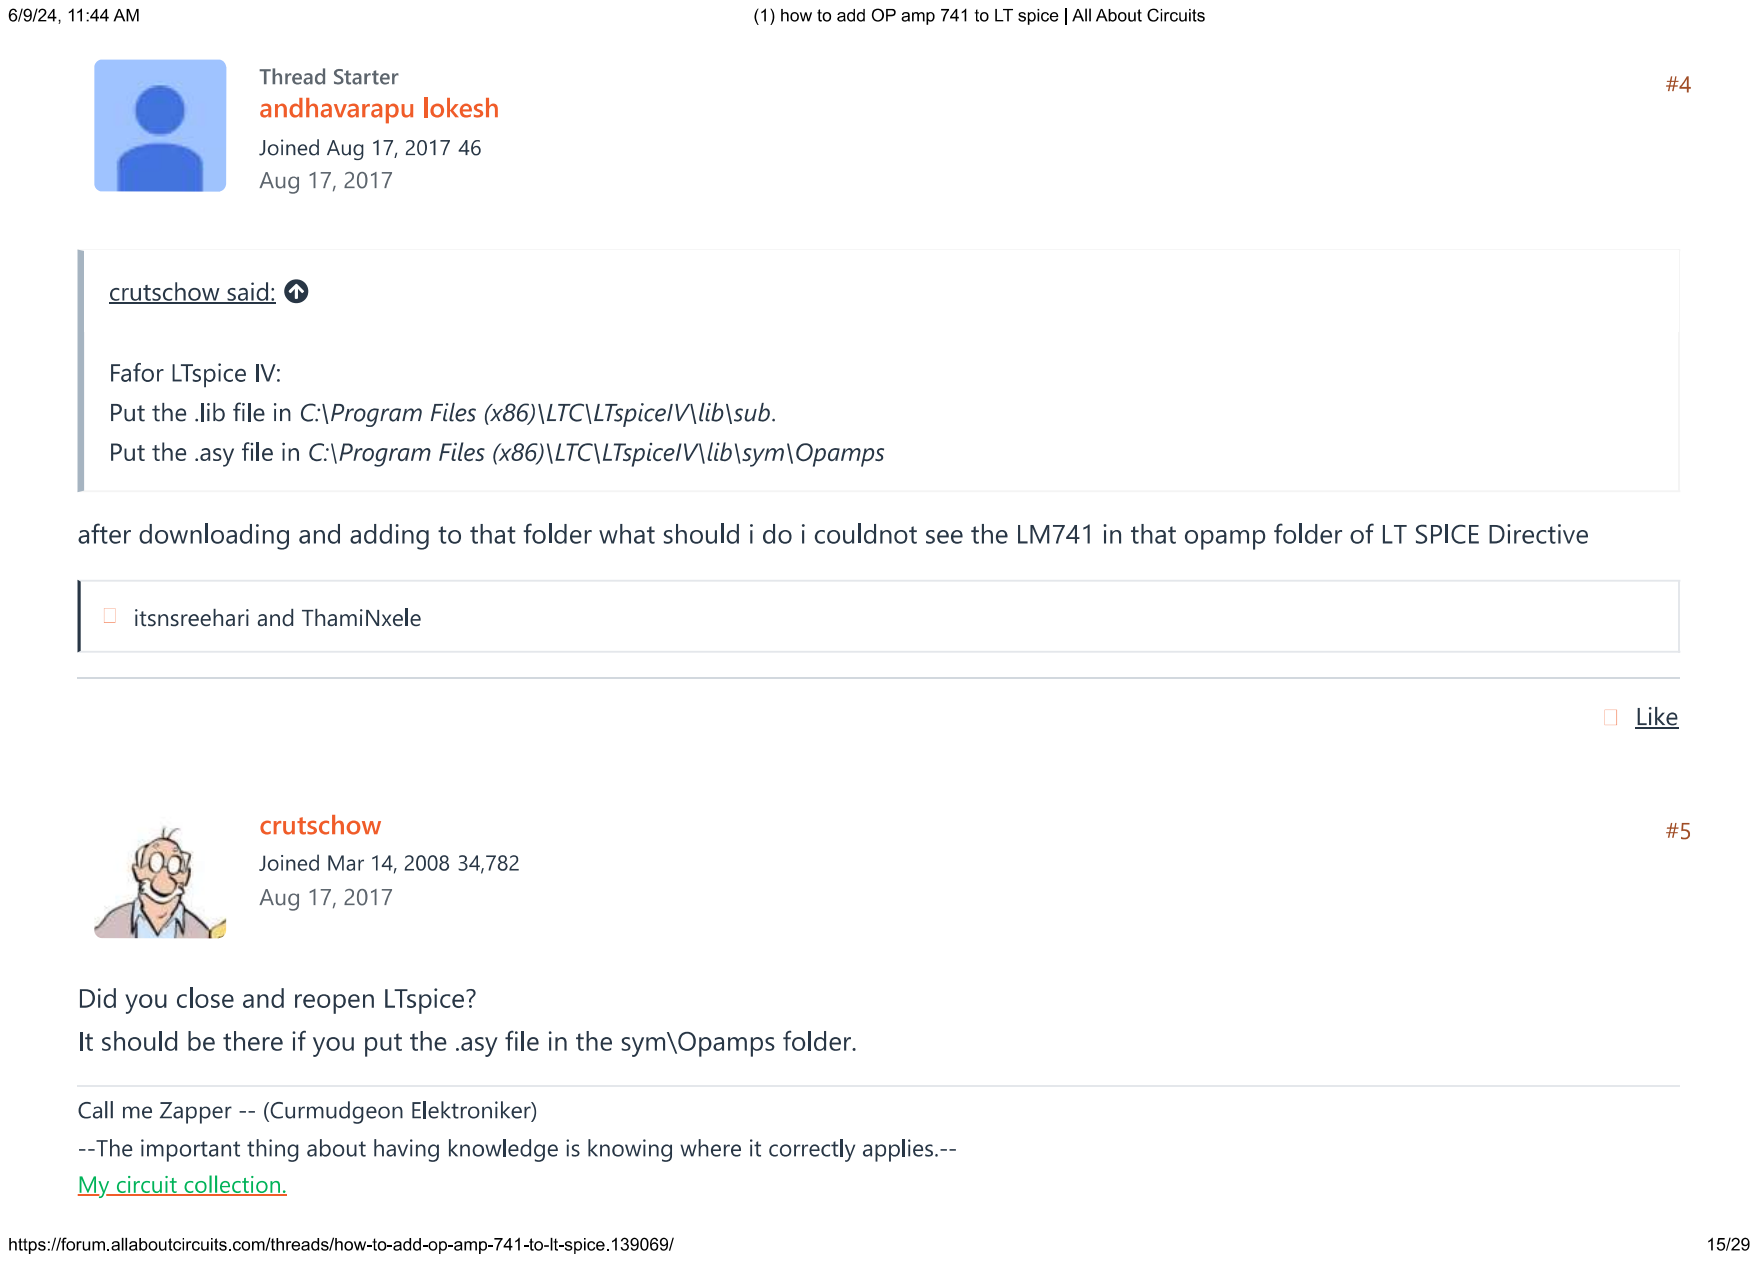
[picture p142: page 15]

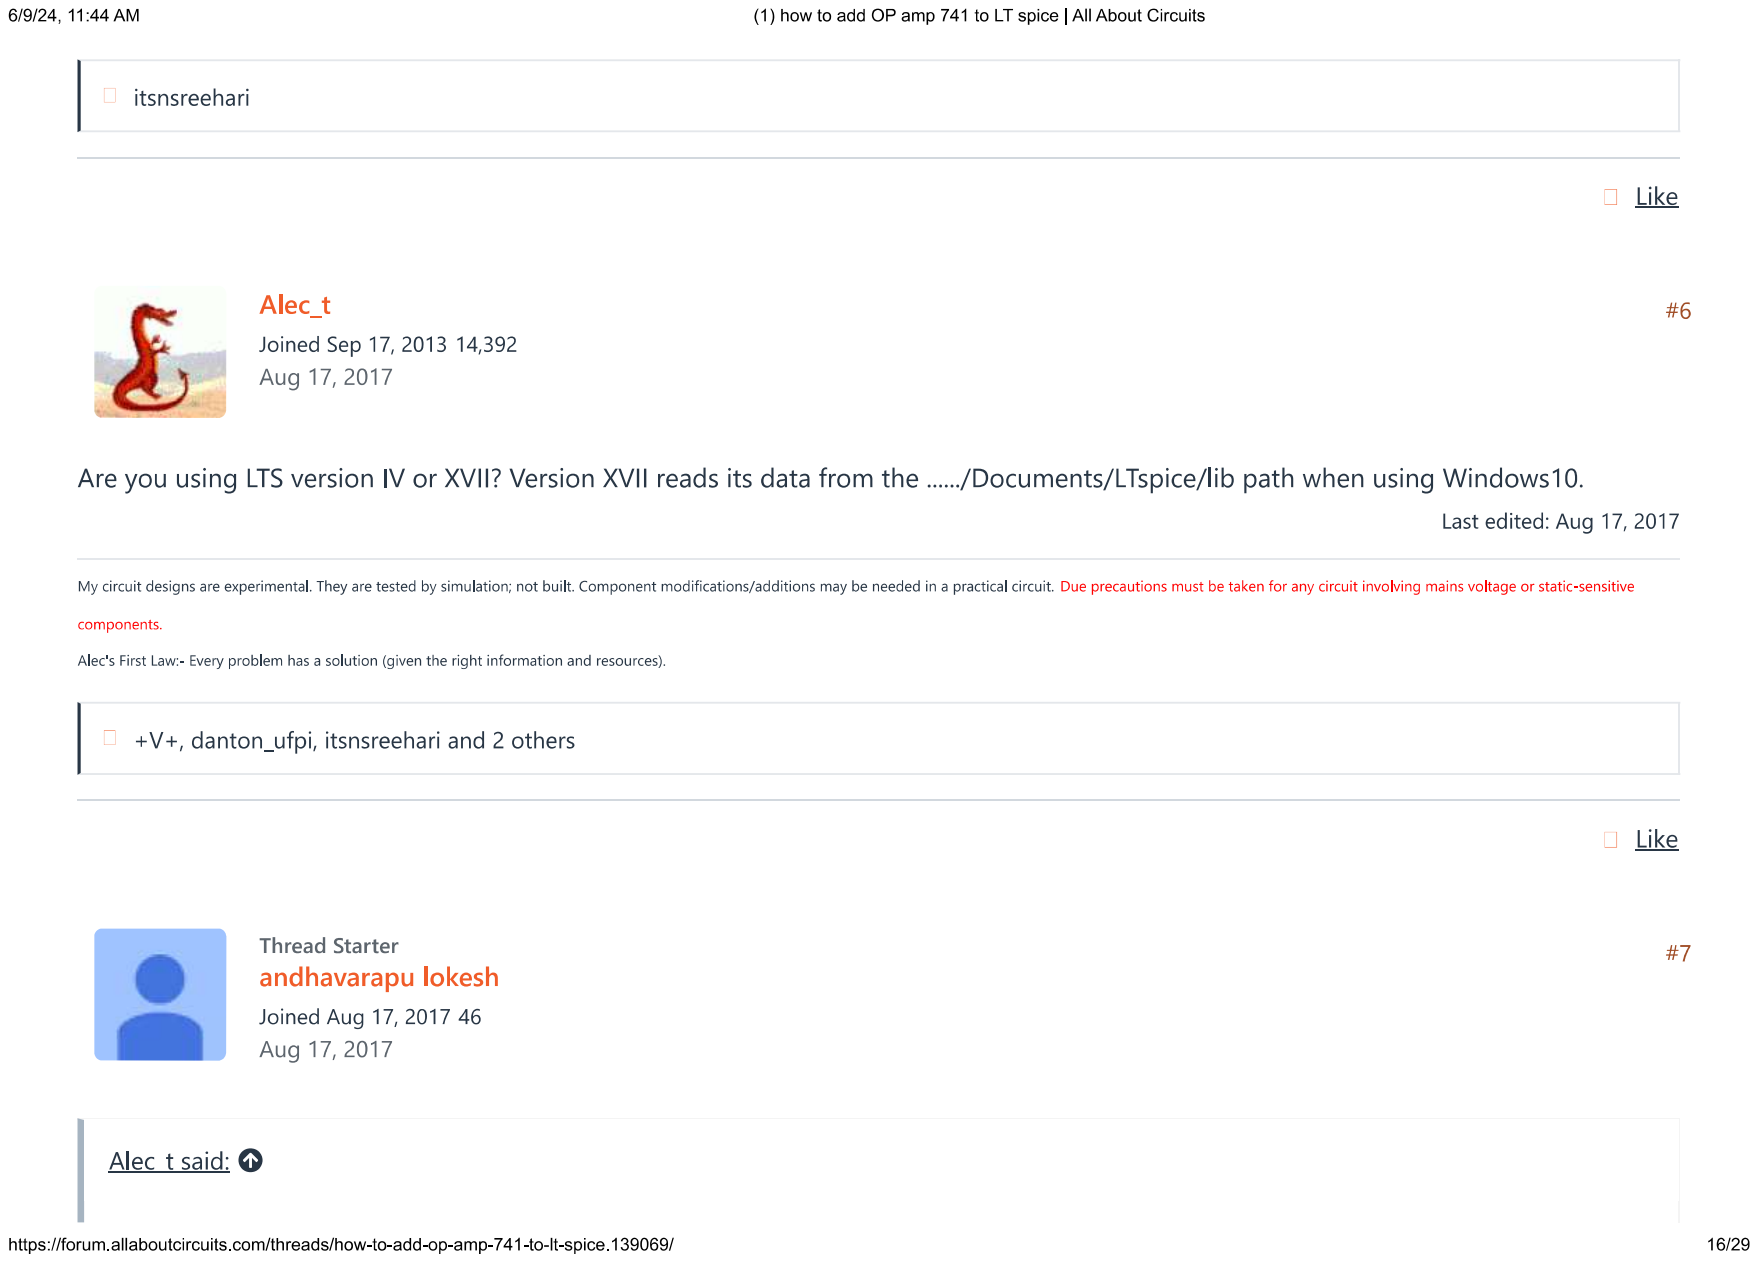
[picture p143: page 16]

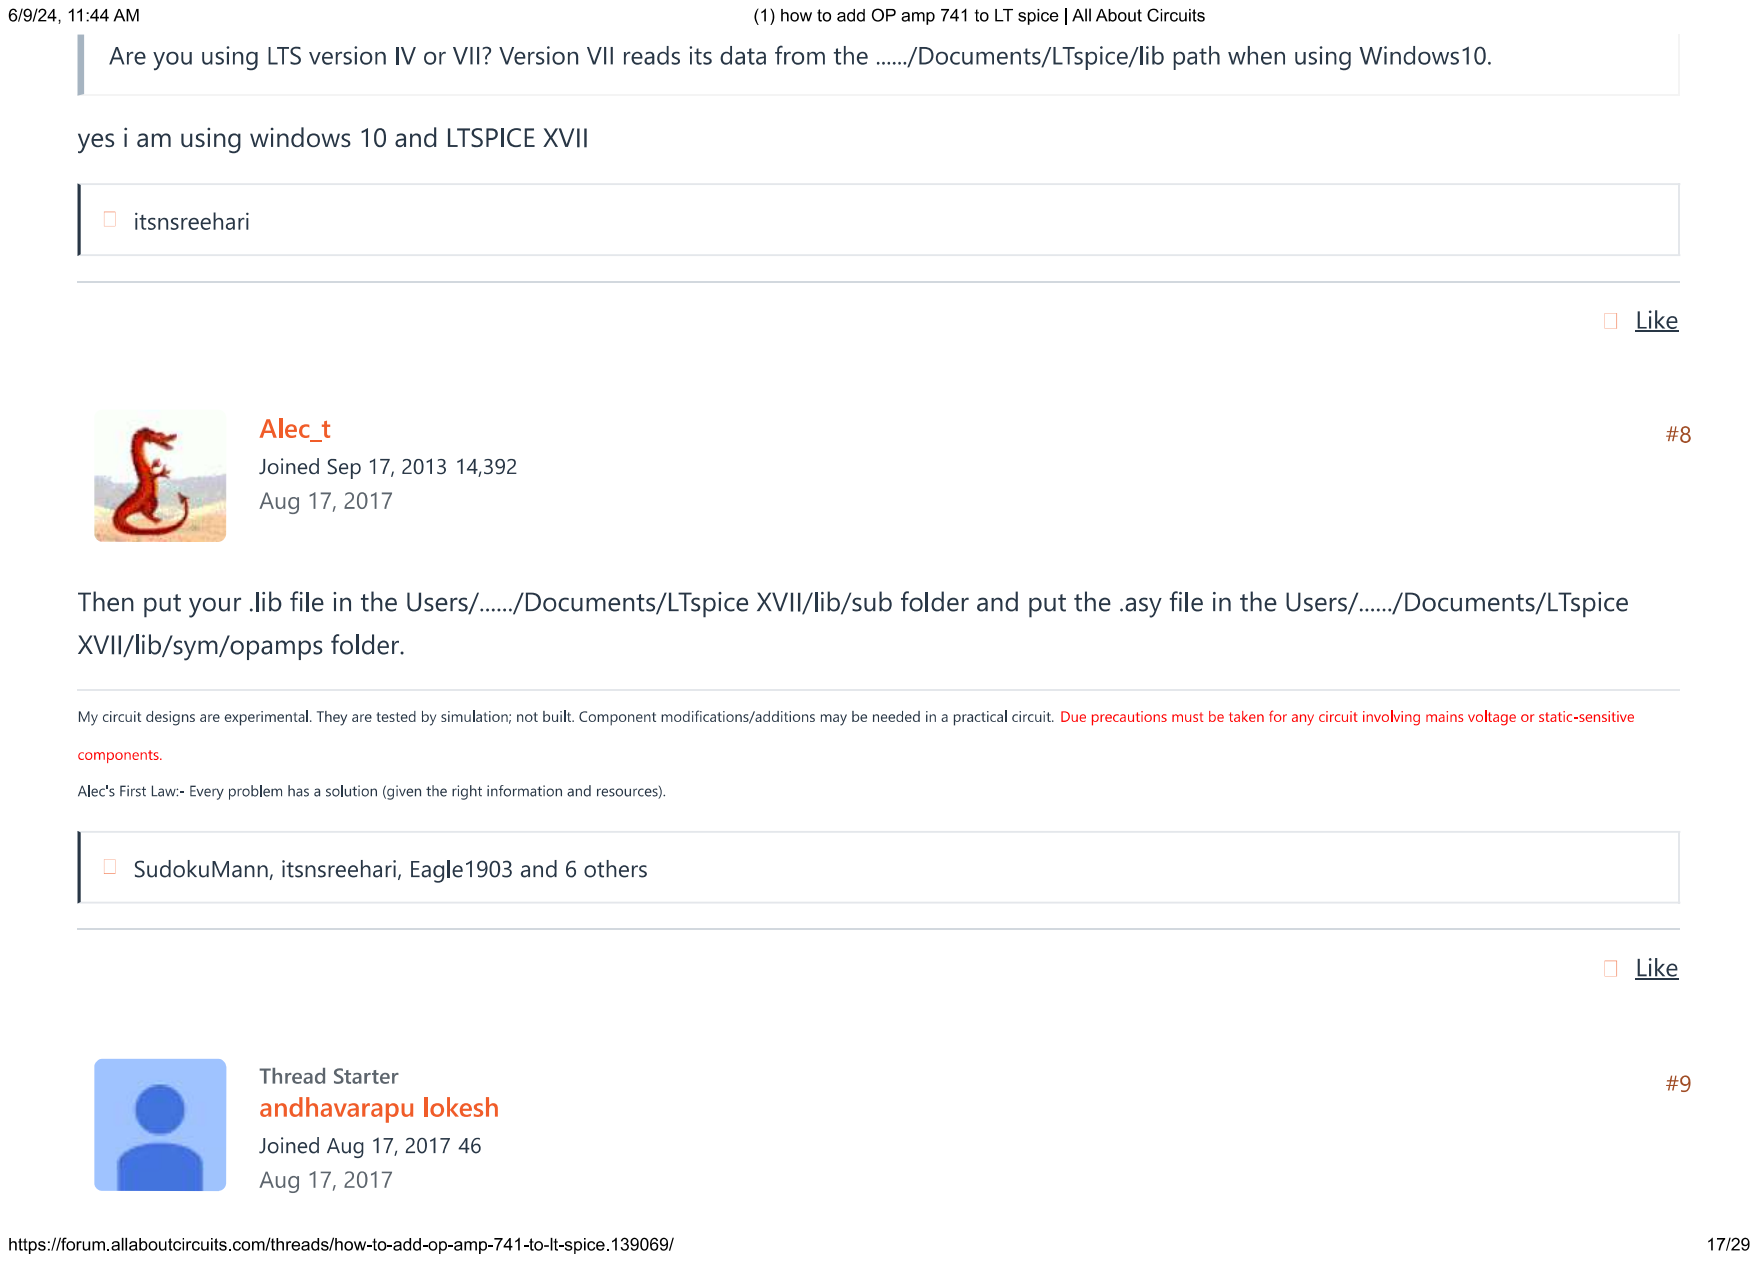
[picture p144: page 17]

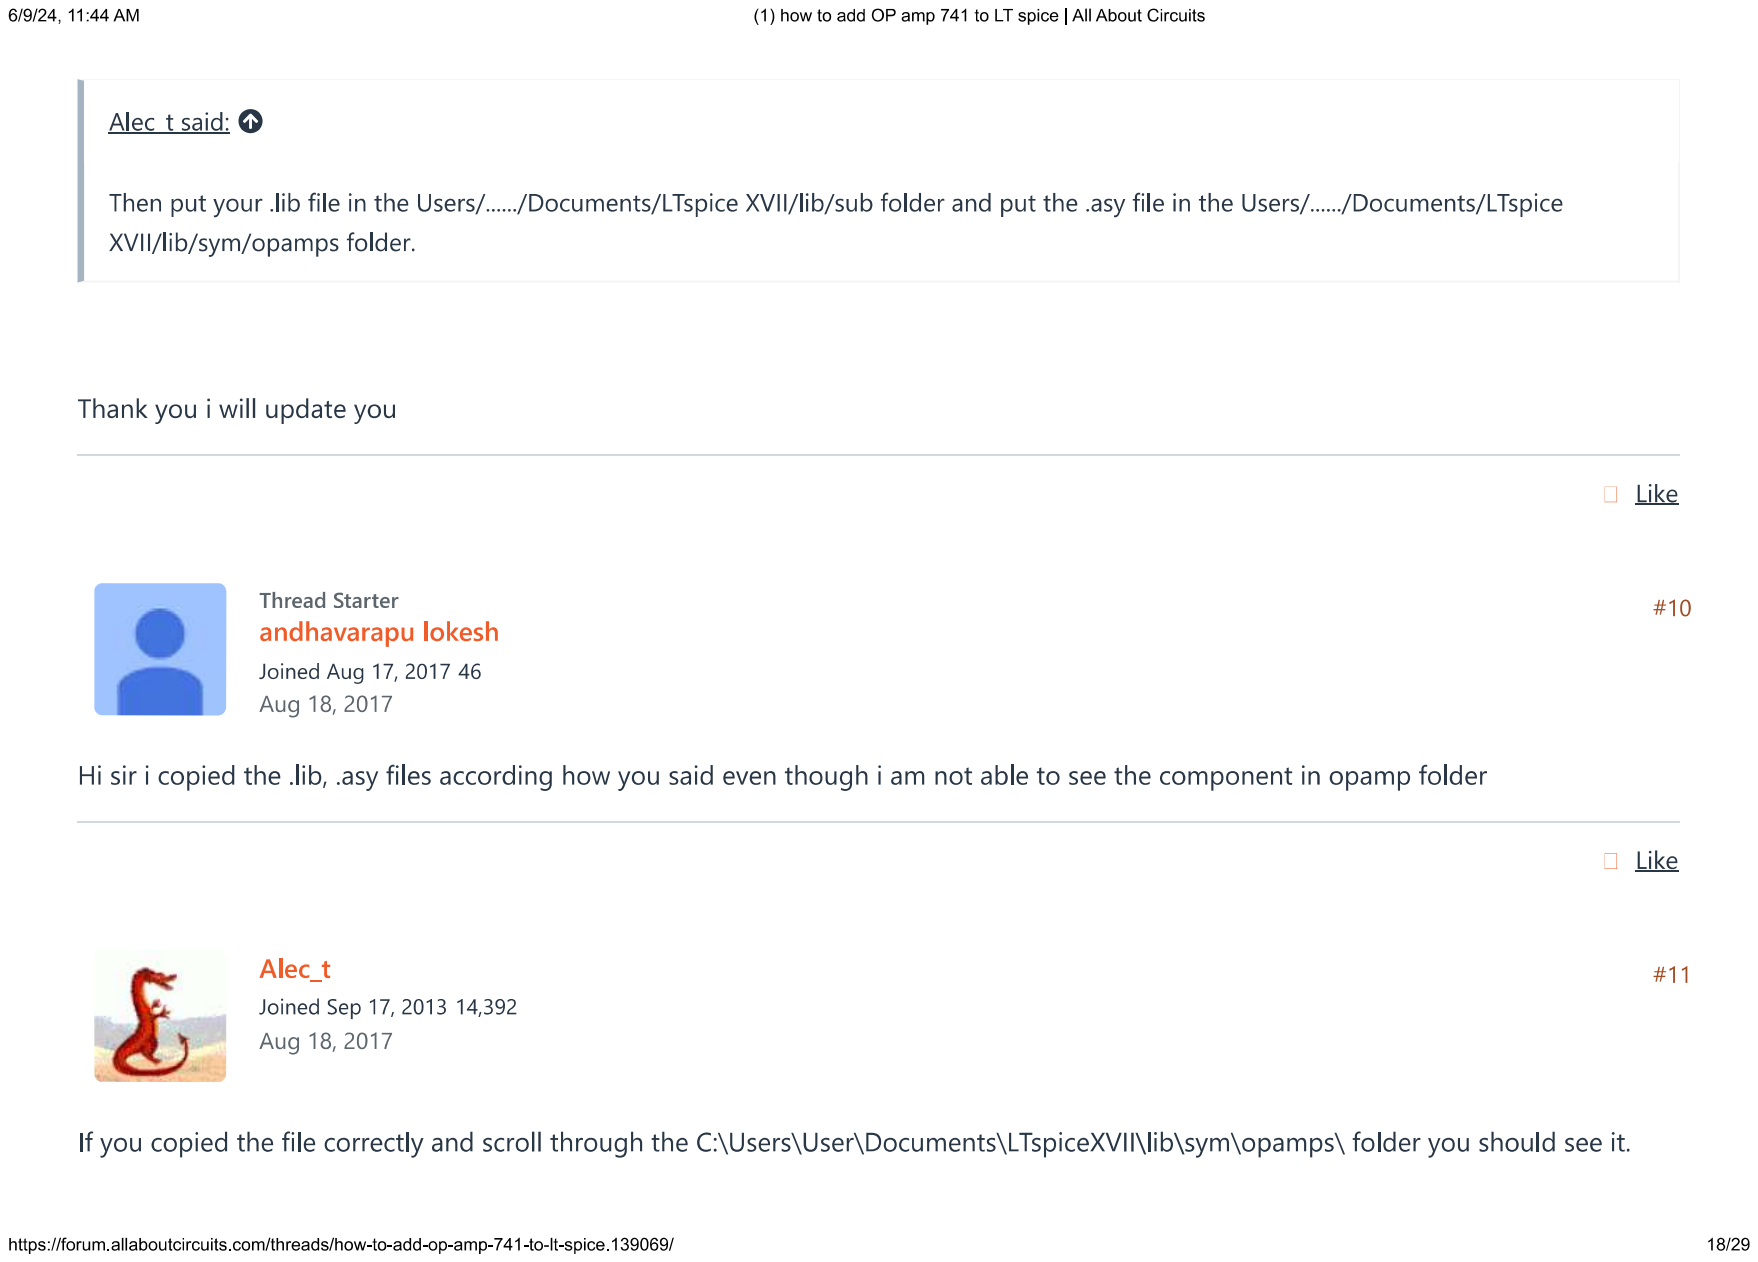
[picture p145: page 18]

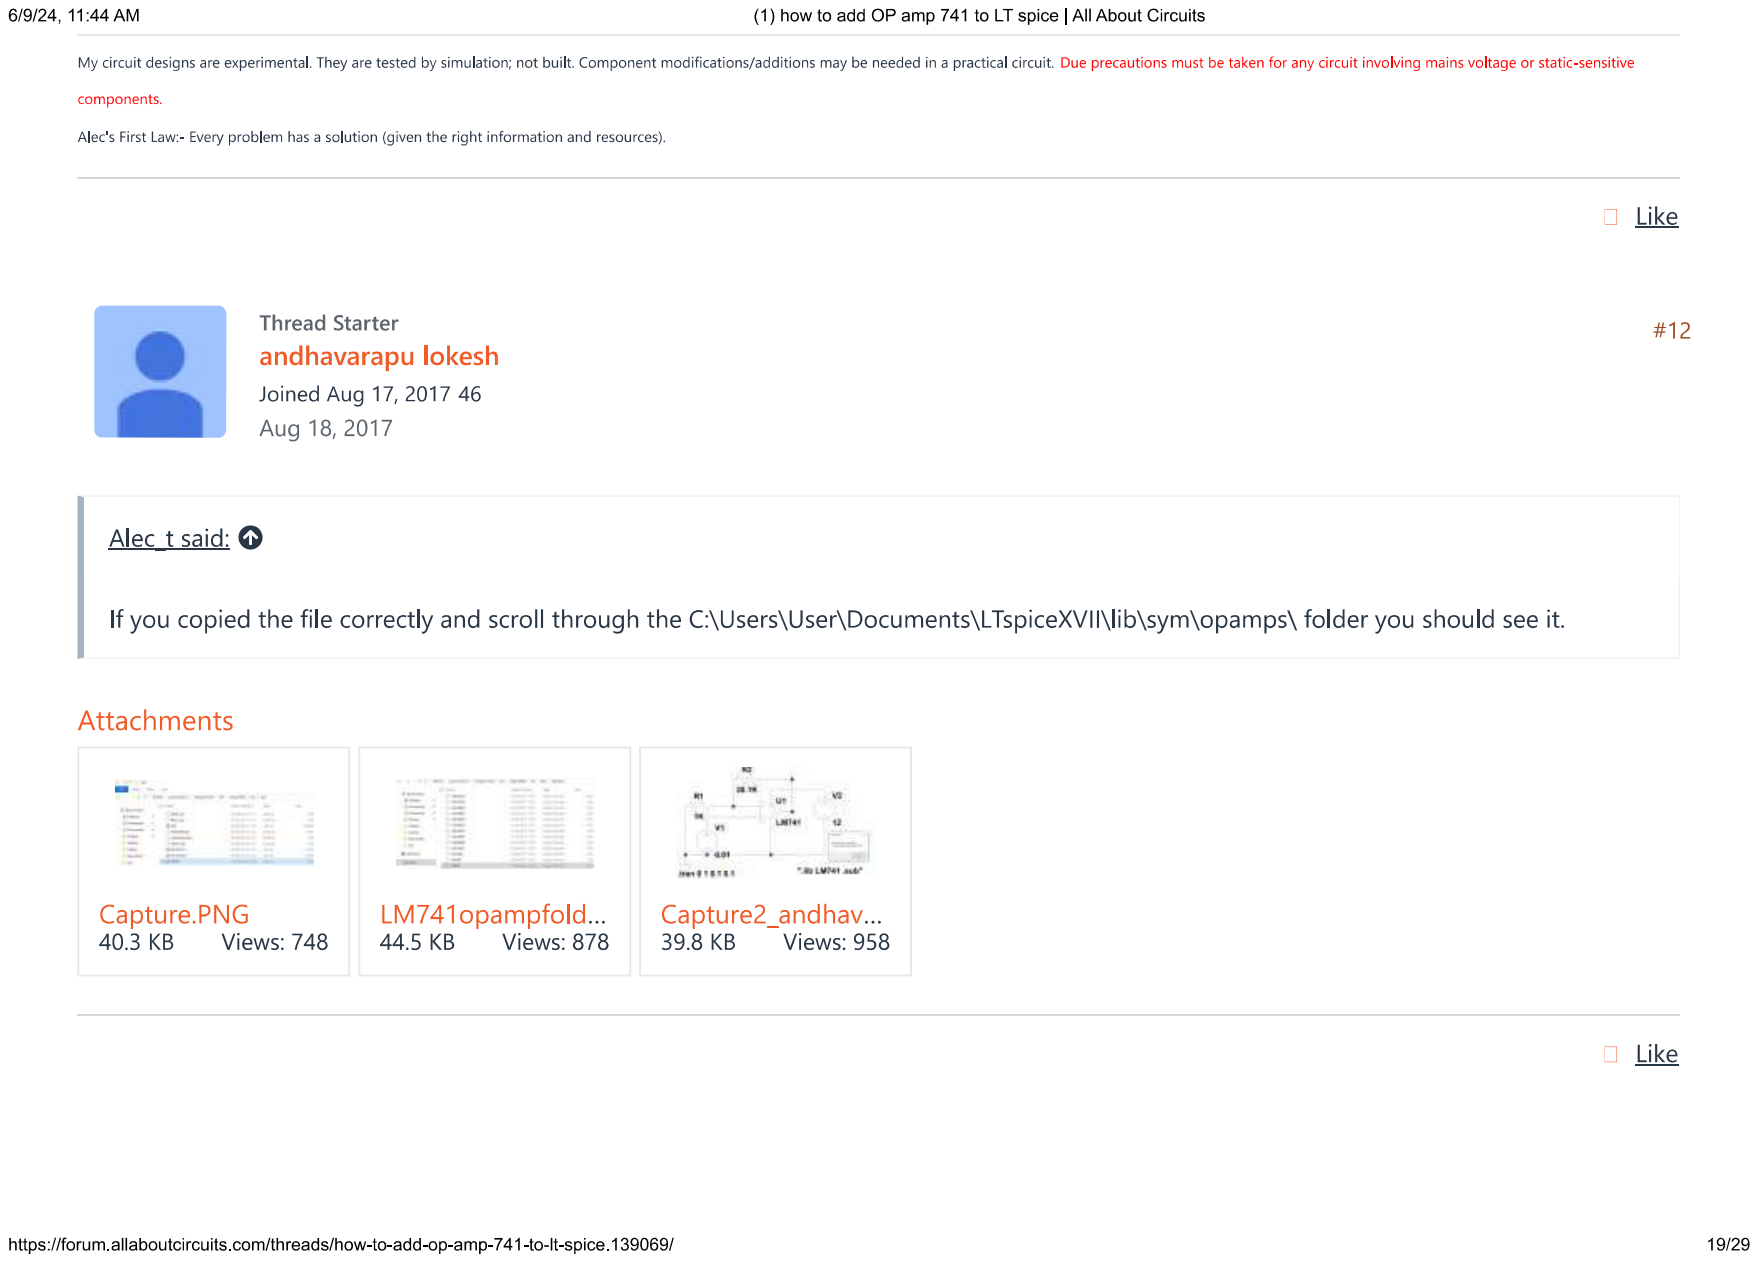
[picture p146: page 19]

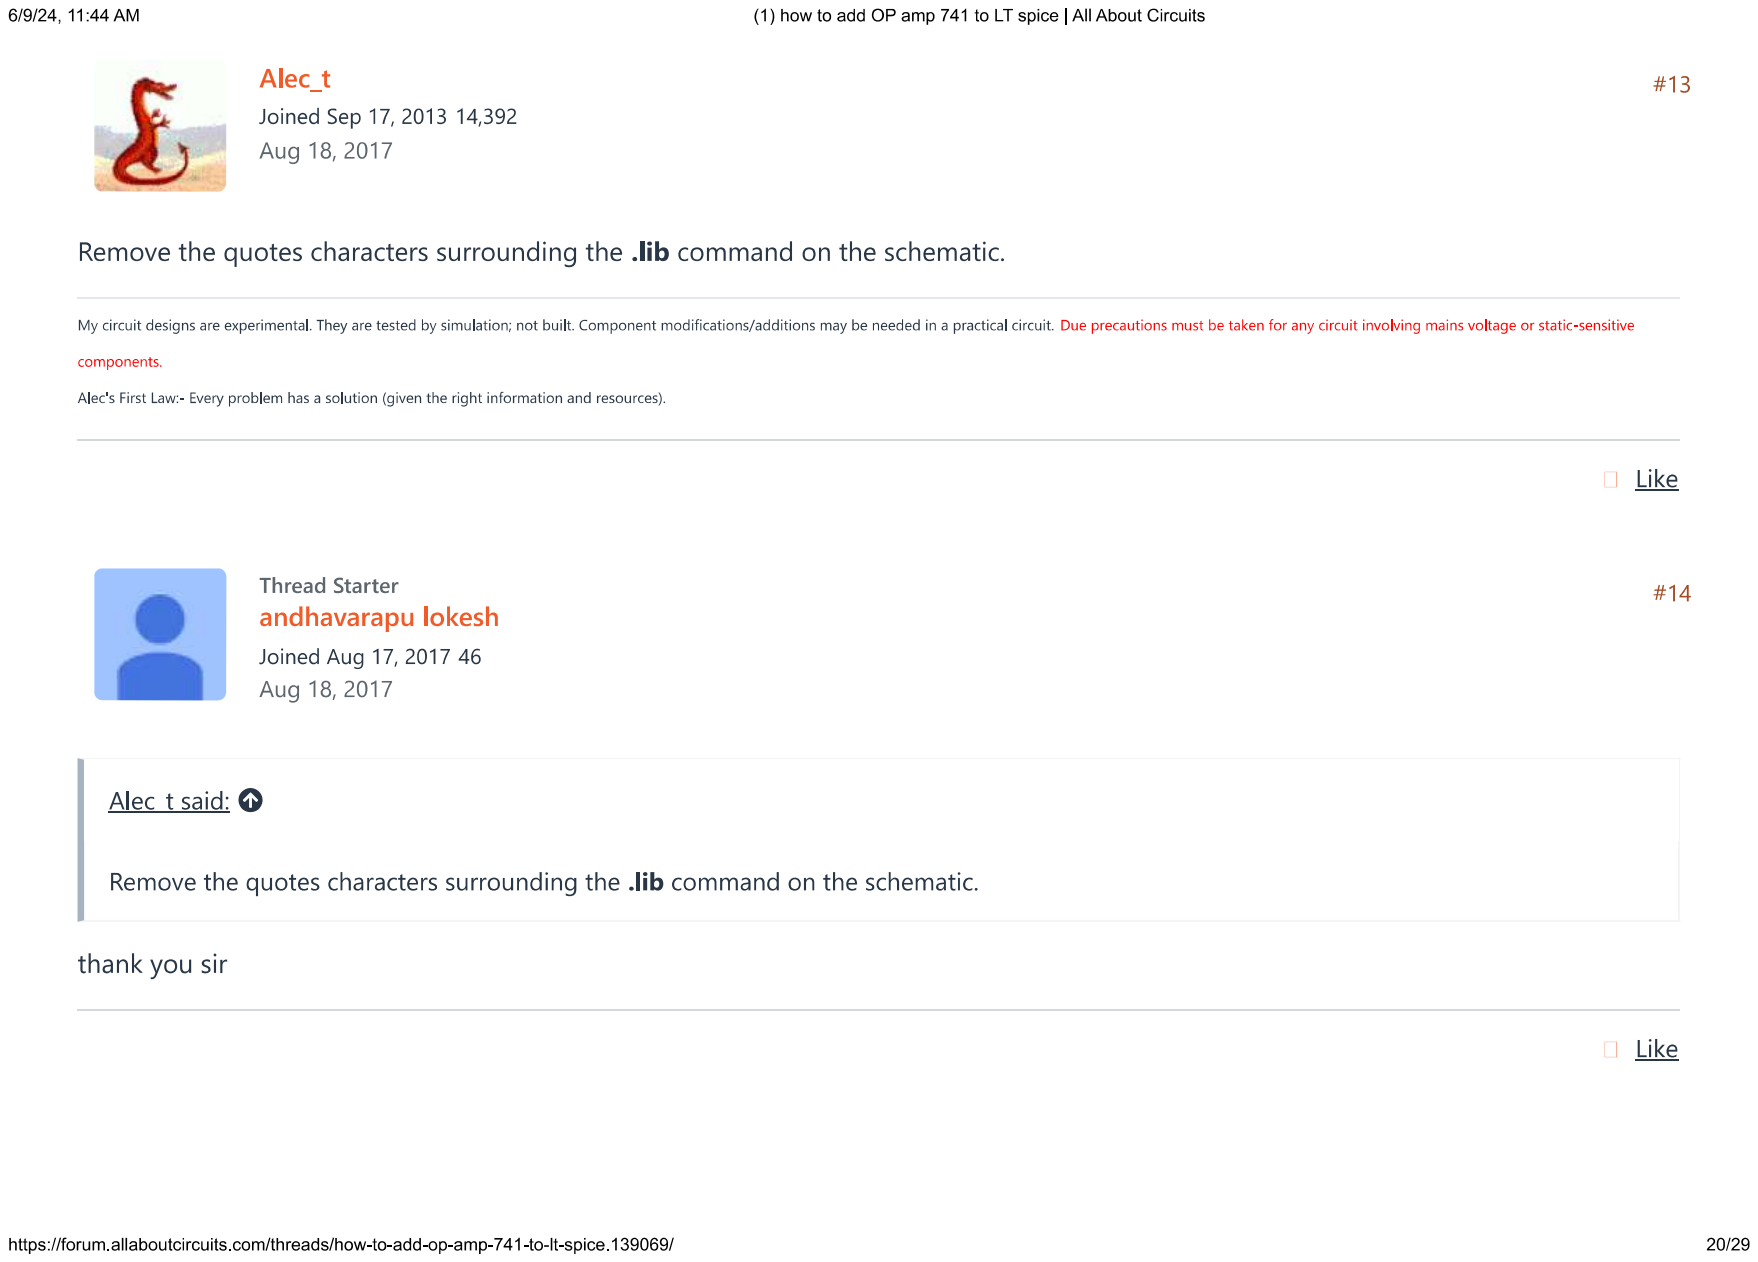
[picture p147: page 20]

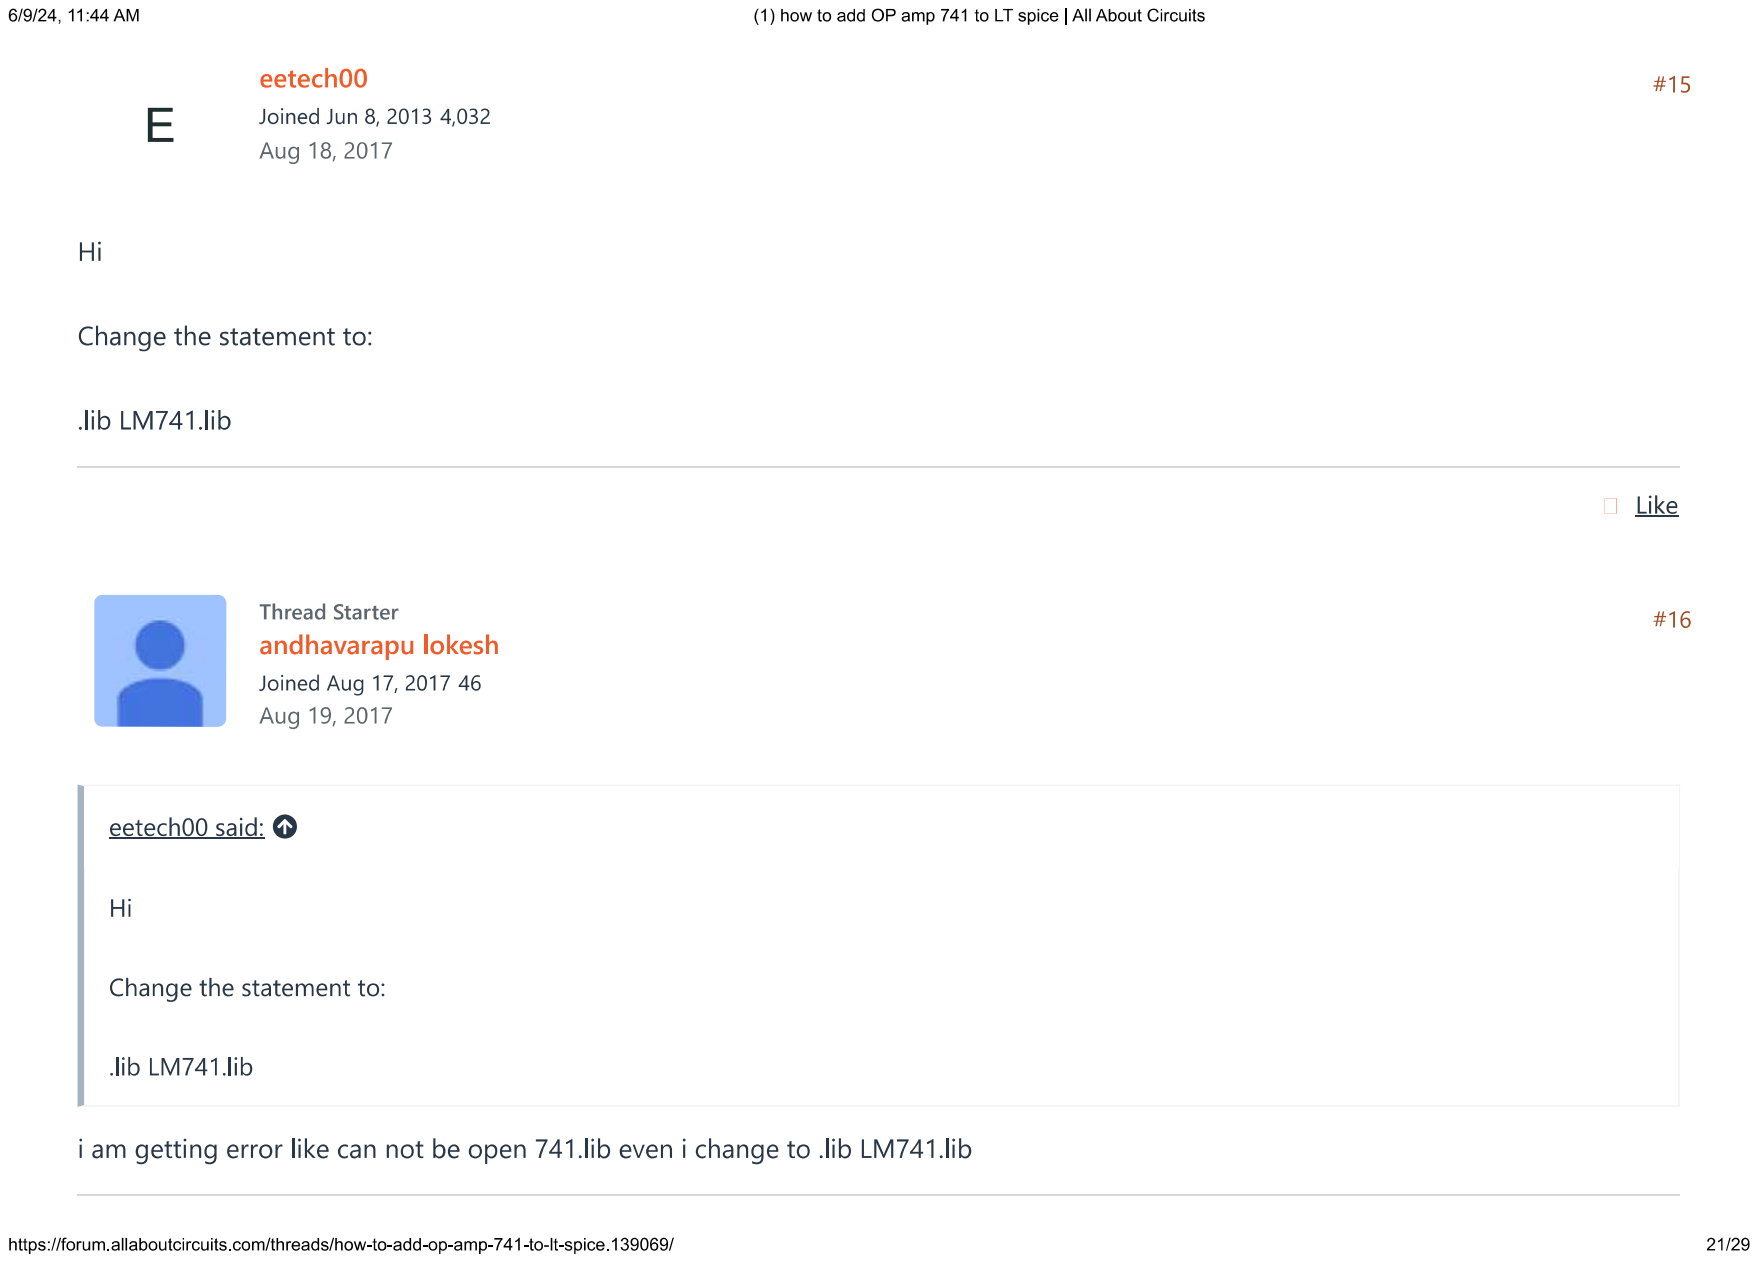
[picture p148: page 21]

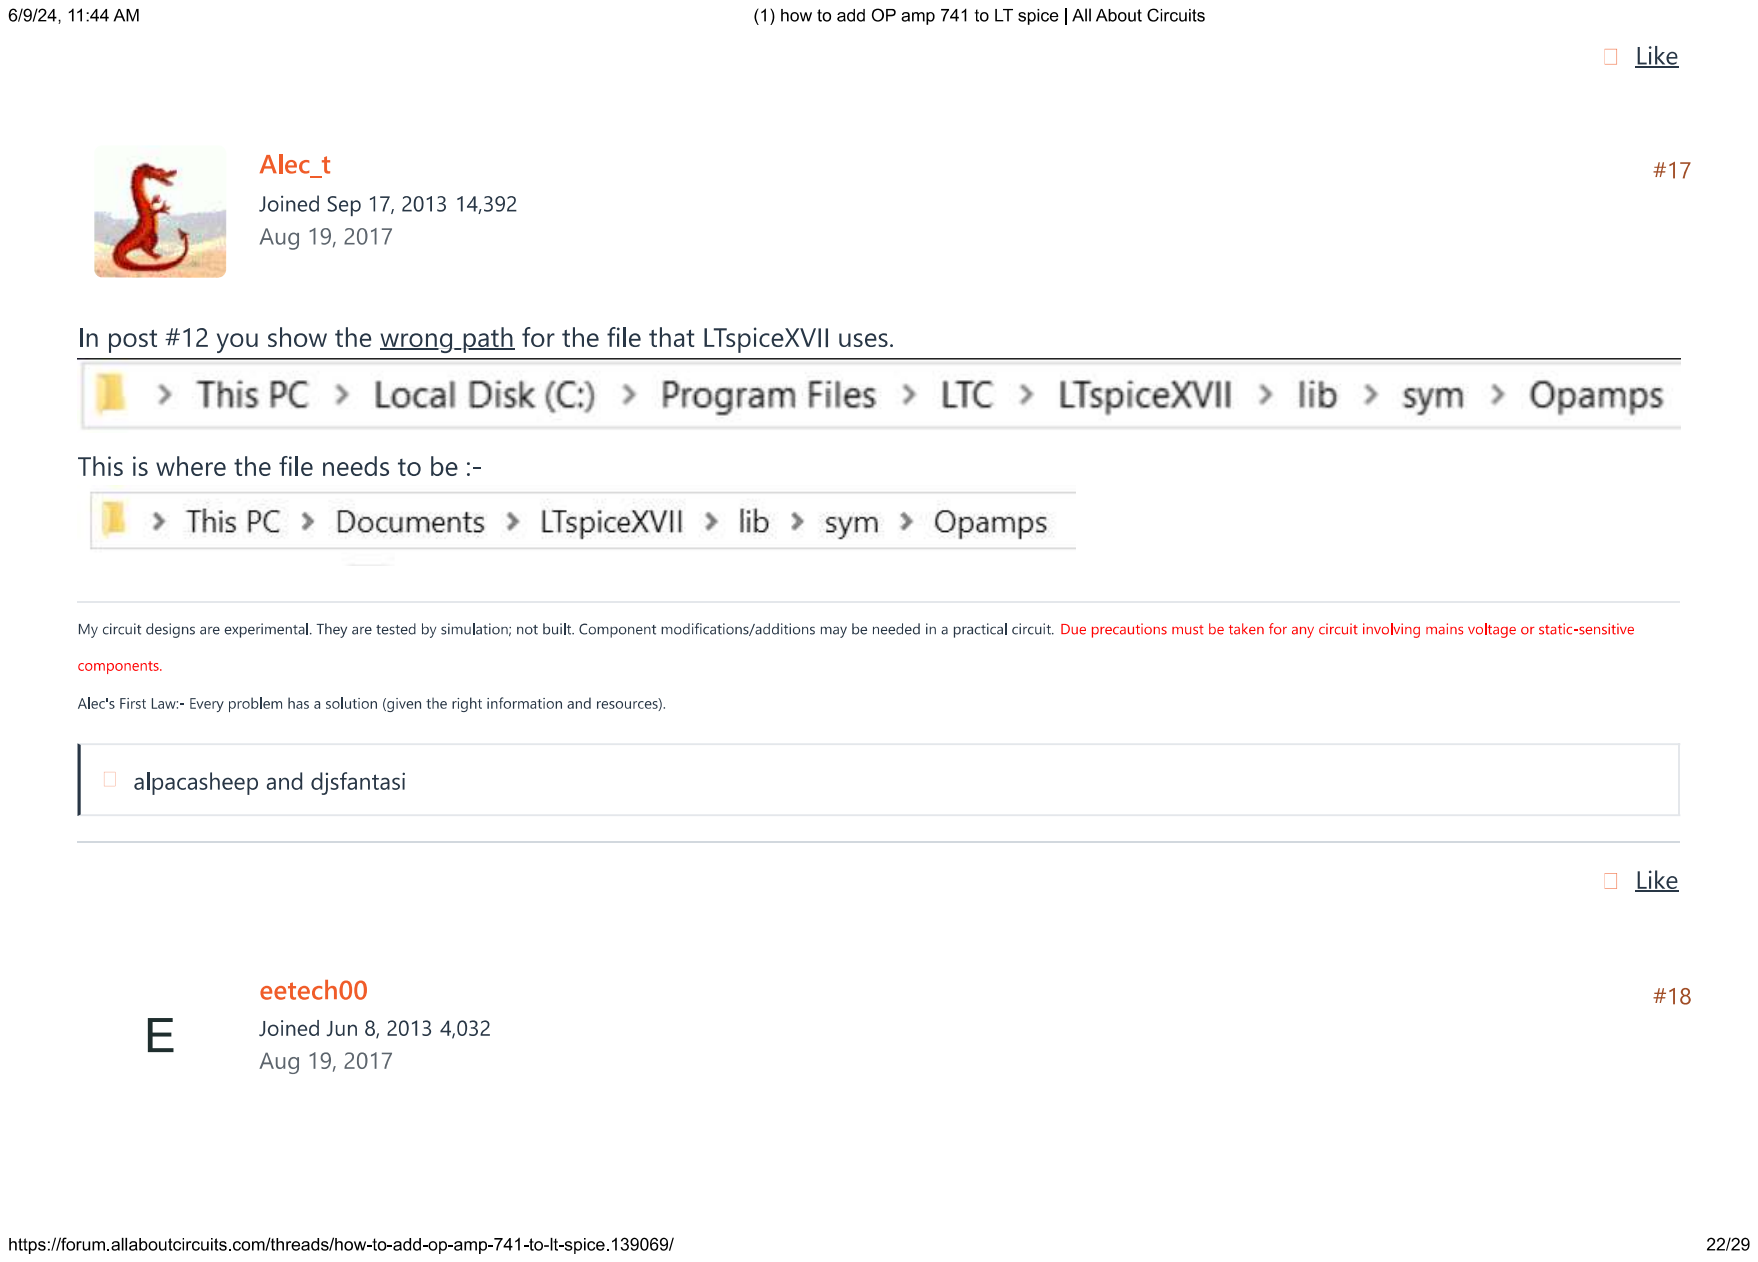
[picture p149: page 22]

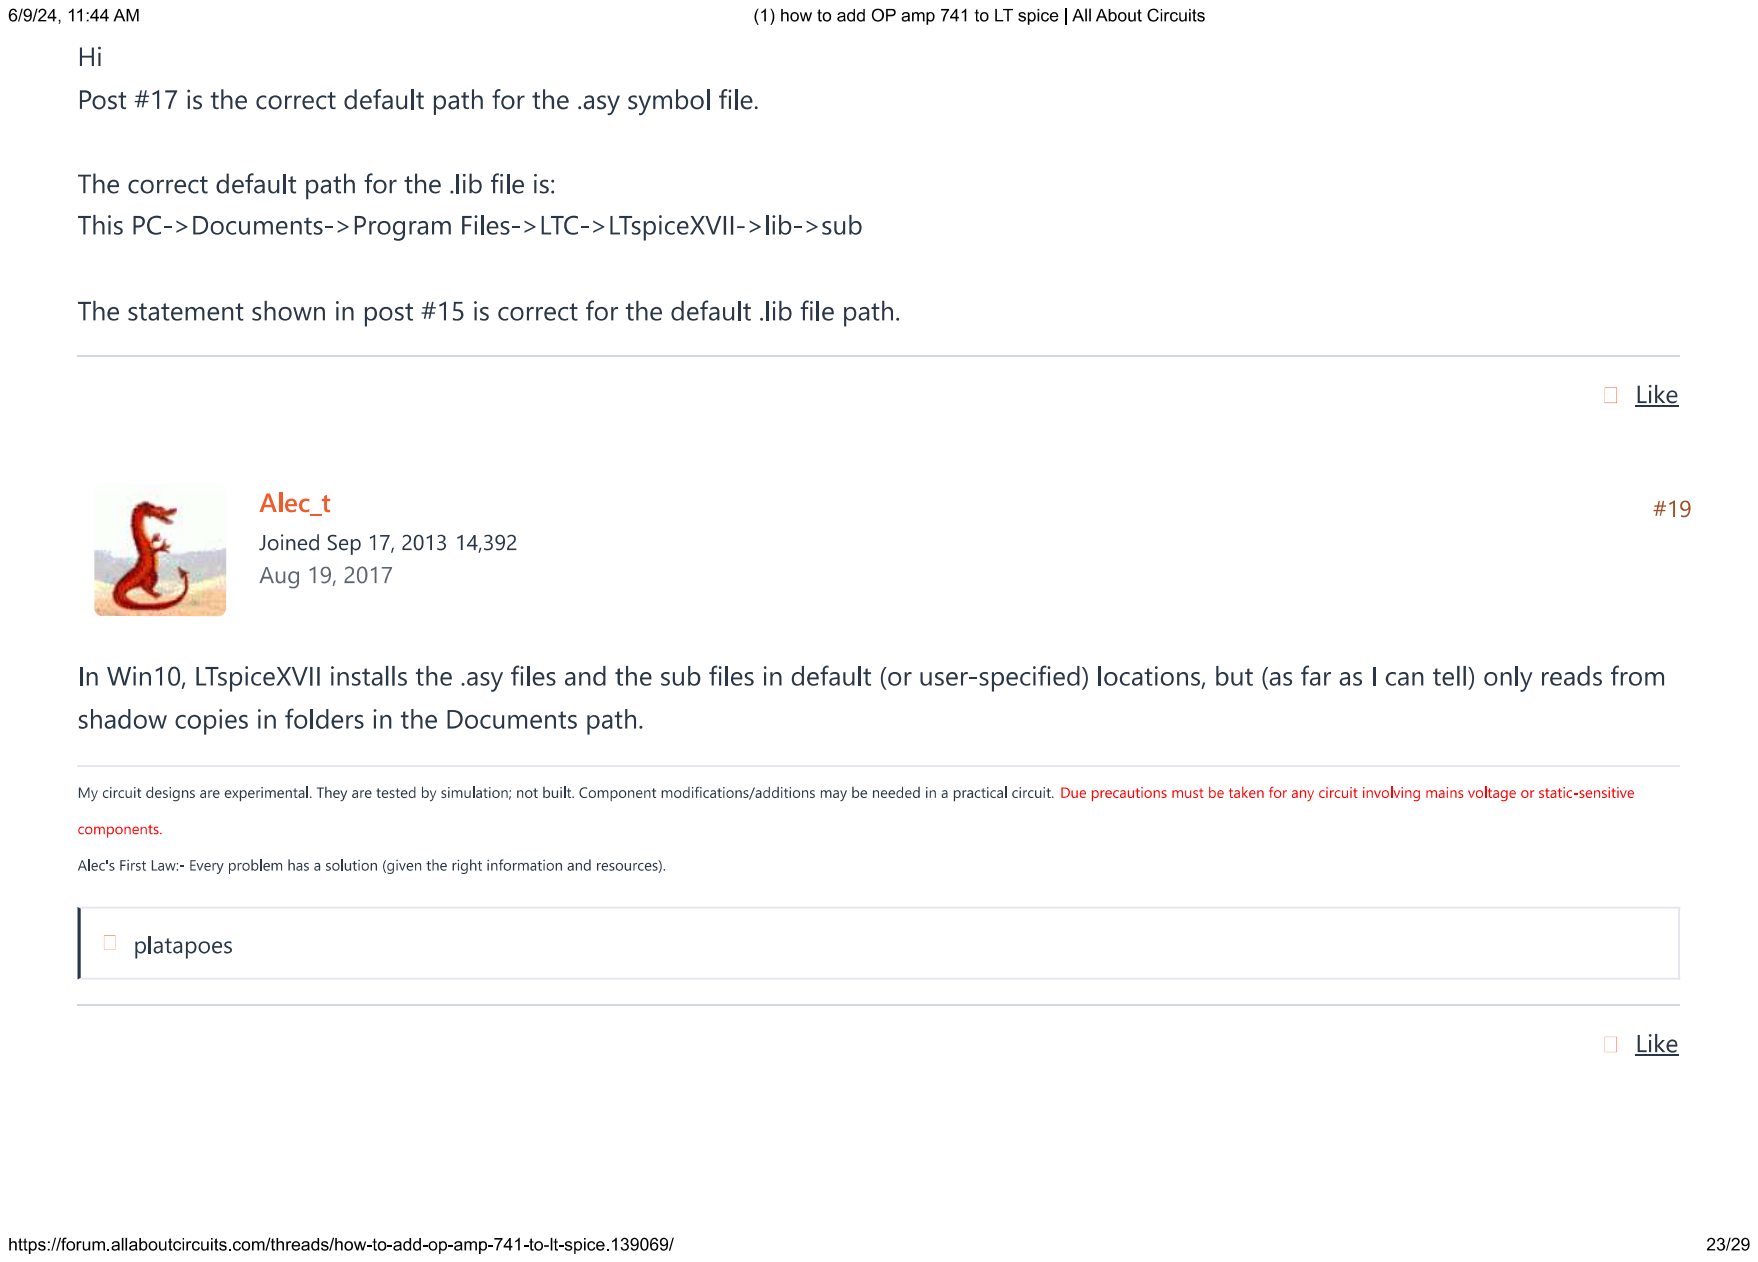
[picture p150: page 23]

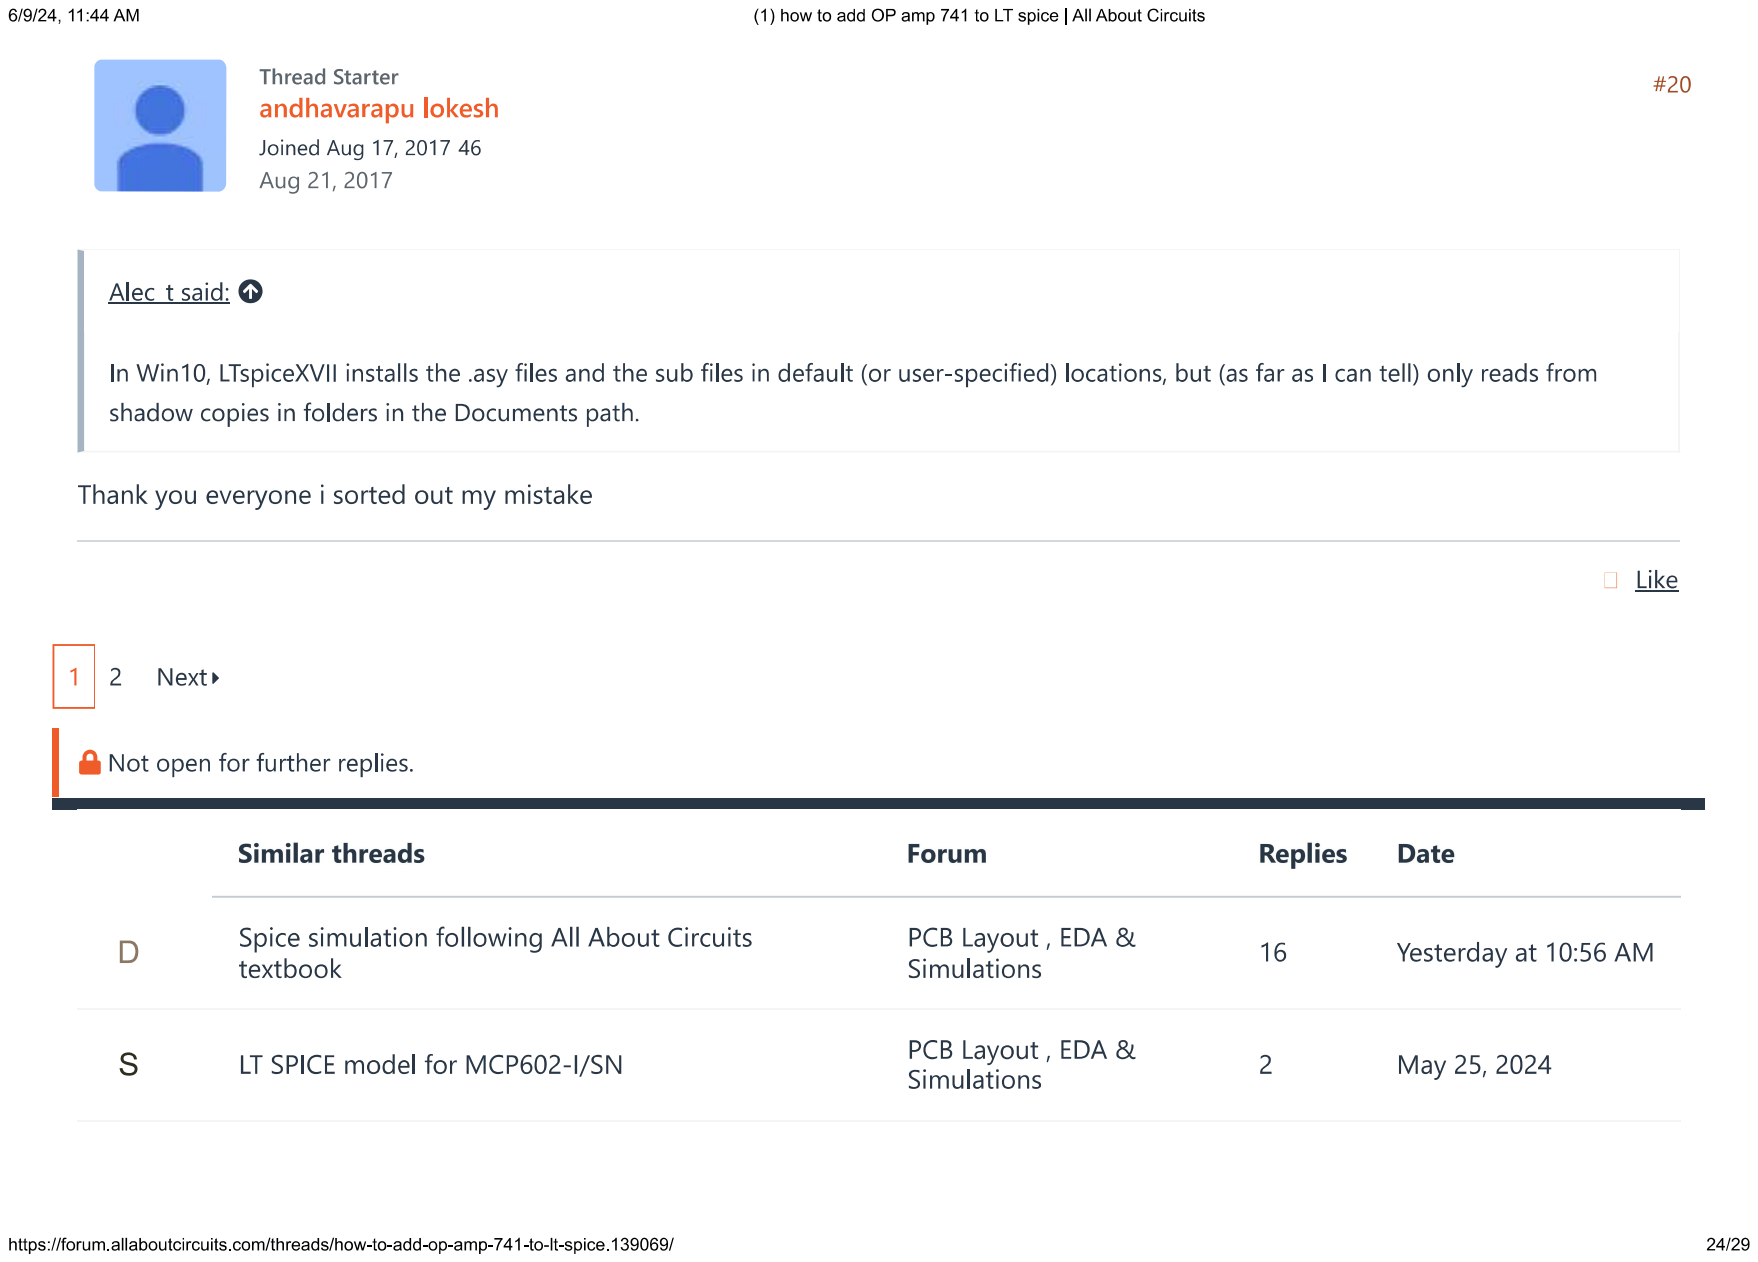
[picture p151: page 24]

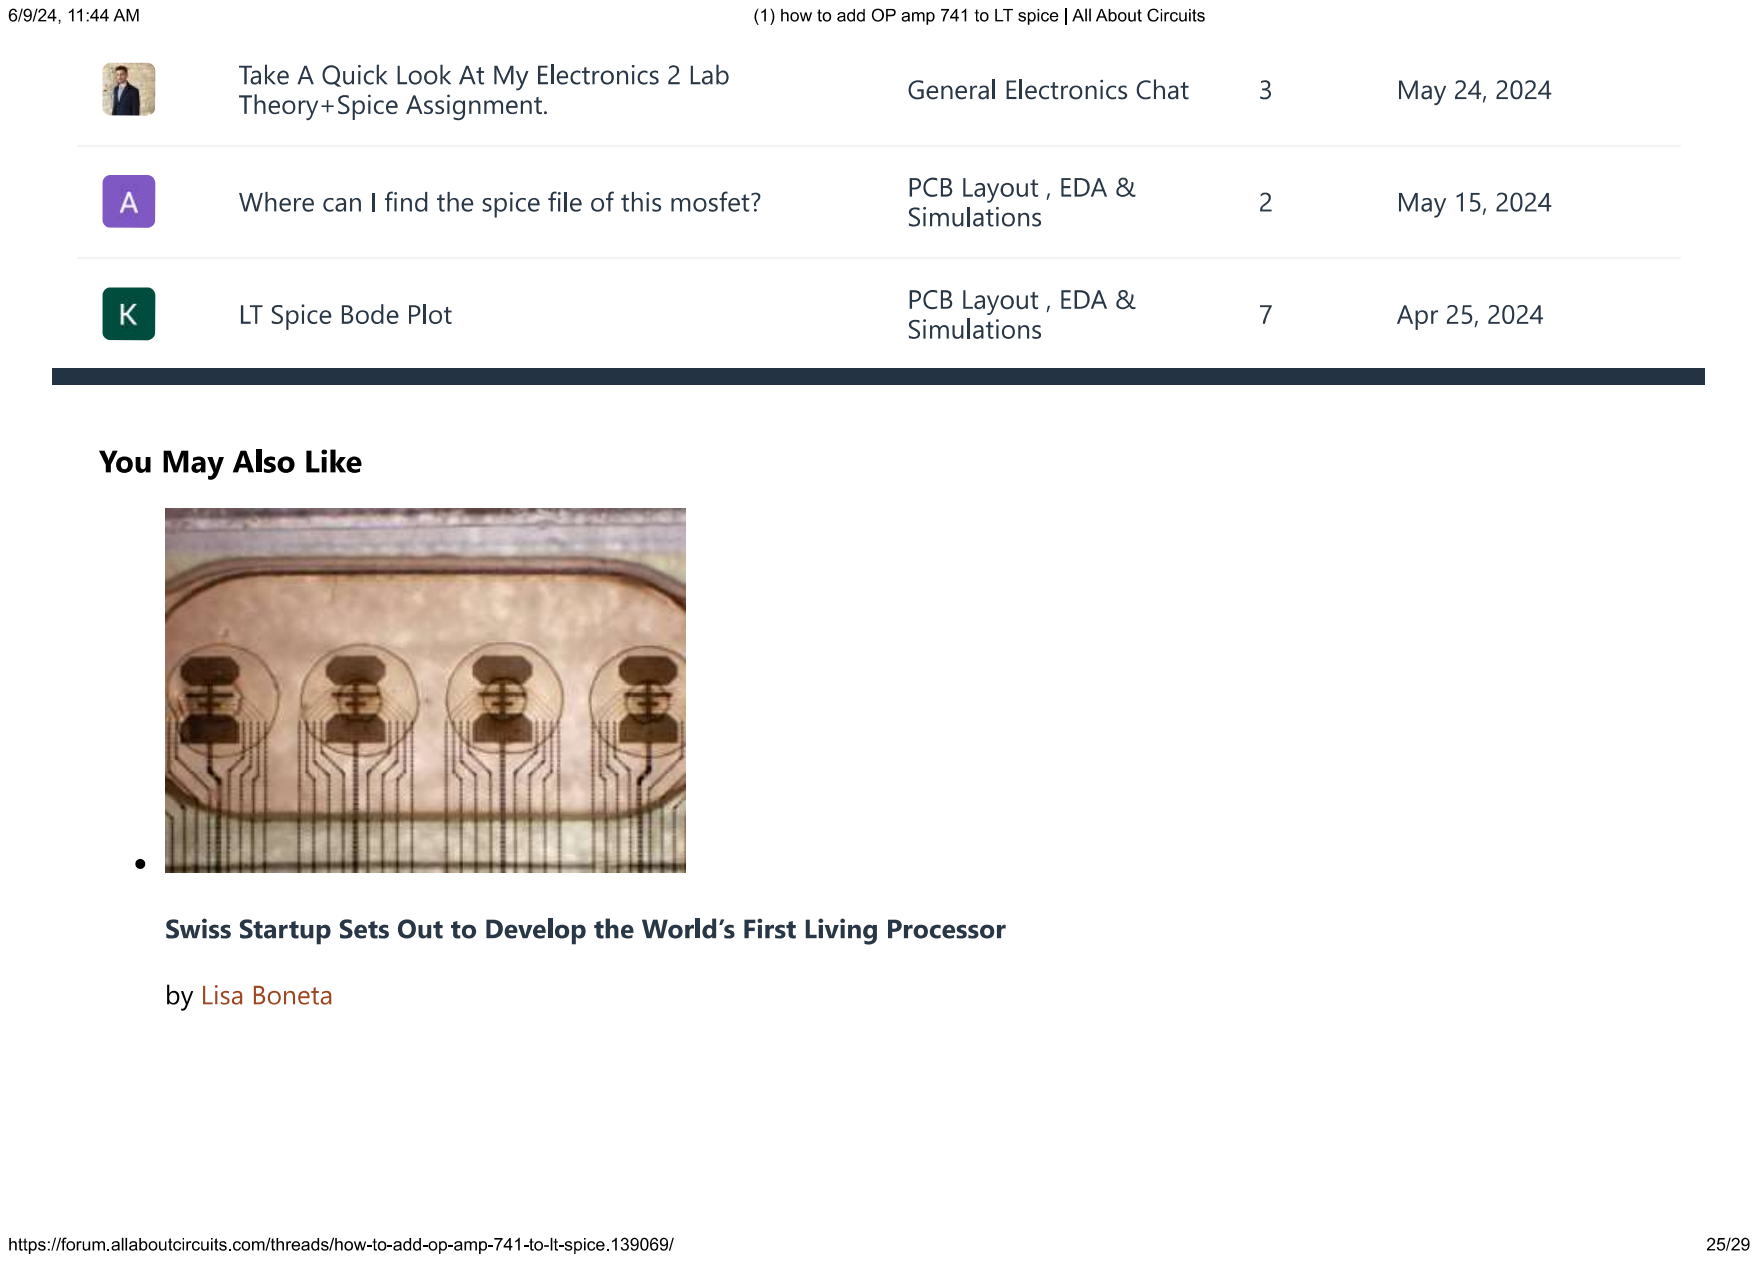
[picture p152: page 25]

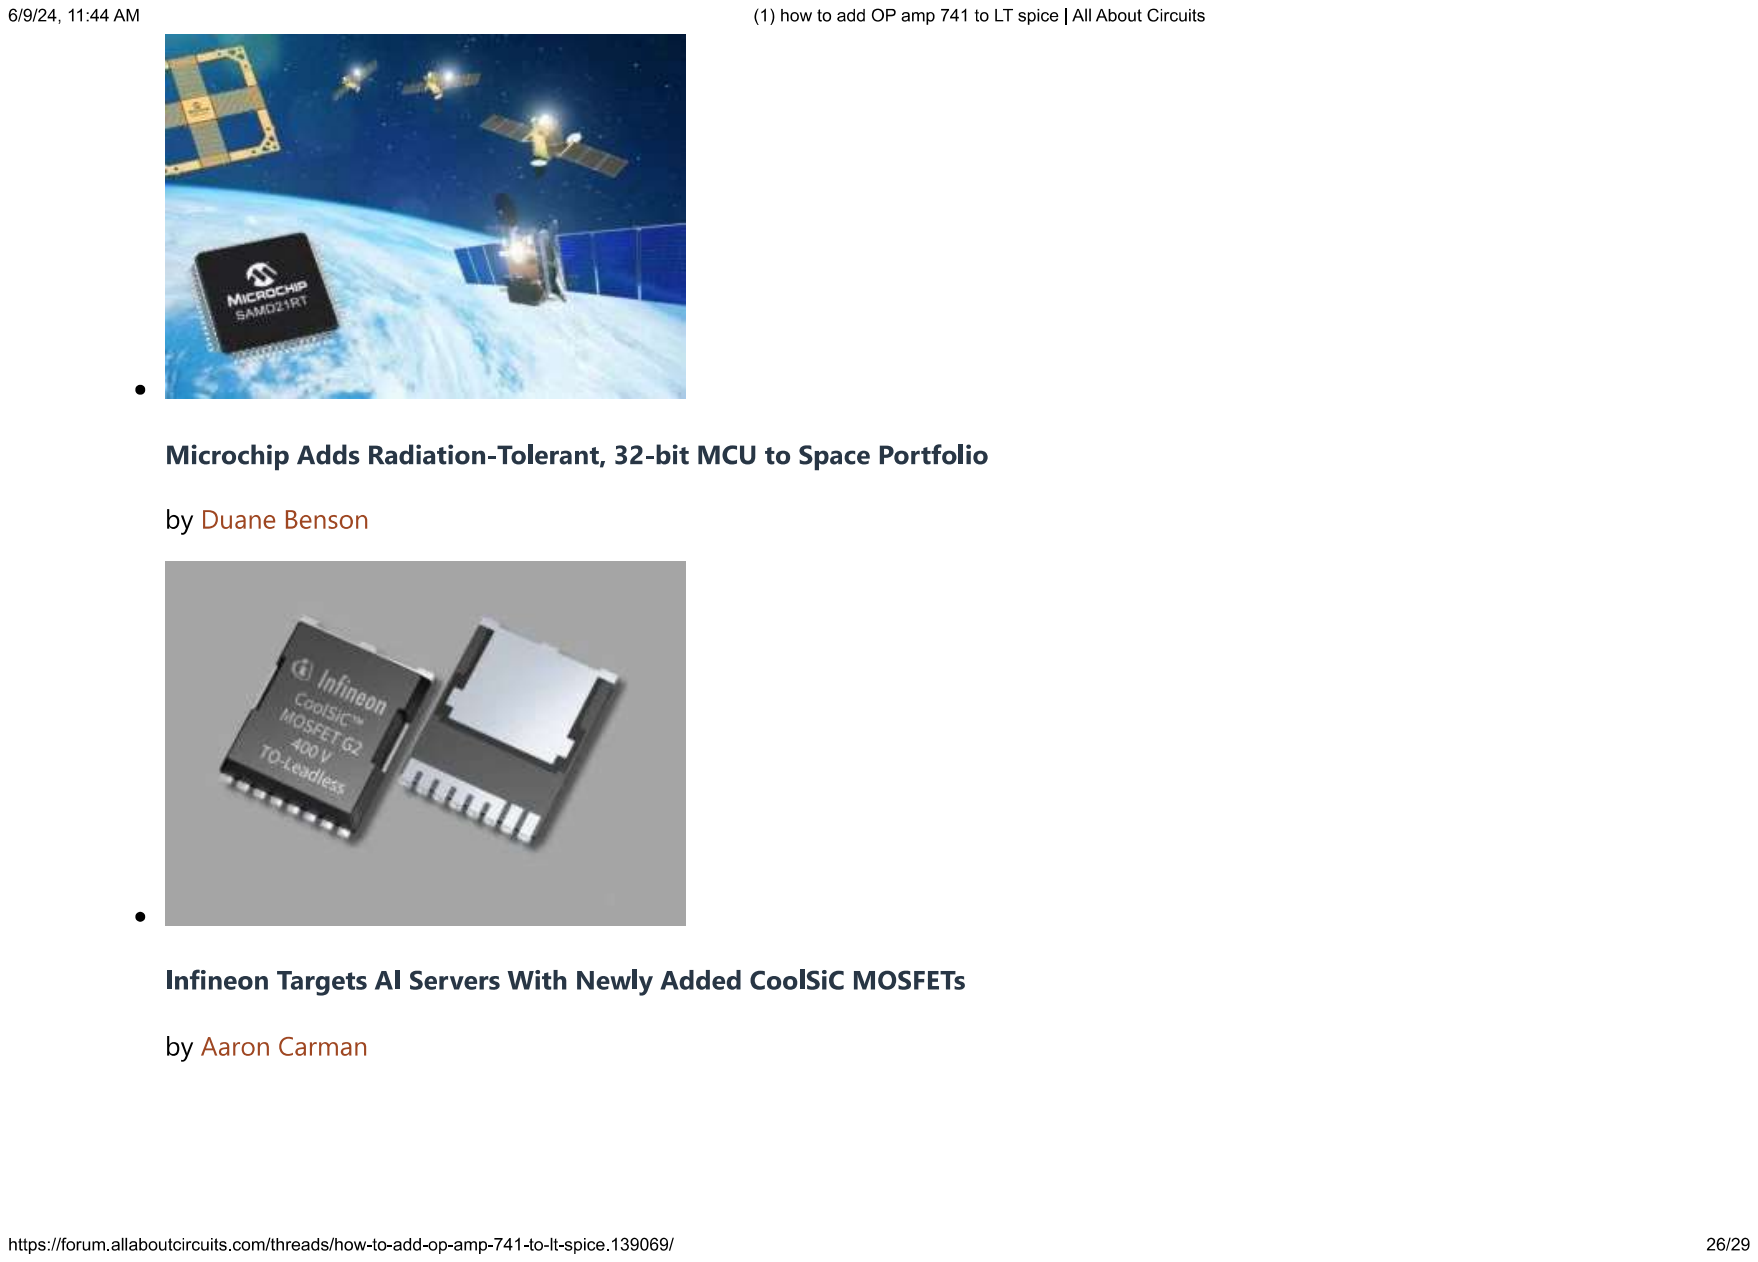
[picture p153: page 26]

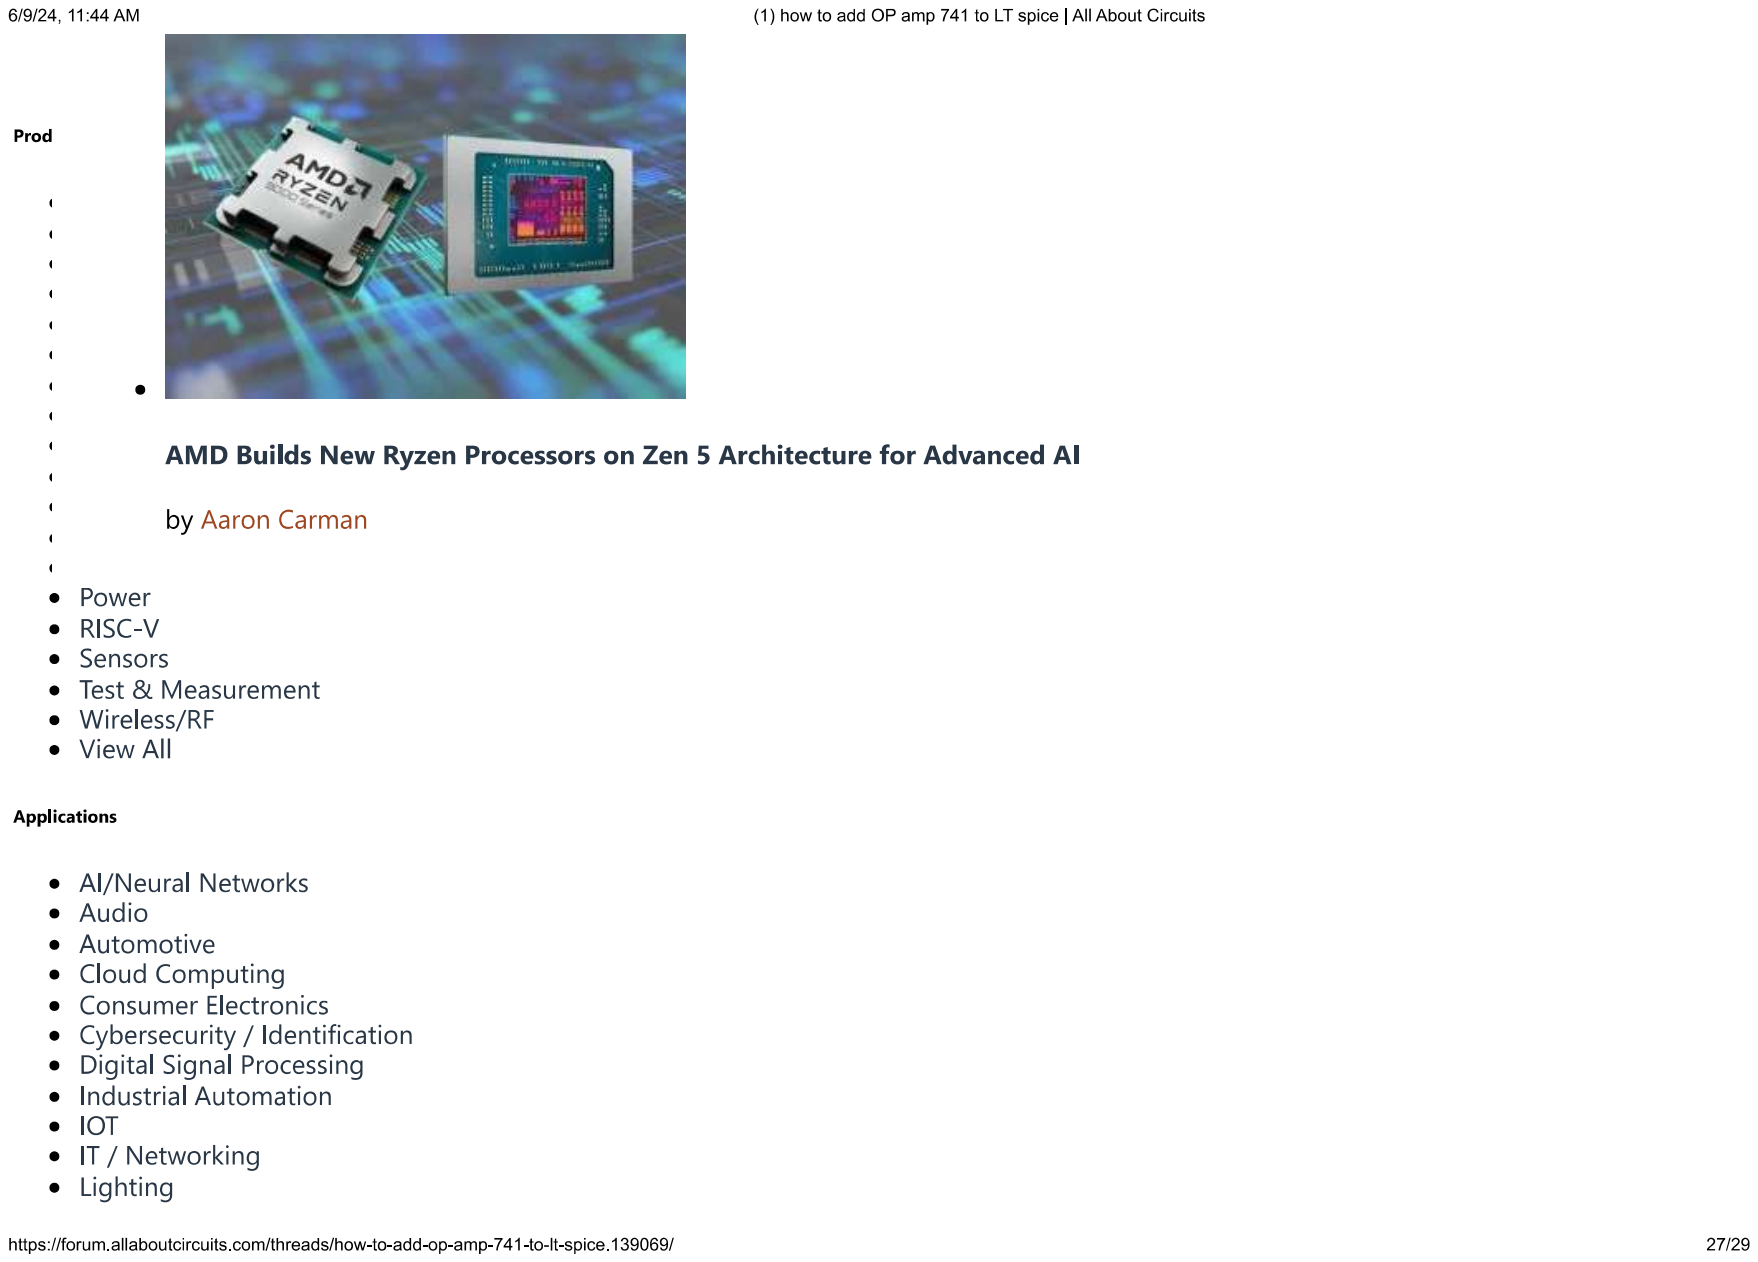
[picture p154: page 27]

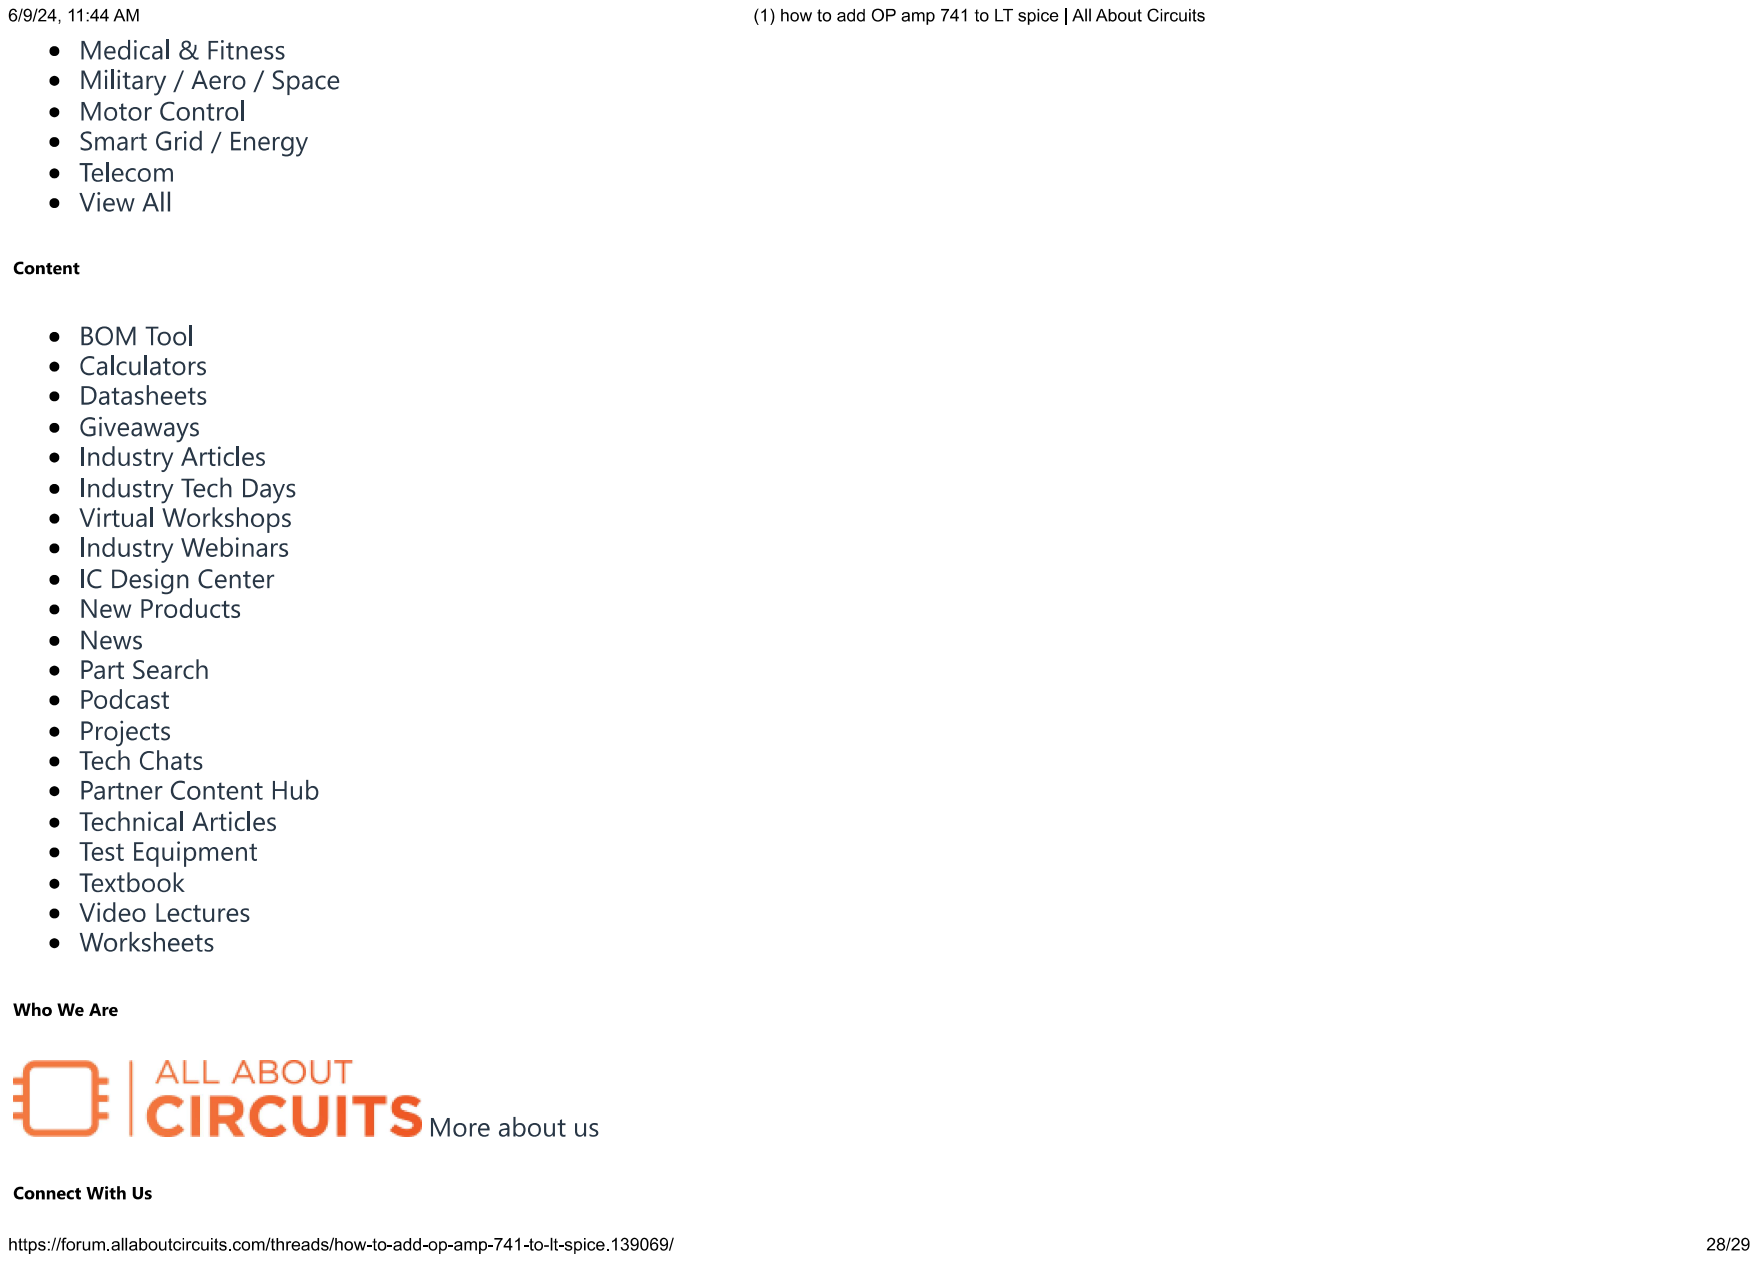
[picture p155: page 28]

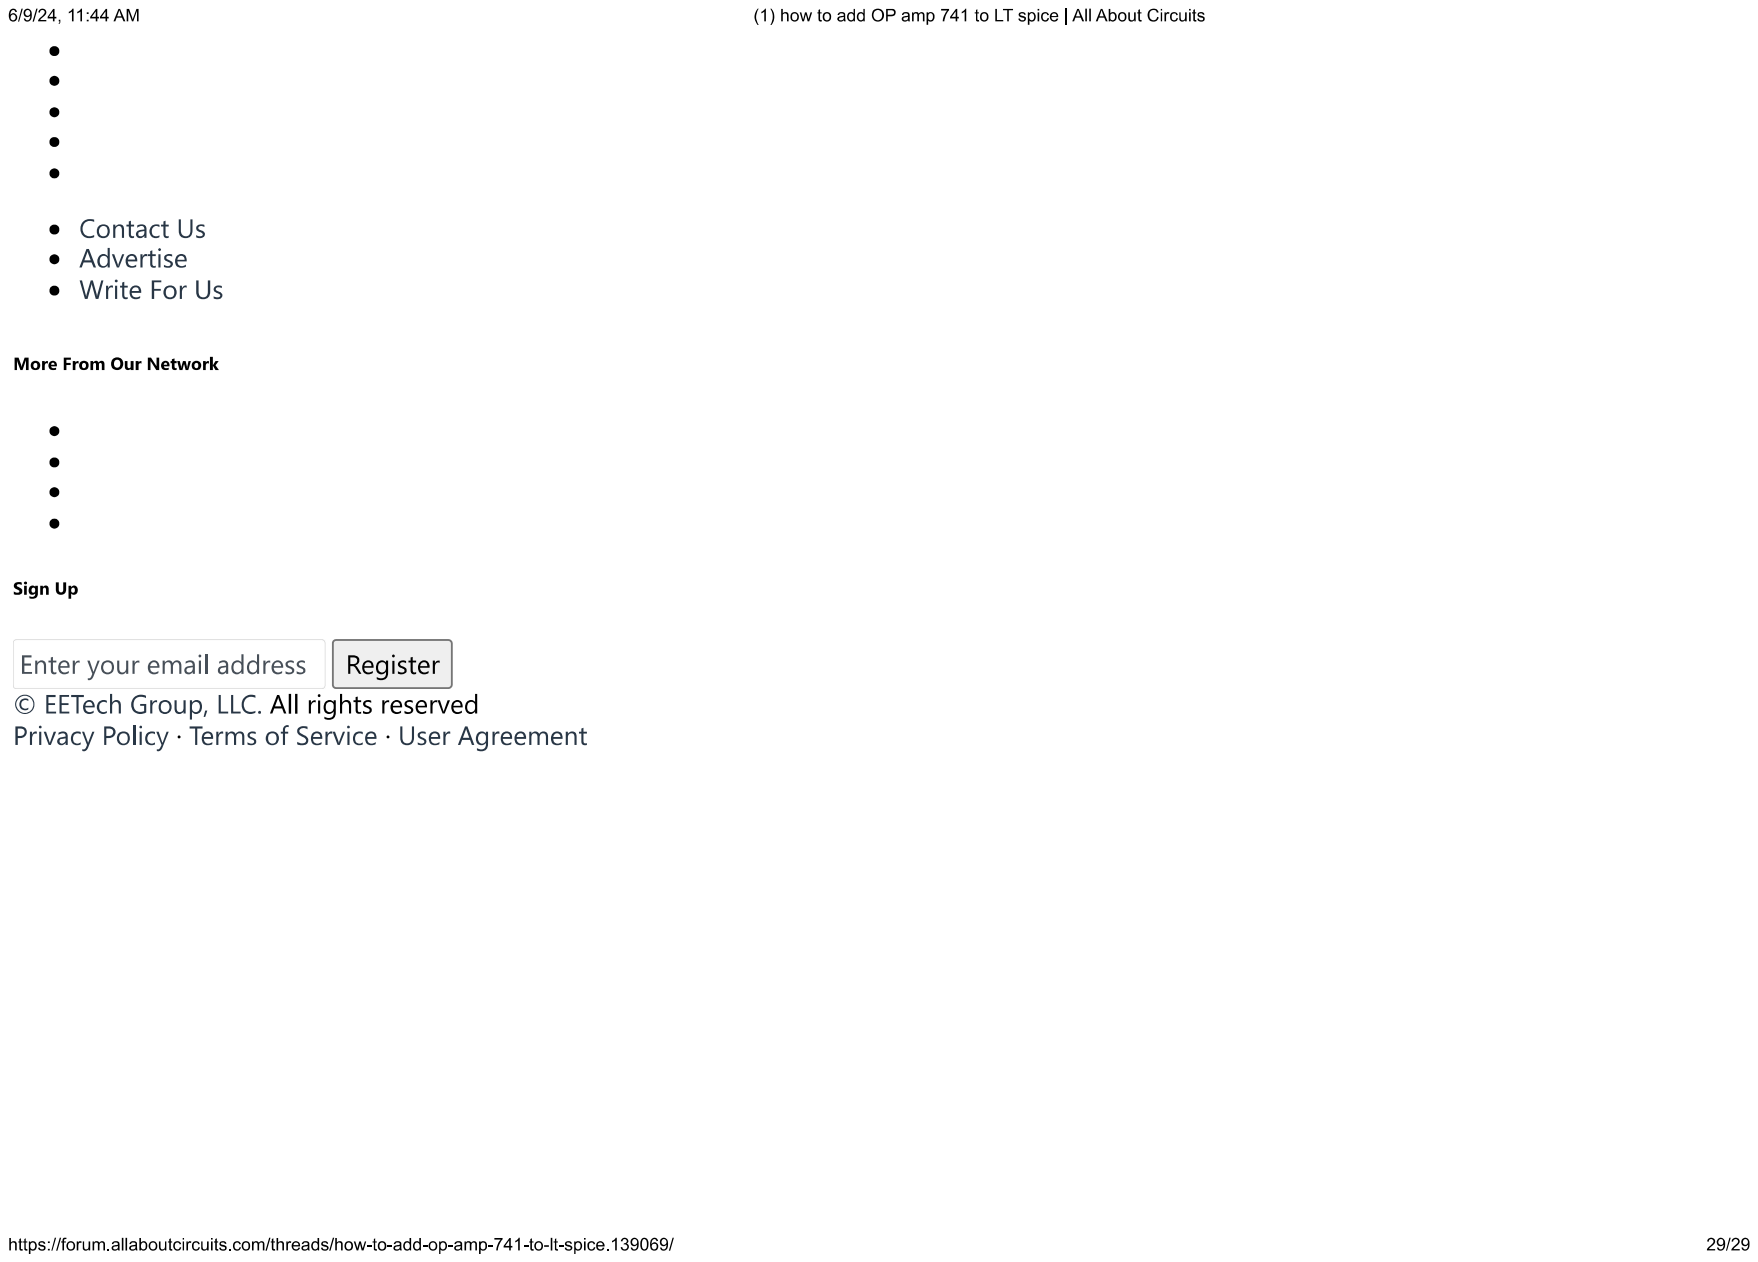
[picture p156: page 29]
