erdemcanaz/EE464-Emine-BOOSTanci/PDFs/PDFs etc/lt_spice functions.pdf

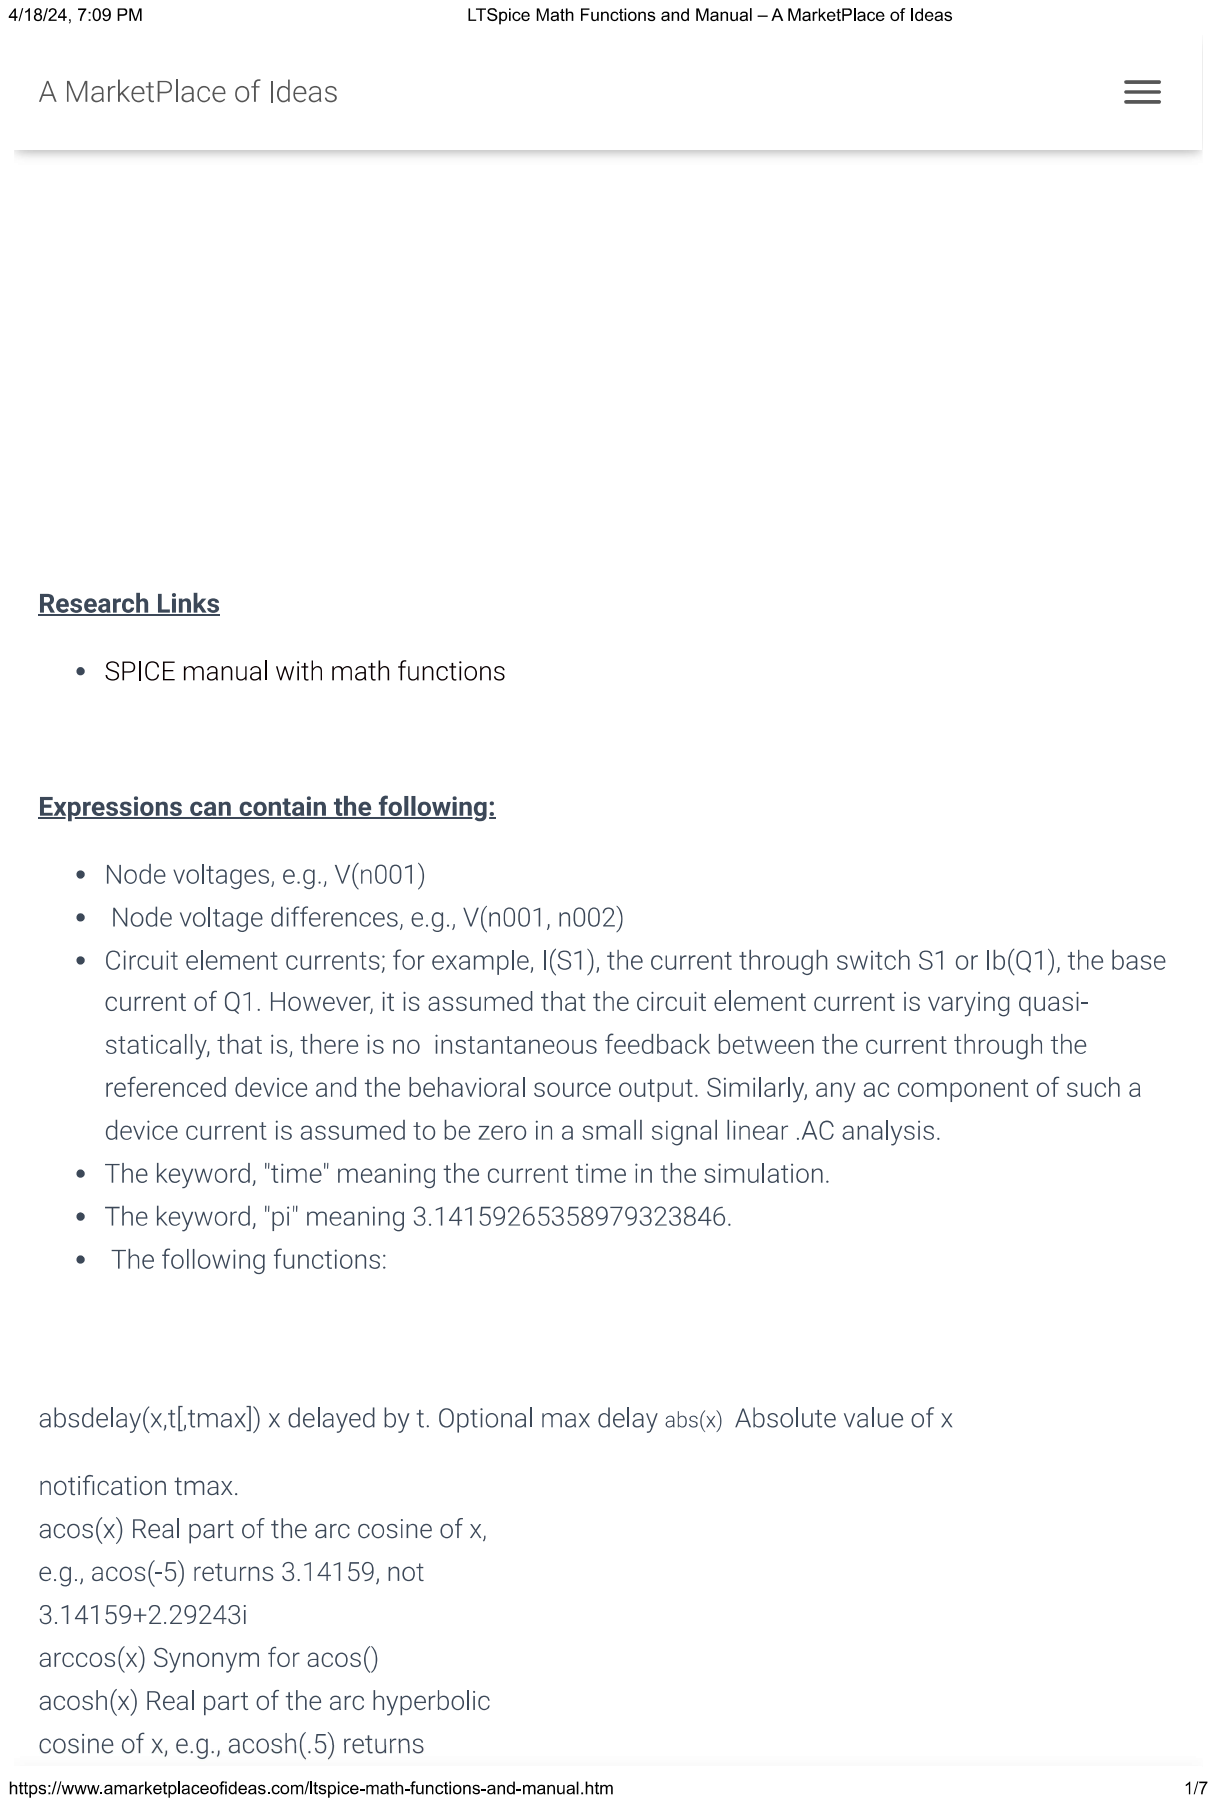
[picture p157: page 1]

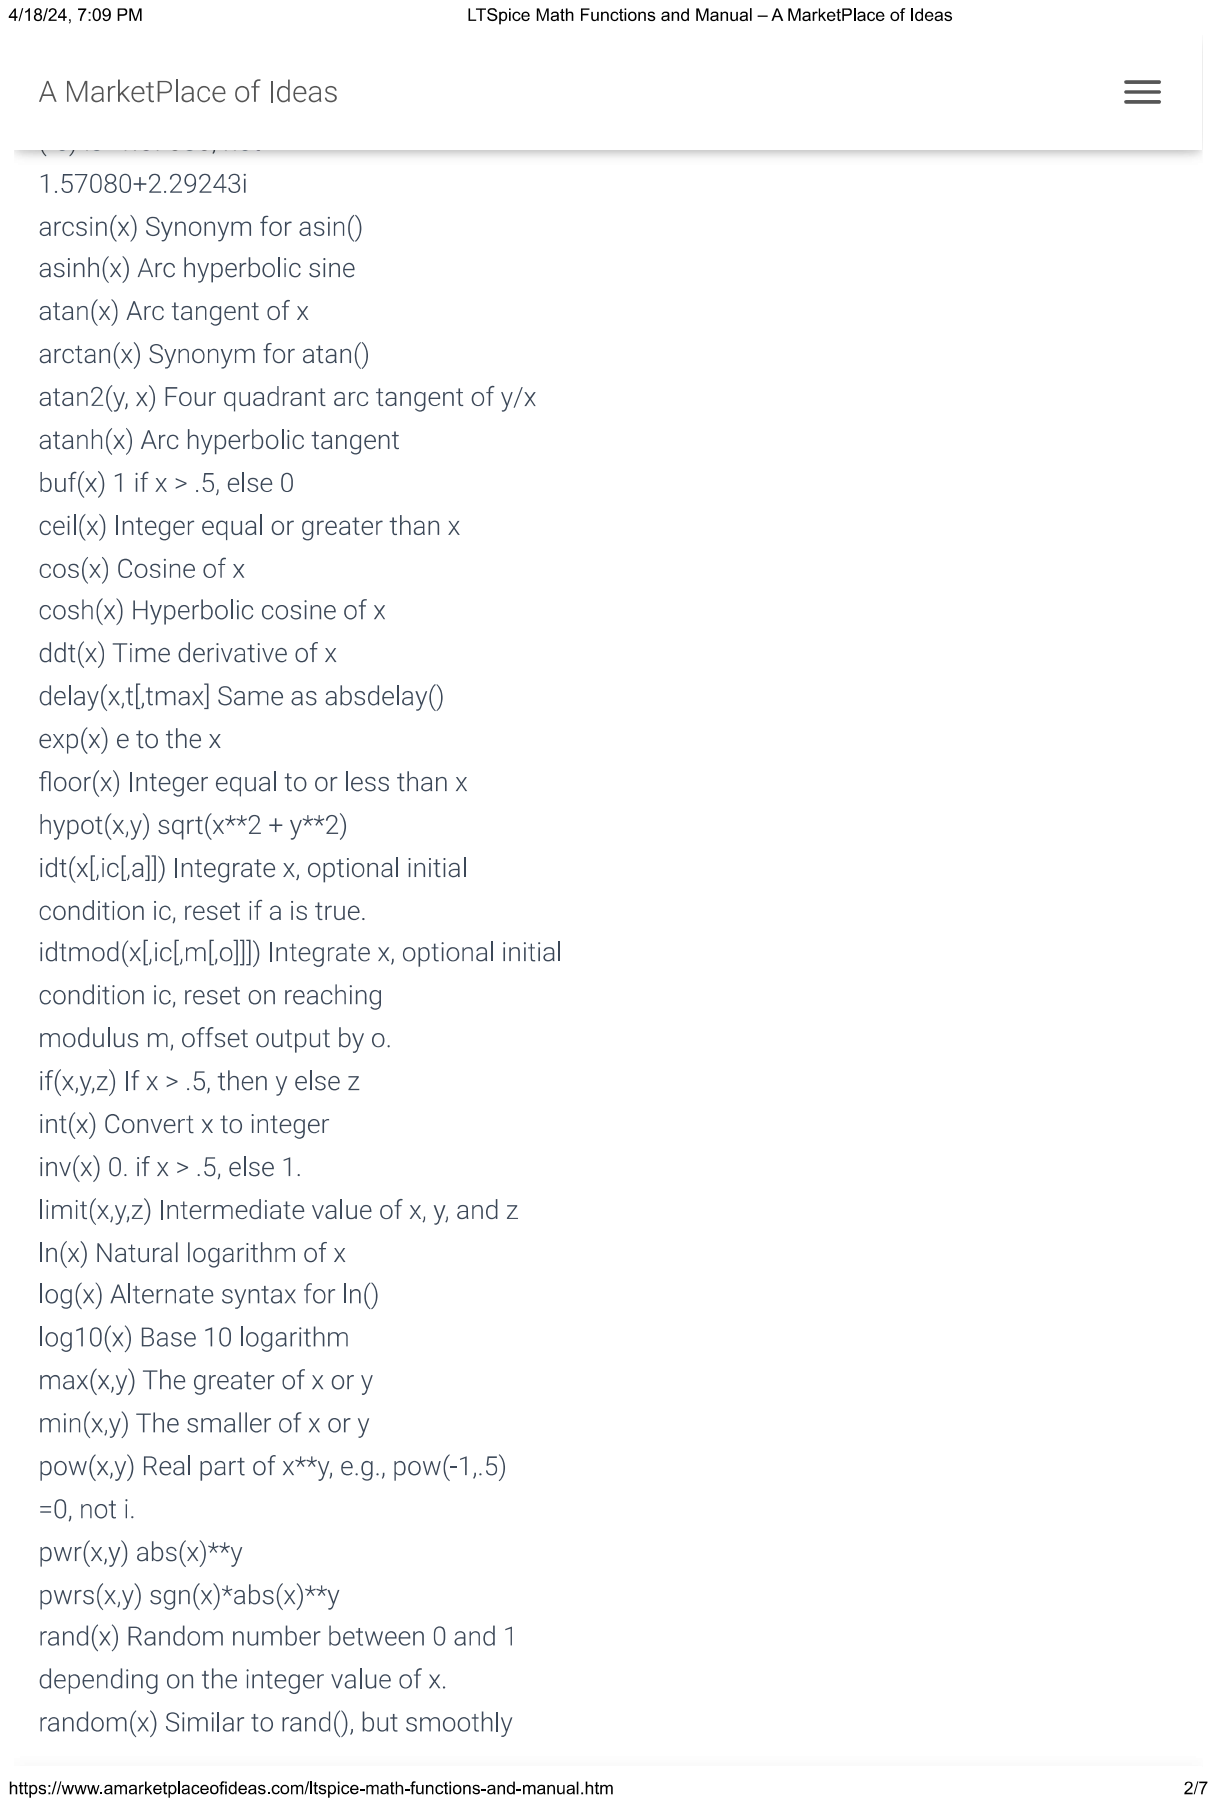
[picture p158: page 2]

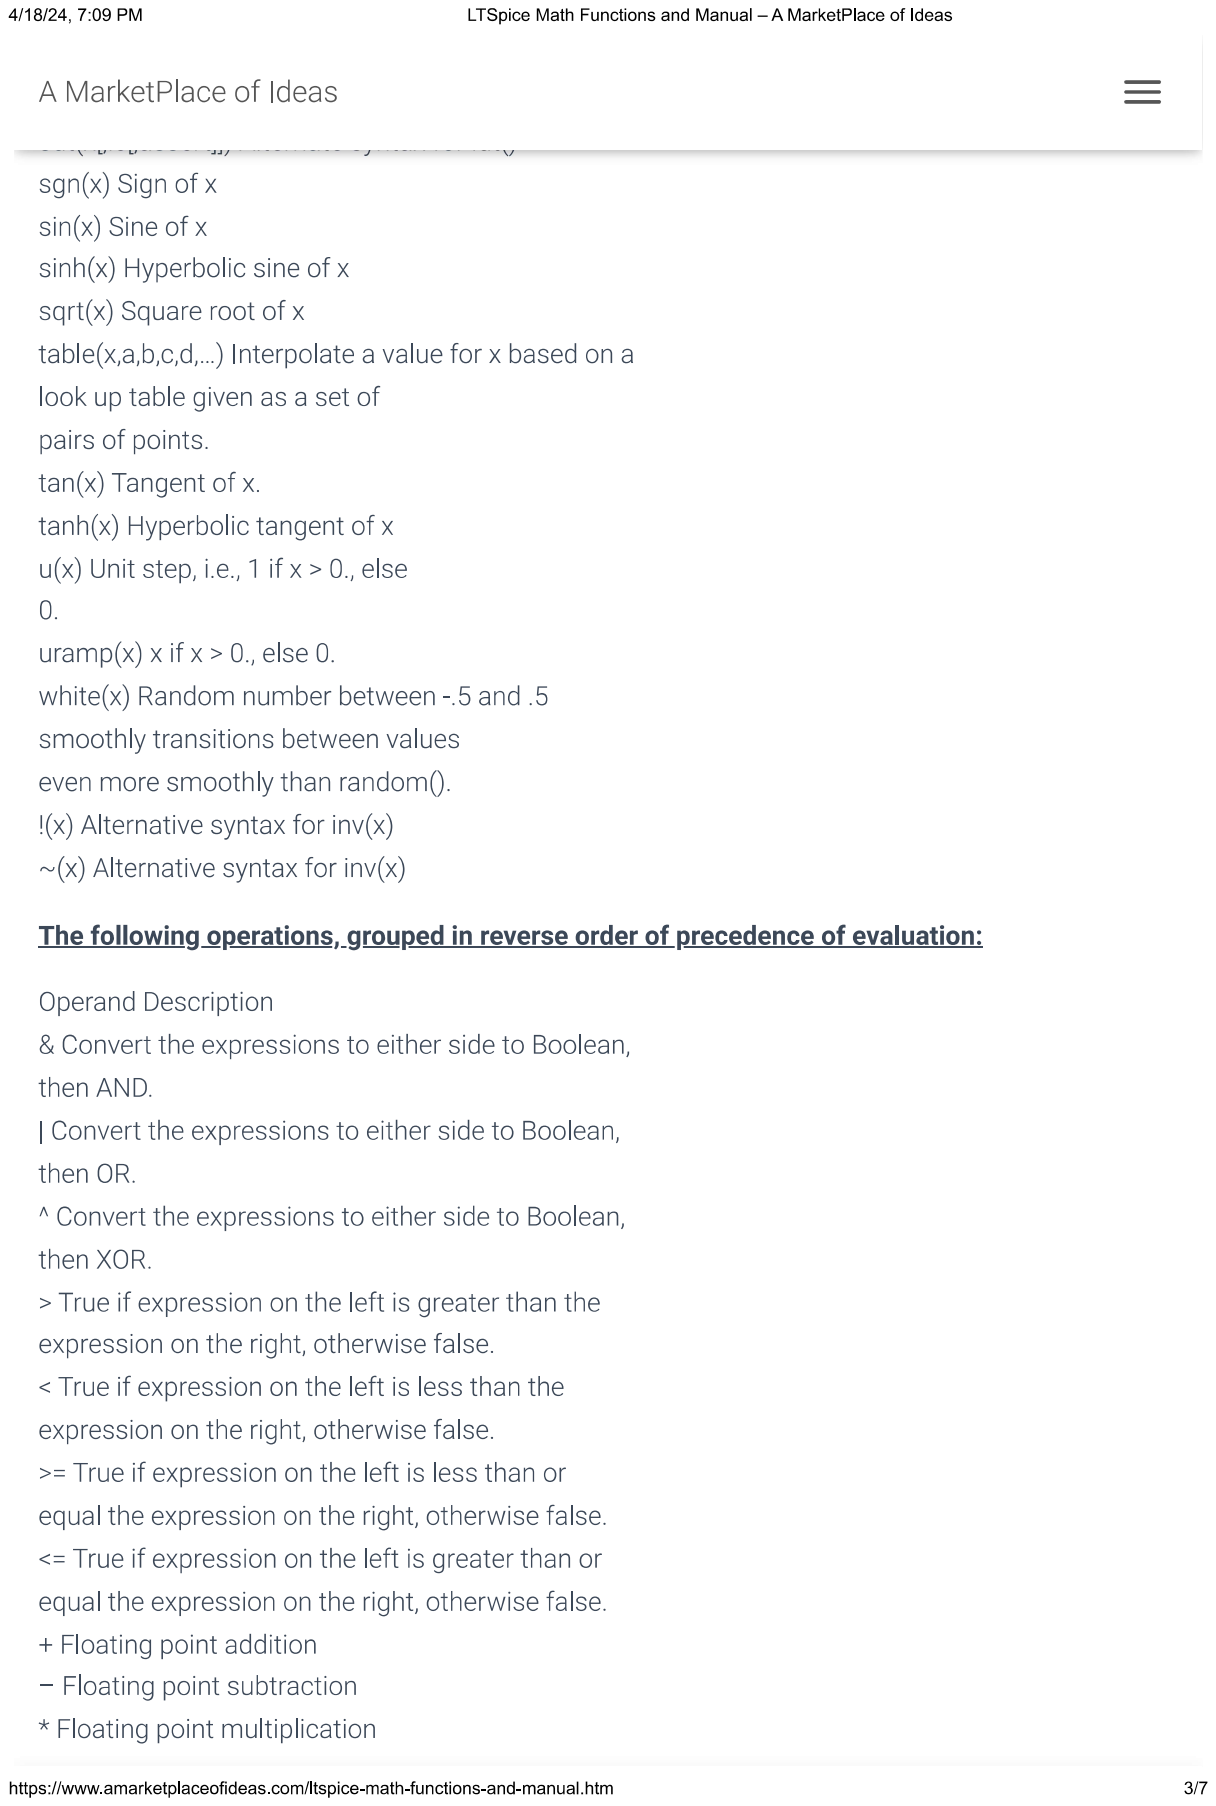
[picture p159: page 3]

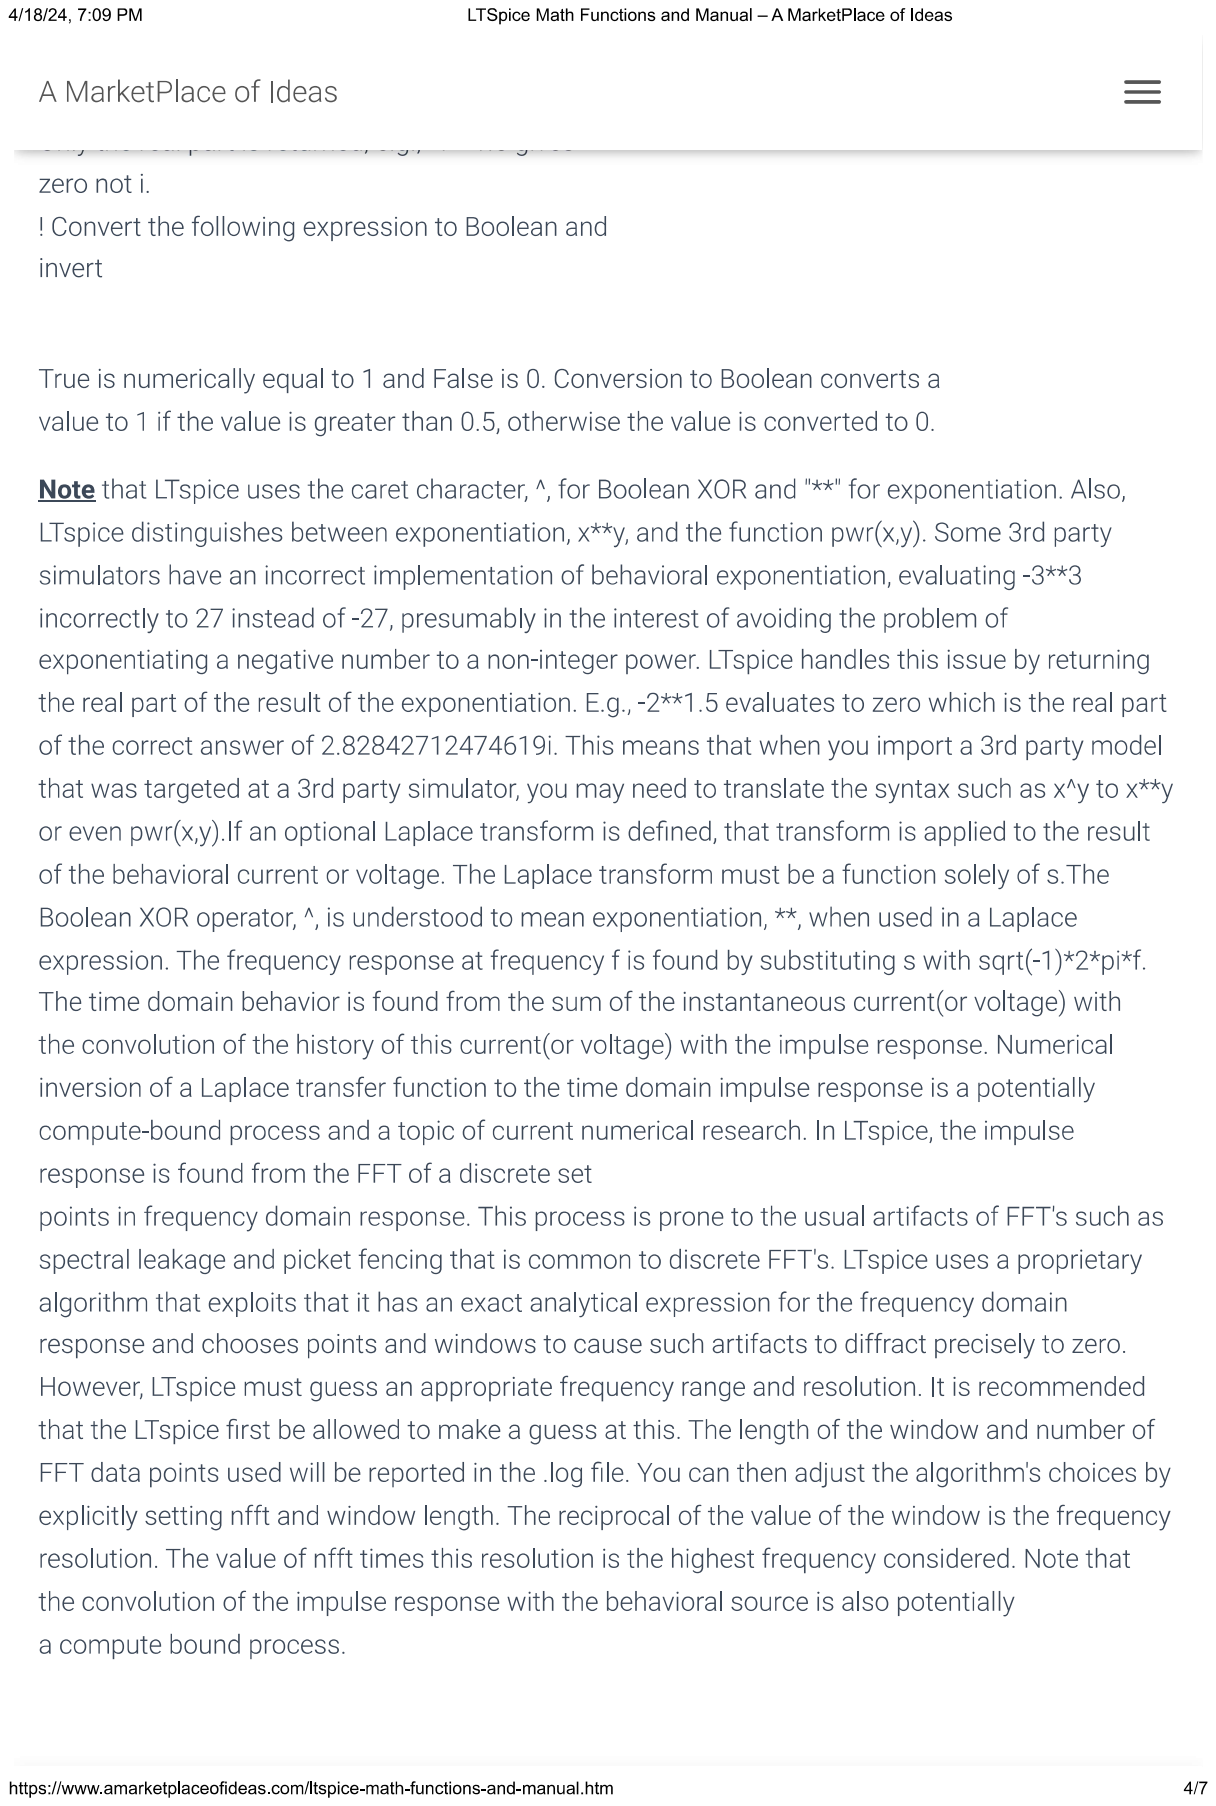
[picture p160: page 4]

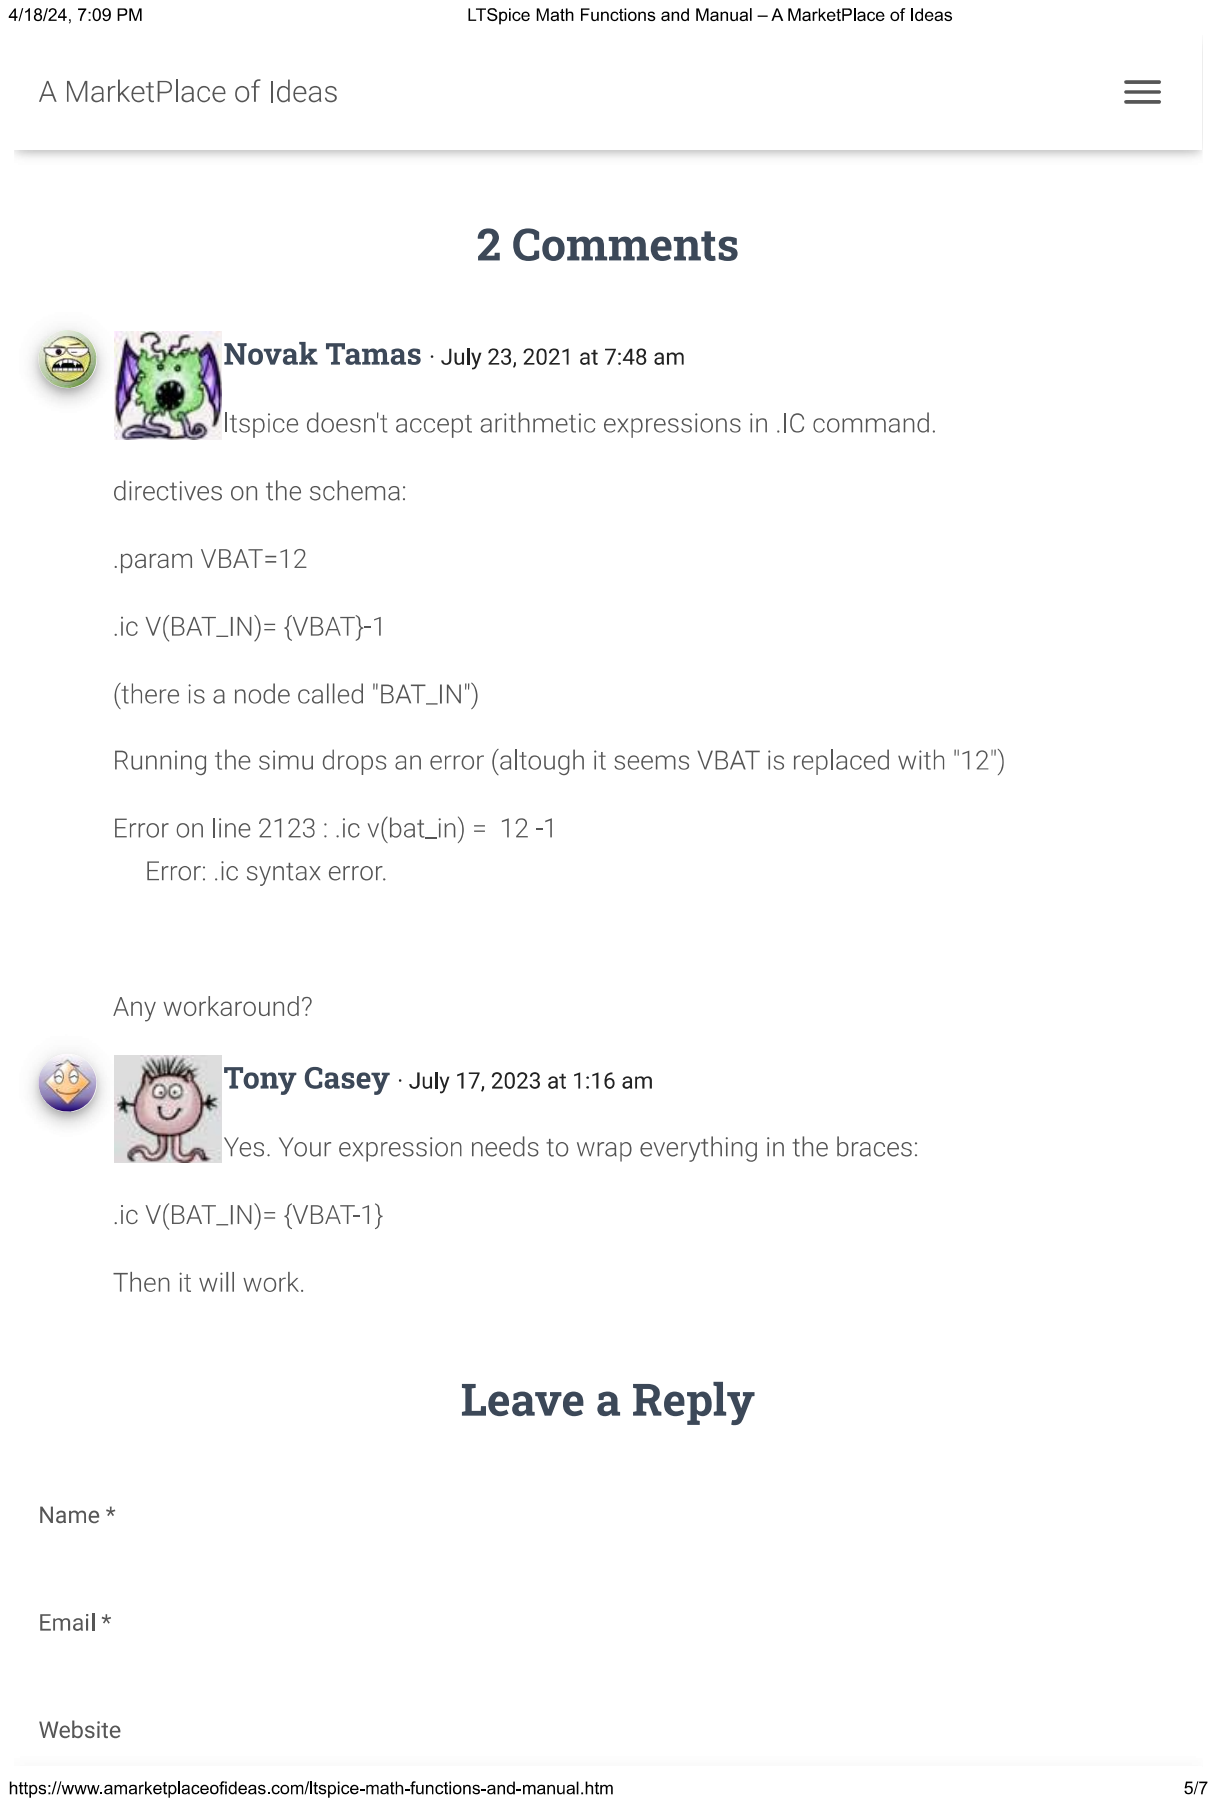
[picture p161: page 5]

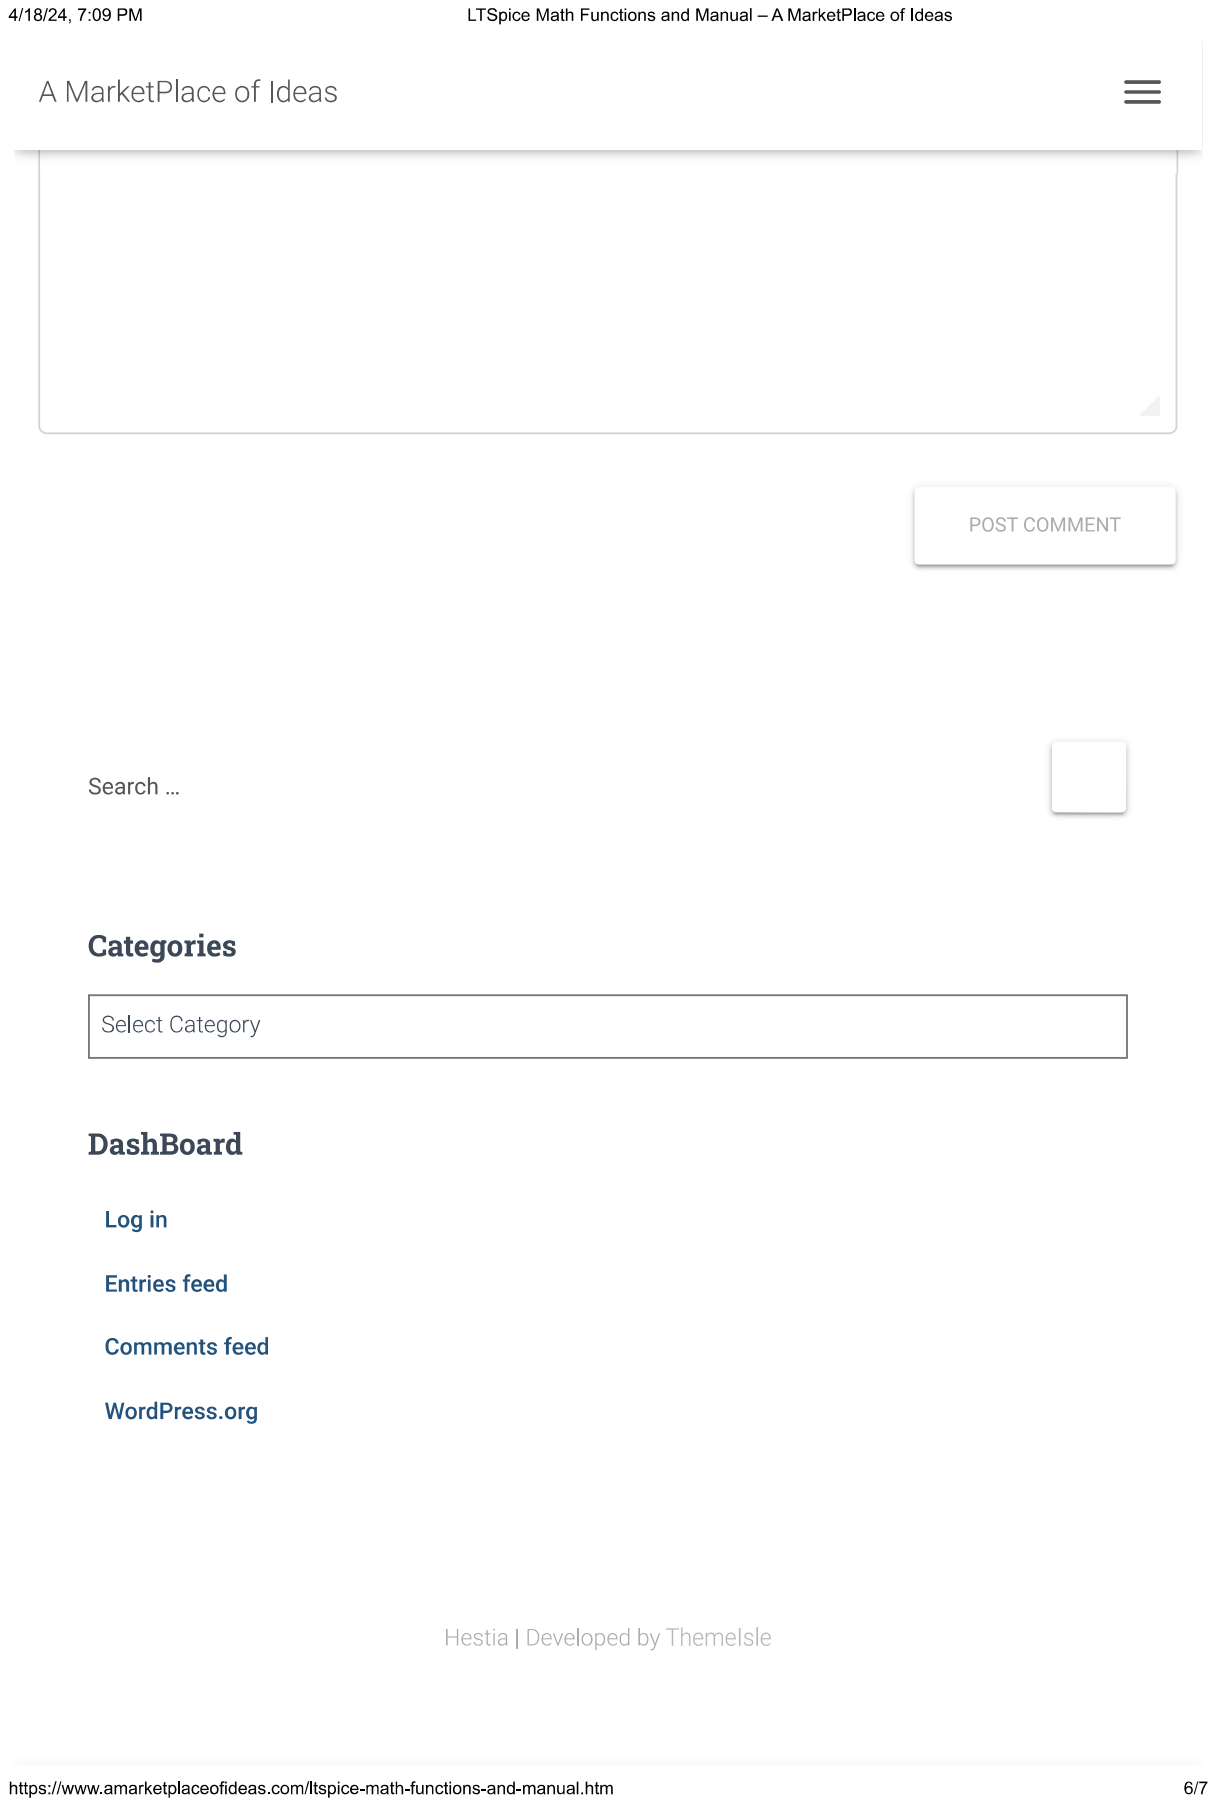
[picture p162: page 6]

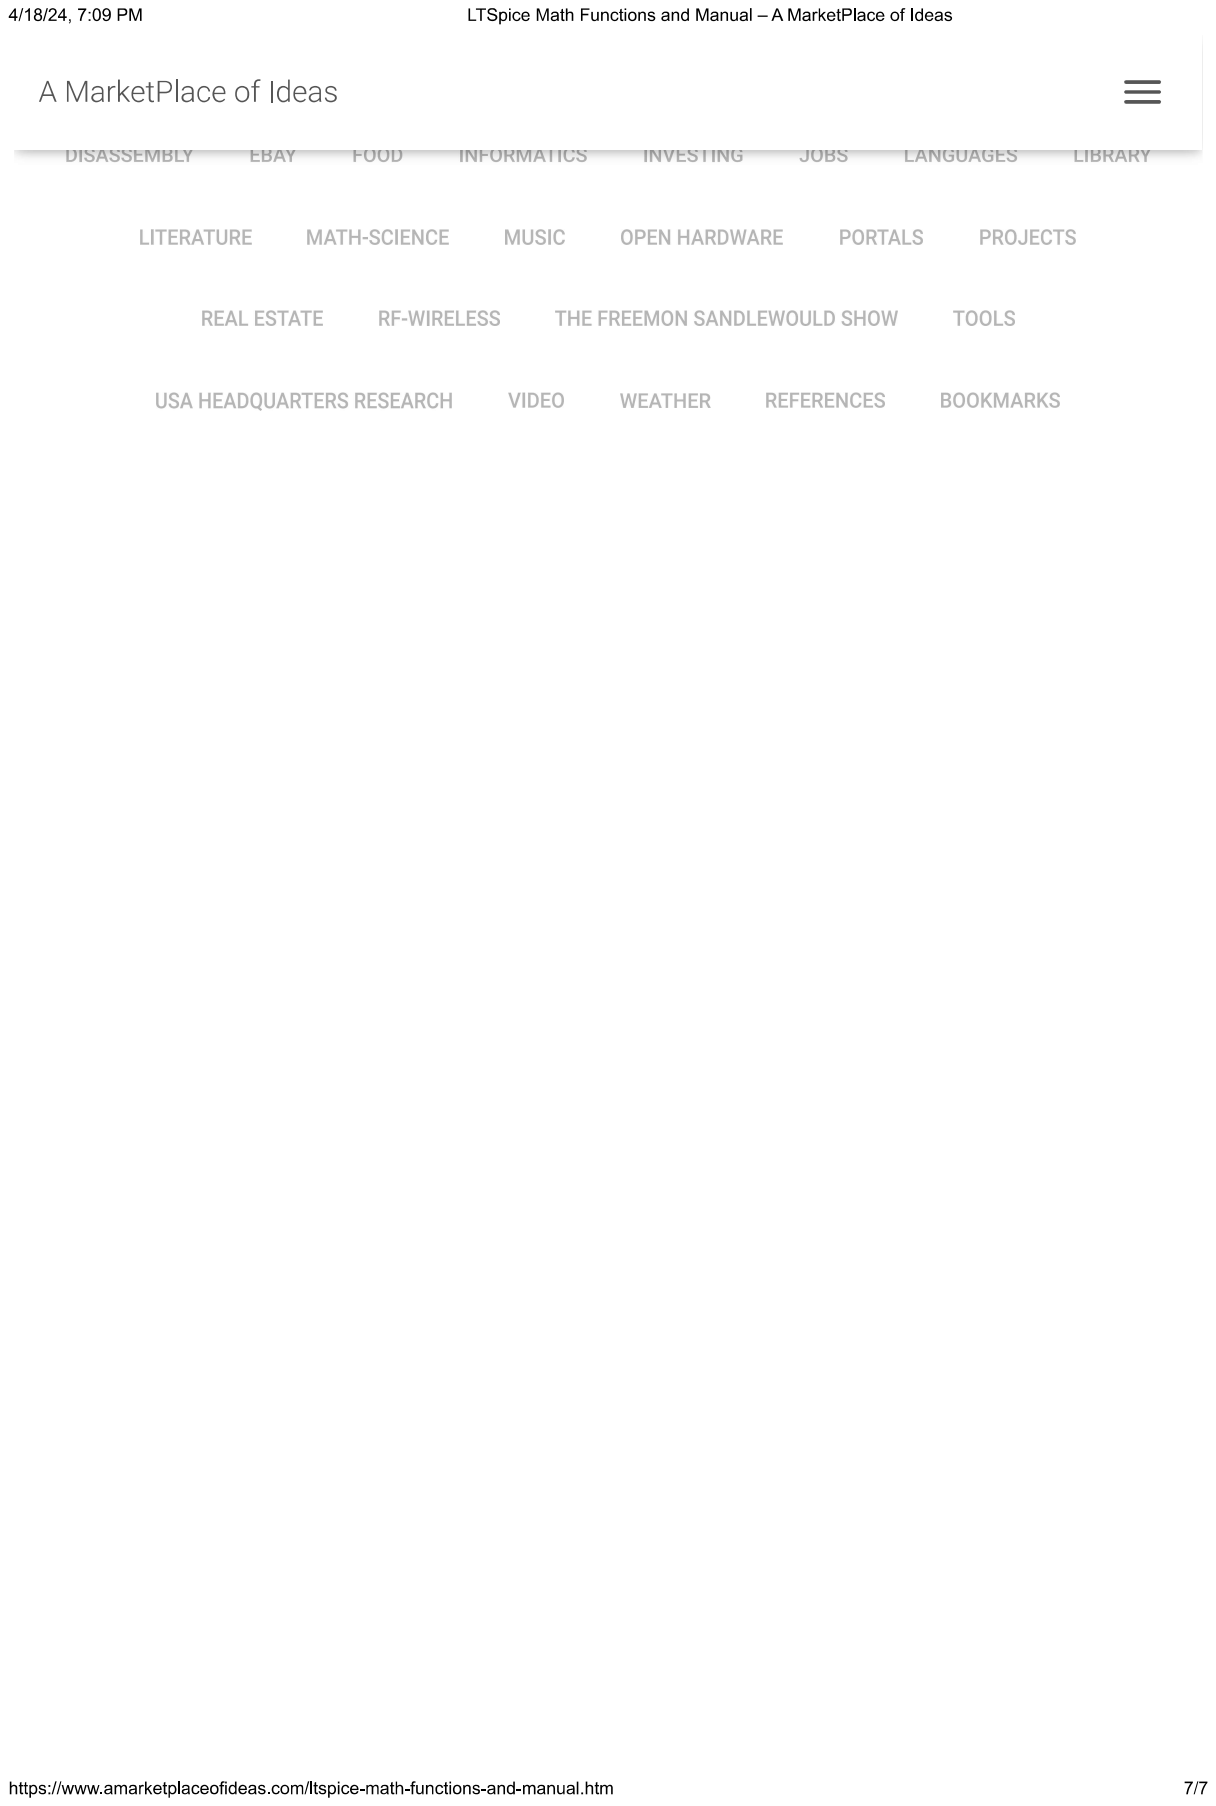
[picture p163: page 7]
