erdemcanaz/EE464-Emine-BOOSTanci/PDFs/PDFs etc/ltspice functions.pdf

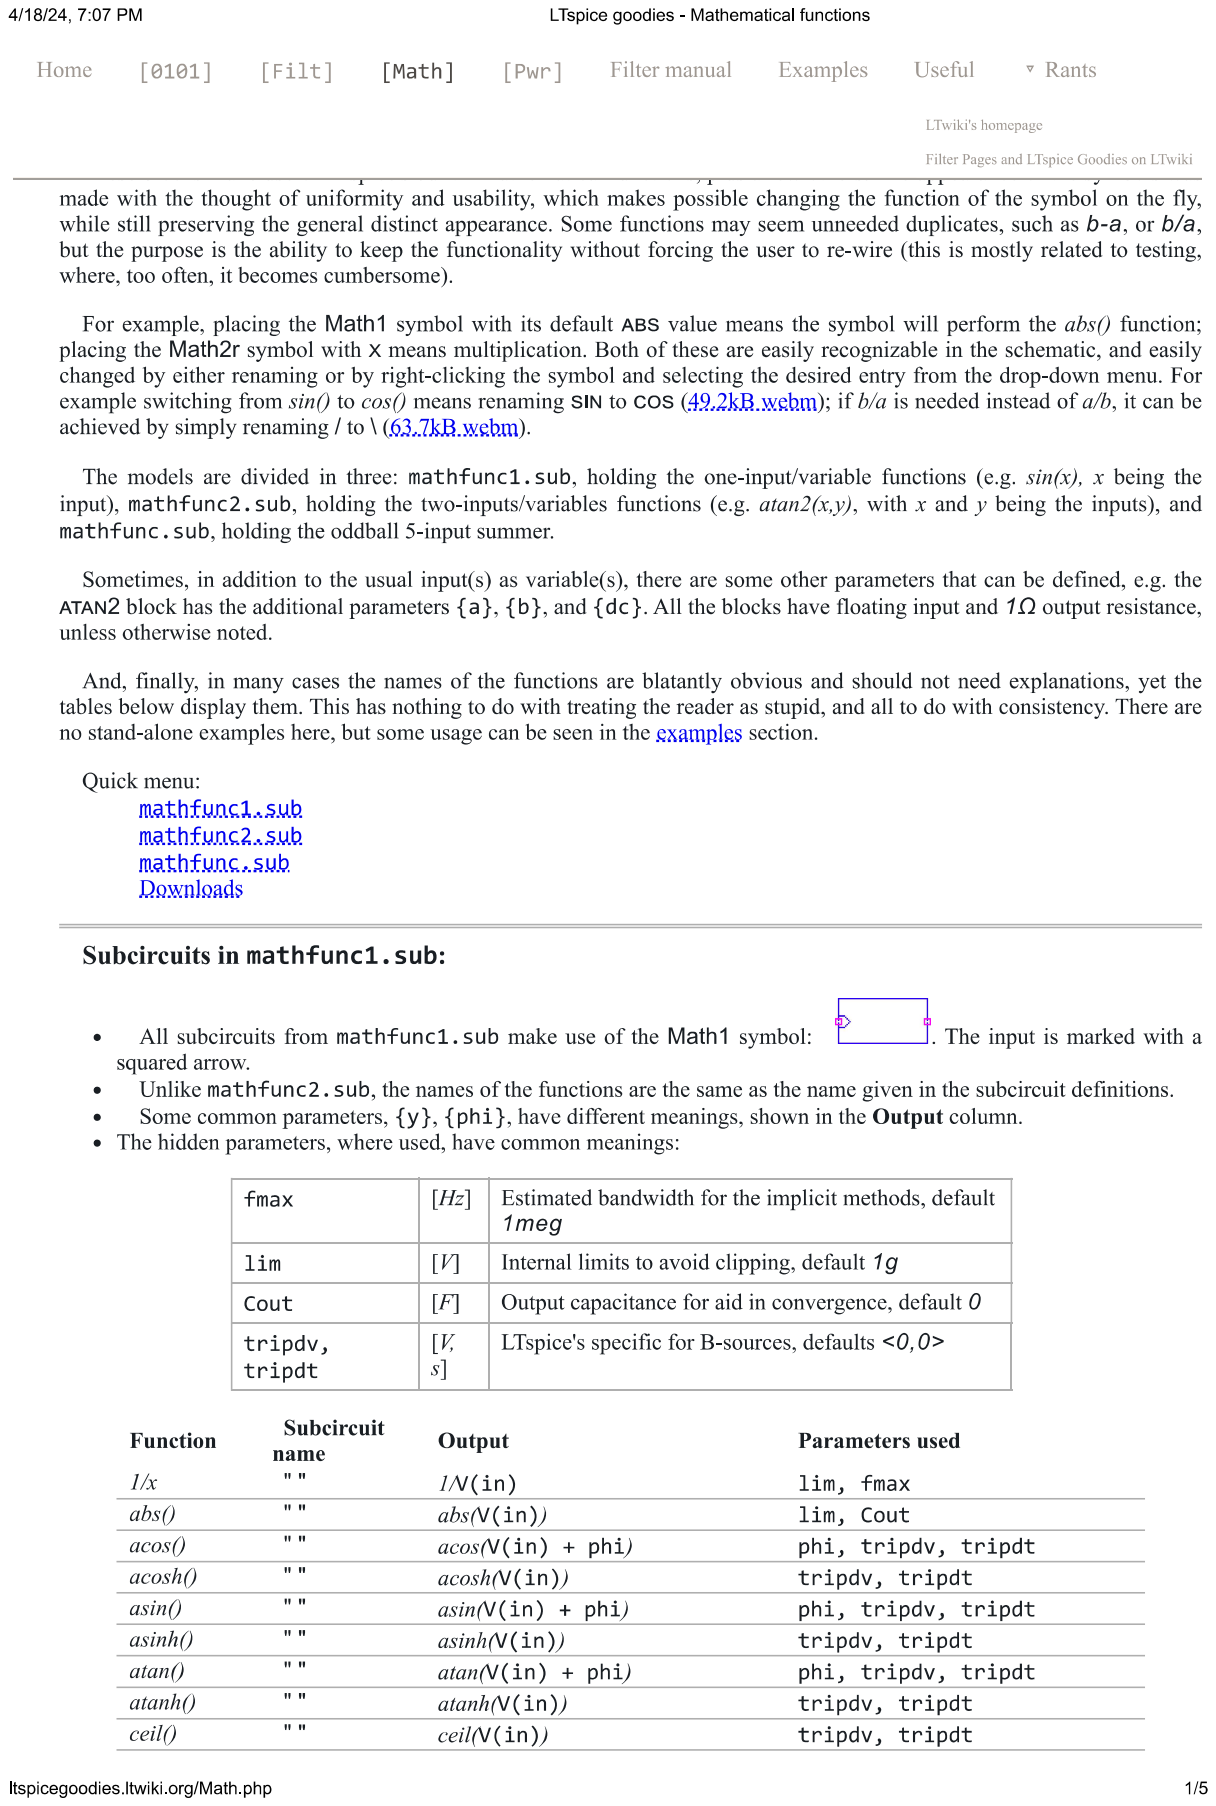
[picture p164: page 1]

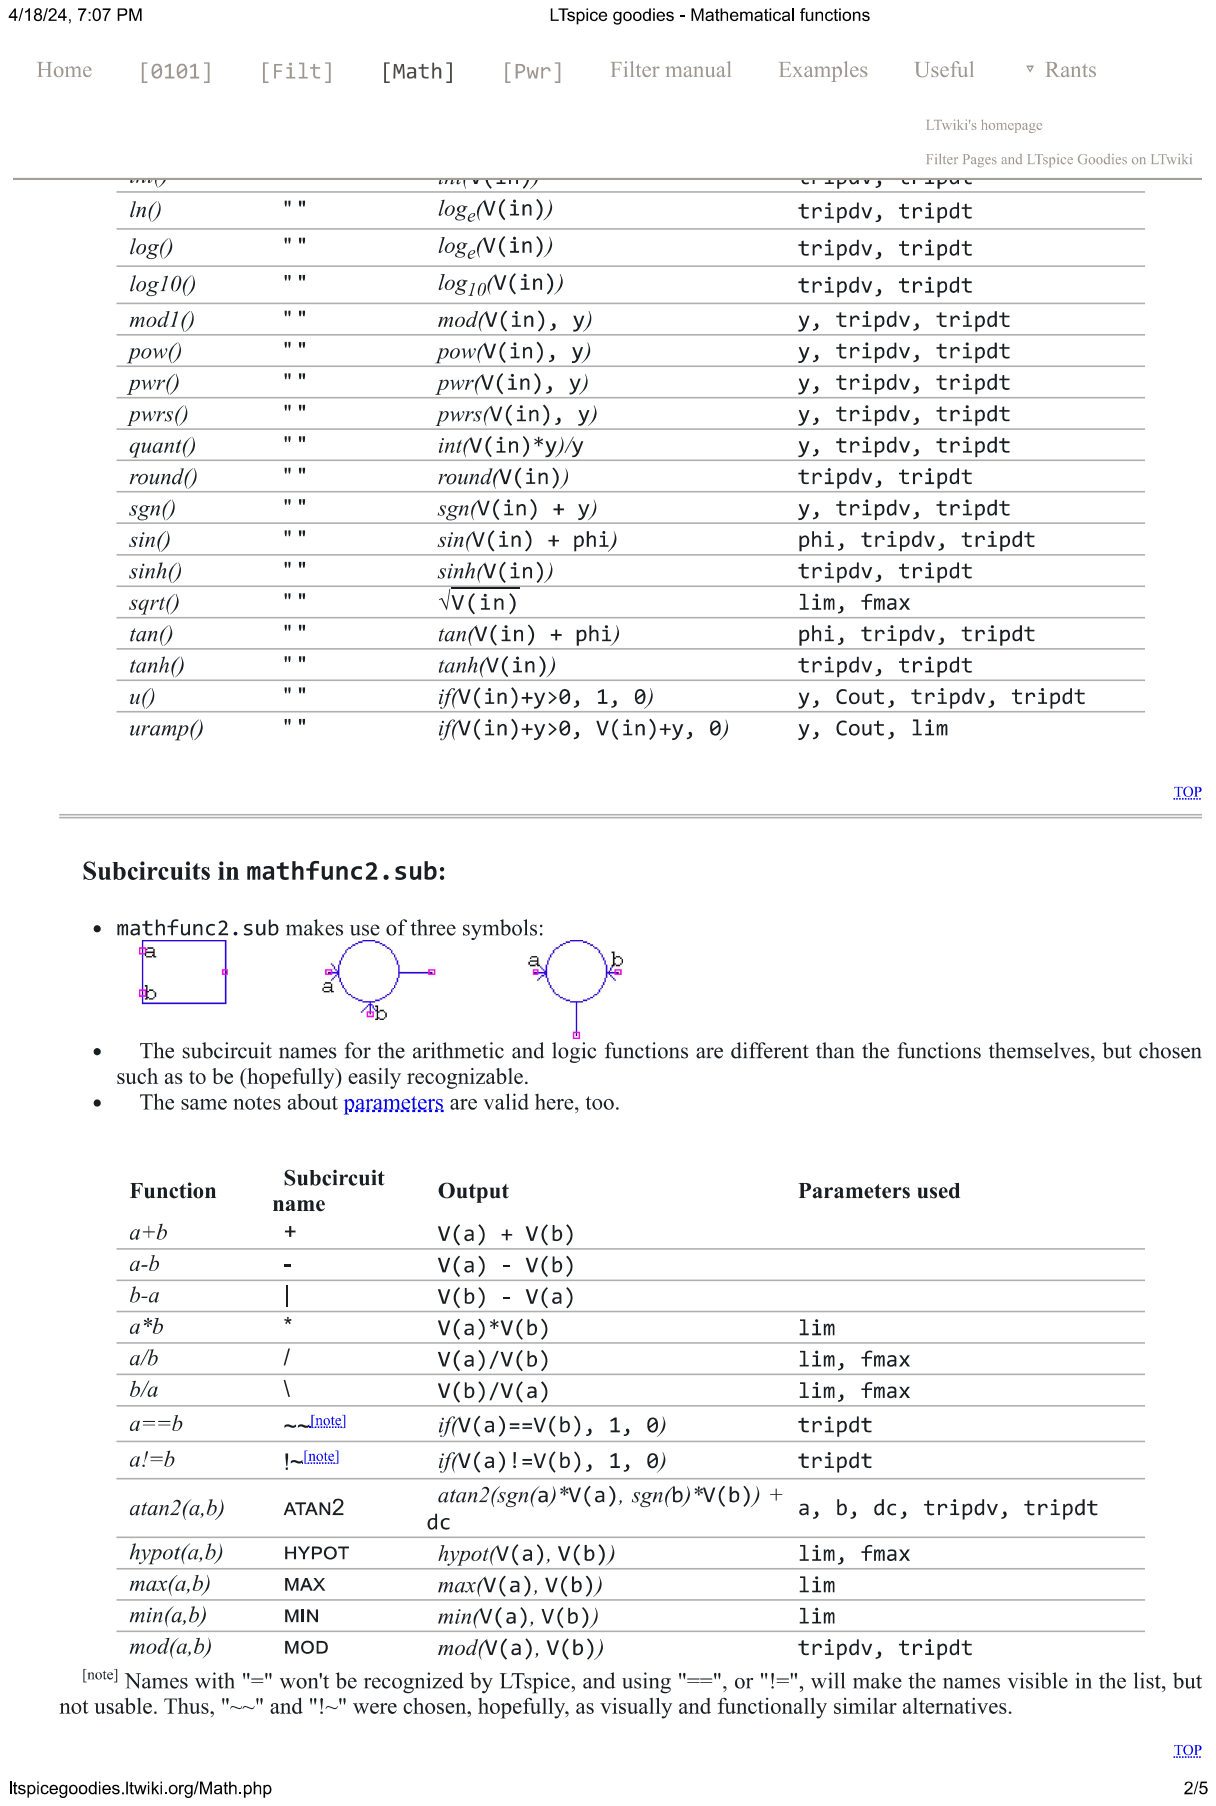
[picture p165: page 2]

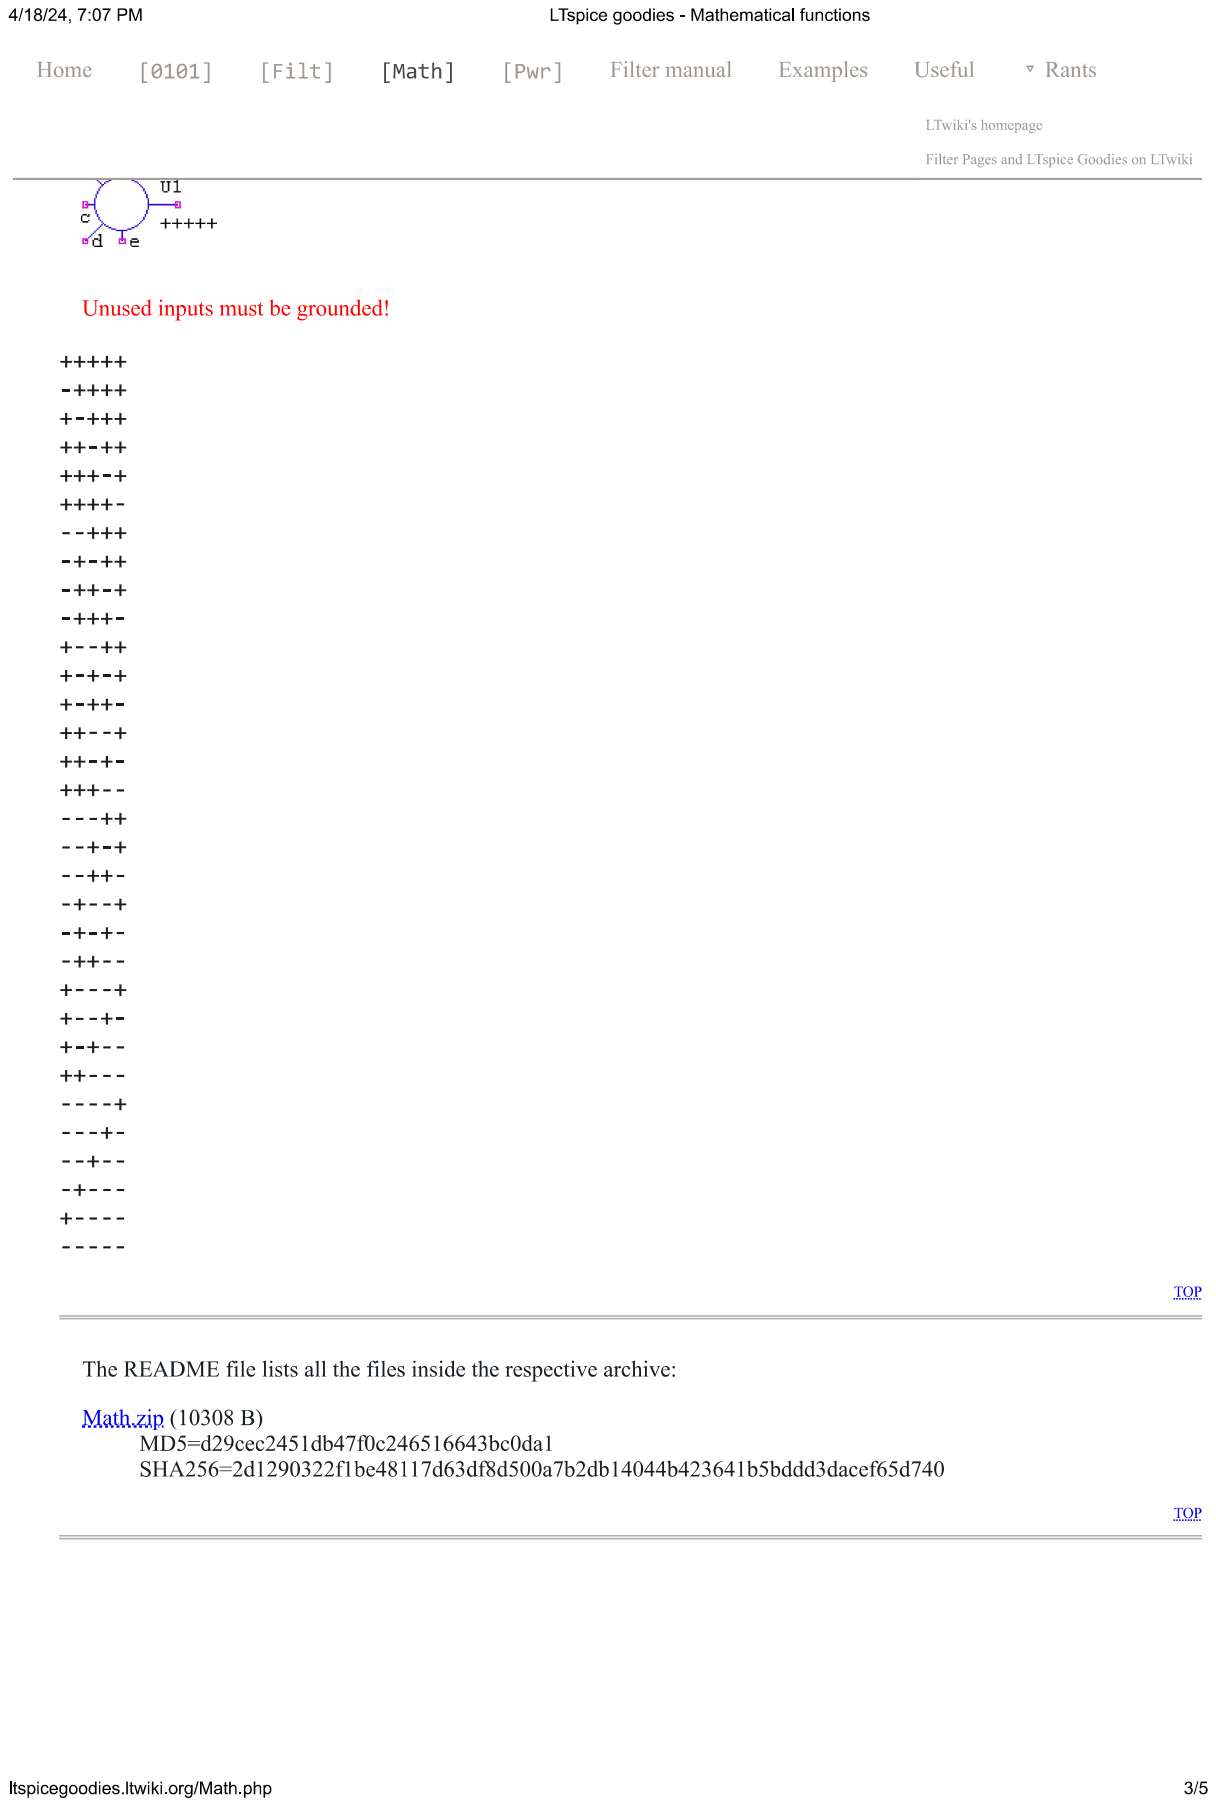
[picture p166: page 3]

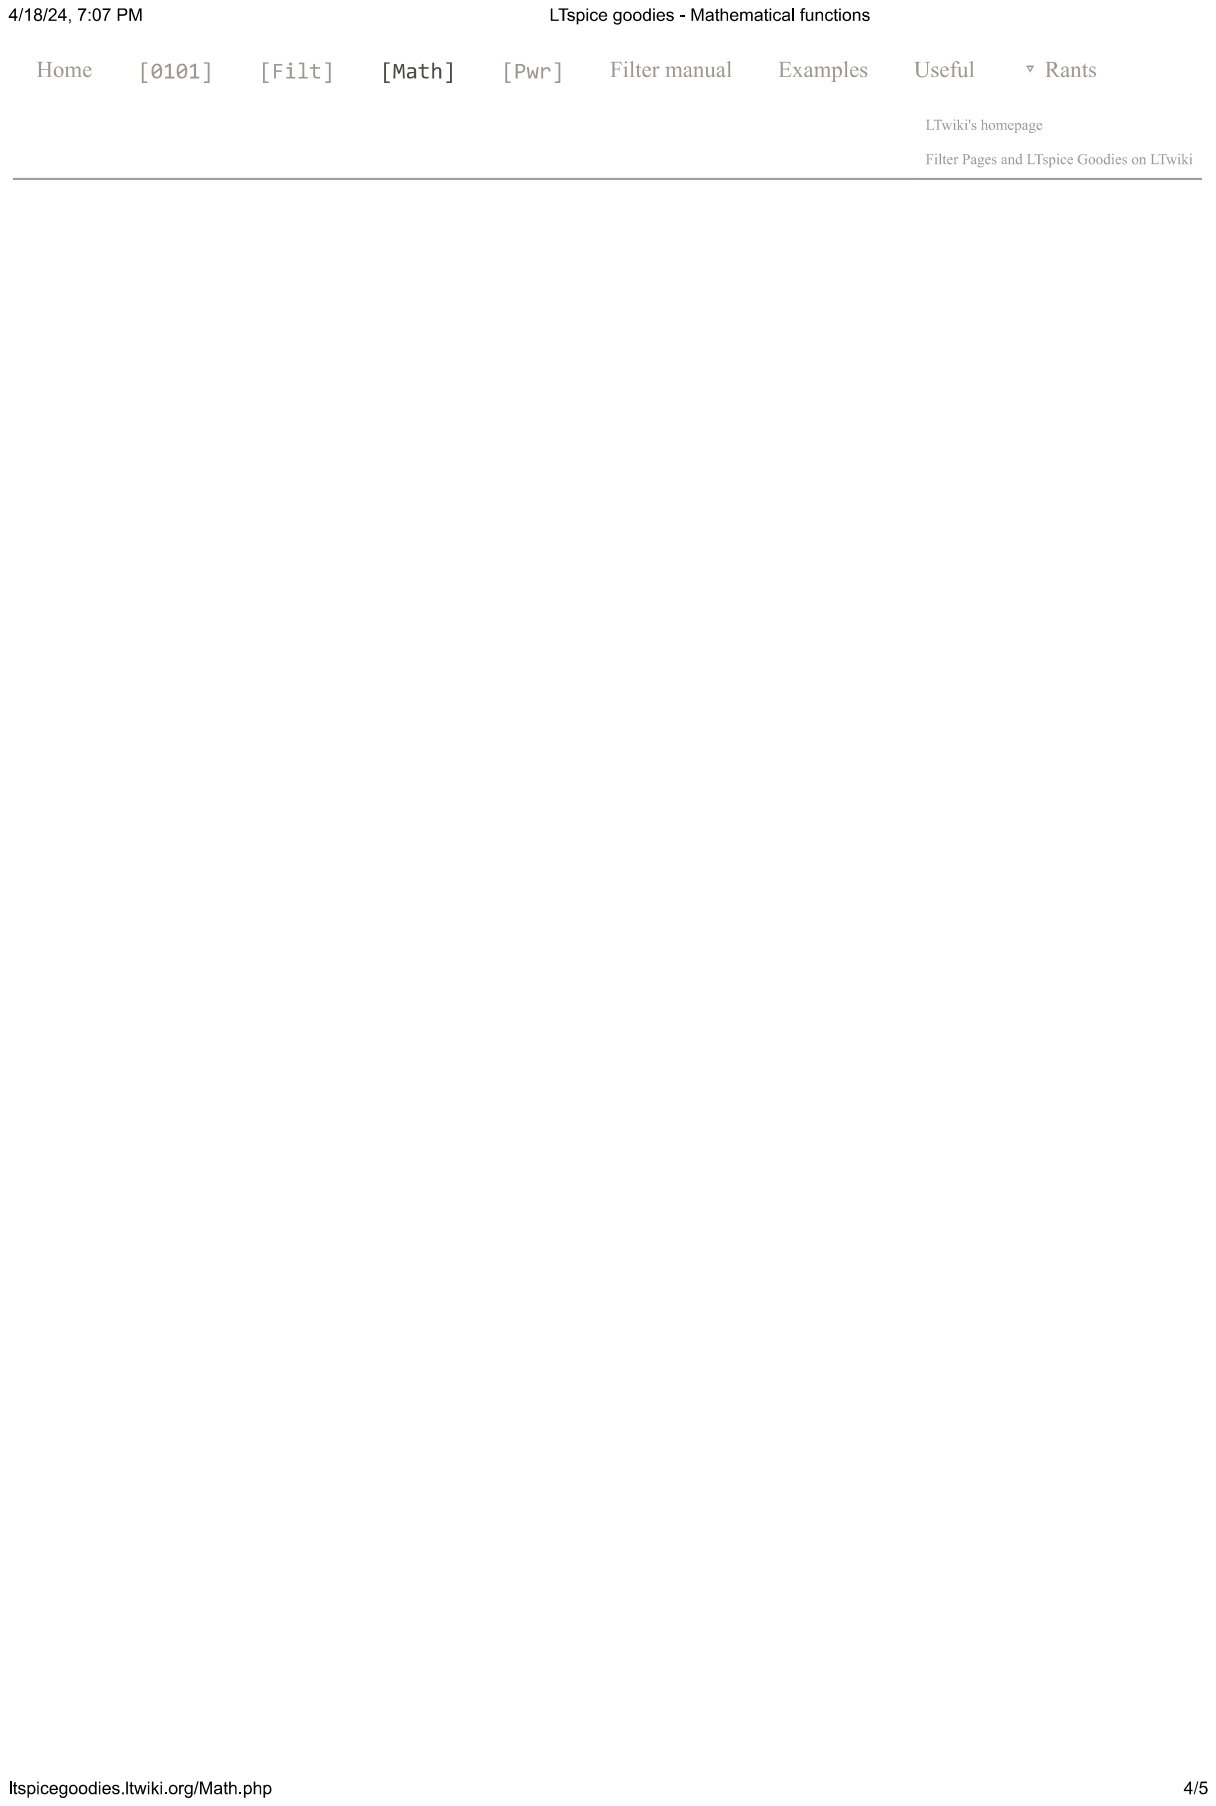
[picture p167: page 4]

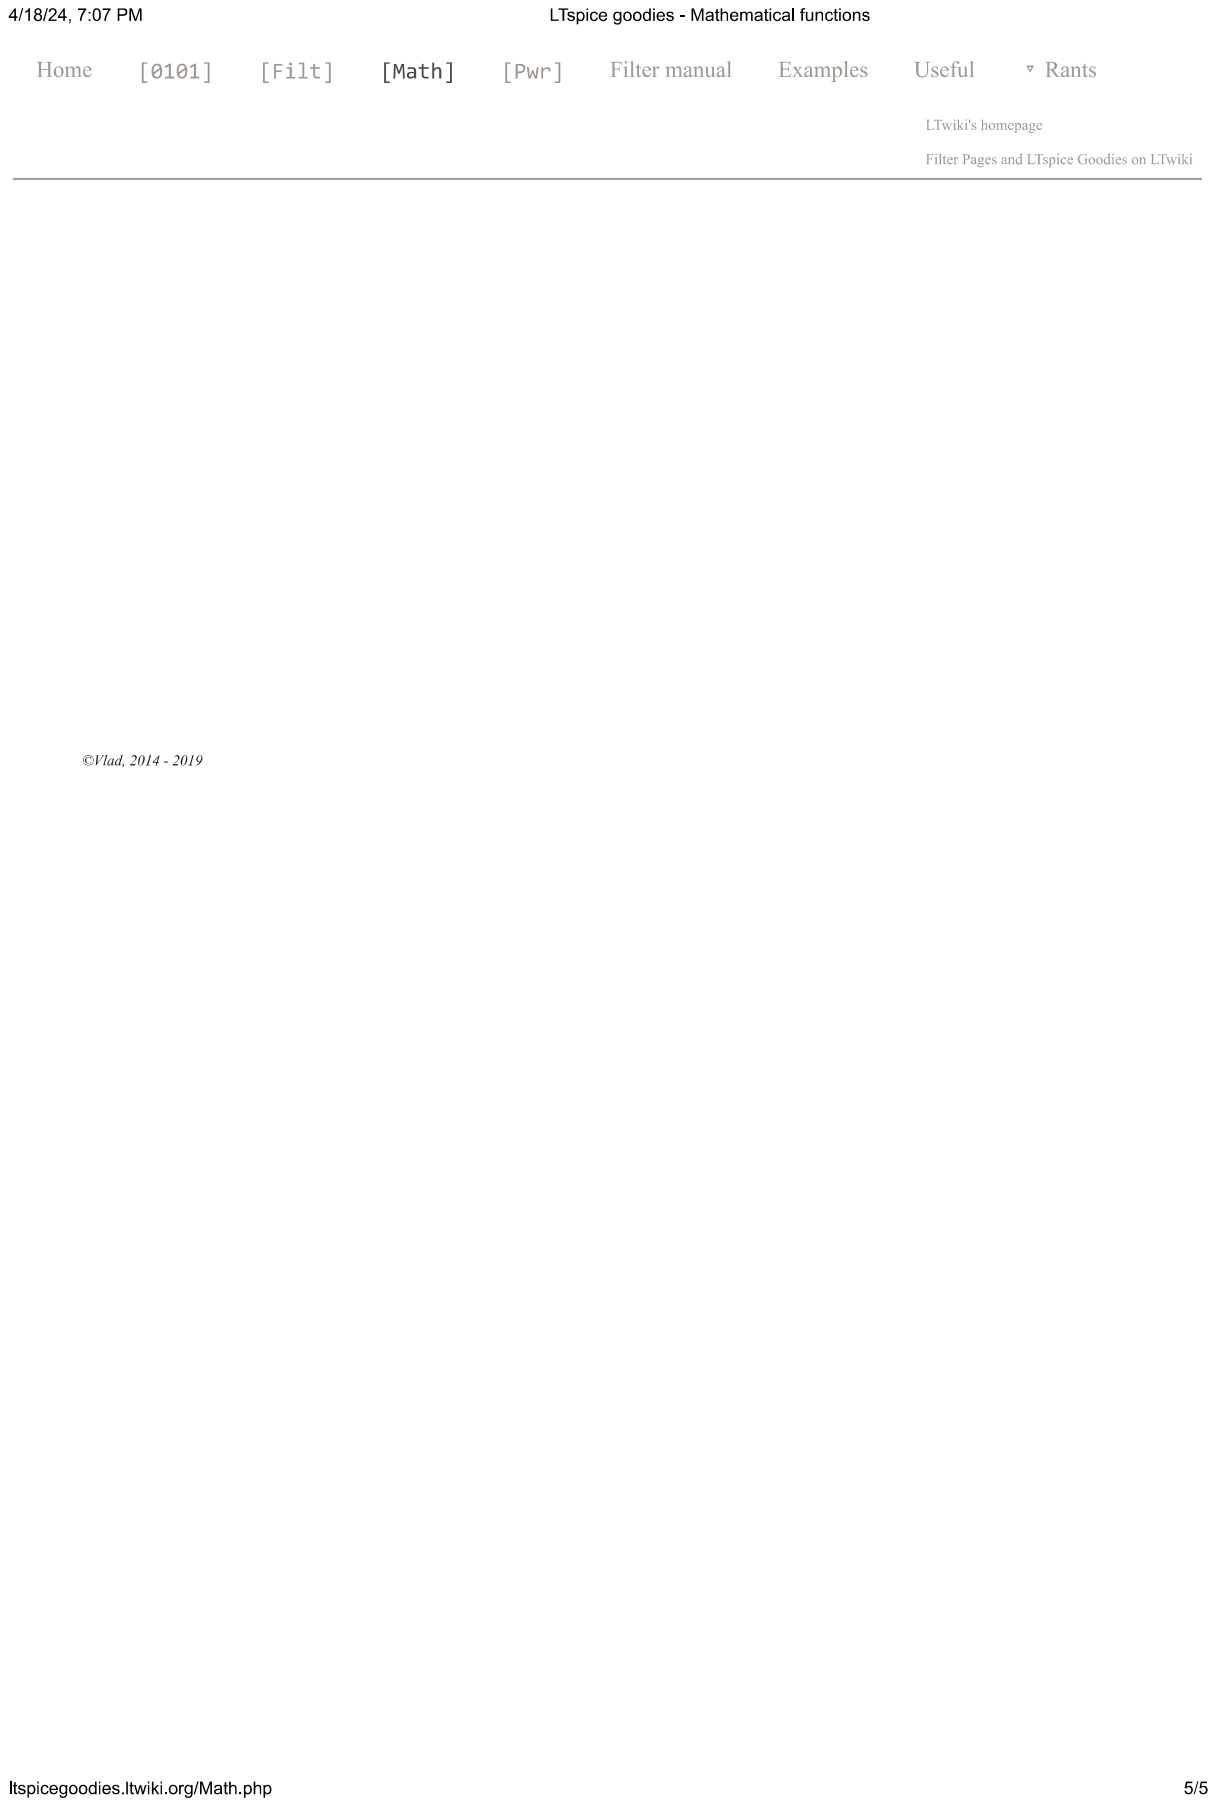
[picture p168: page 5]
