erdemcanaz/EE464-Emine-BOOSTanci/single_switch_flyback_sim_reportv2.asc

B3: bv; V=-{V(V_input_circuit)}*I(source)
B4: bv; V={Vbat}*I(battery)+{Rbat}*I(battery)*I(battery)+{Rbat_0}*I(battery)*I(battery)
battery: voltage; {Vbat}
C1: cap; 1.1n
C2: cap; 220n; IC=0
C3: cap; 4.7µF
C5: cap; 220p
C6: cap; {Cout}; IC={V_cap_out}
C8: cap; {Cout}; IC={V_cap_out}
C11: cap; {Cout}; IC={Vin}
C12: cap; {Cout}; IC={Vin}
C13: cap; 1nF
C14: cap; 220n
C16: cap; 100n
D1: zener; TDZV9_1
D3: schottky; MBR735
D4: schottky; MBRS340
D5: LED
D6: zener; UMZ5_1N
D7: LED
L1: ind2; 20.94µ; Rser=0 Rpar=0
L3: ind2; 20.94µ; Rser=0 Rpar=0
L4: ind2; 20.94µ
L7: ind; 25nH
L9: ind; {ESL_elc}
L10: ind; {ESL_elc}
L11: ind; 2.2µ
L13: ind; {ESL_cer}
L14: ind; {ESL_cer}
L15: ind; {ESL_elc}
L16: ind; {ESL_elc}
L17: ind; 2.2µ
Q1: NMOS; IRFR2607Z
R1: res; 15m
R2: res; 150
R3: res; 15k
R4: res; 1.2k
R5: res; 12
R6: res; 1k
R7: res; 1k
R8: res; 4.6m
R9: res; 10k
R10: res; 66.6k
R14: res; {Rcout}
R16: res; 4.7K
R17: res; 4.6m
R19: res; {Rbat}
R20: res; 100K
R22: res; 134
R23: res; {Rcout}
R24: res; {Rcout}
R25: res; 2m
R26: res; 10k
R27: res; {Rcout}
R28: res; 43
R29: res; {Rbat_0}
R31: res; 0.05
R32: res; 0.05
R33: res; 0.05
R34: res; 2m
R35: res; 1k
R36: res; 10k
R37: res; 50k
R38: res; 6.6k
R39: res; 6.6k
R40: res; 1k
R41: res; 10.5k
R42: res; 2.5k
source: VOLTAGE; {Vin}
U1: PC817A
U2: LT1243
U3: UniversalOpAmp2
U4: LM741
V1: voltage; 12
V2: voltage; 5V
V3: voltage; 12
Named nets: 0, Vout_plus, Vout_minus, Vcc, Vref, Vfb, 5V, P_in, P_out, V_input_circuit, 12V, sense, Vshunt
K1 L1 L3 L4 0.99
to eliminate high frequency noise.
FB input is very high Z. spikes significantly effects
.param Cout=470u
.param Rcout={0.064 + 3/(1+(Cout/0.00001533)**1.474)}
Change this with linear regulator
.param Vbat=12
.param Rbat={Vbat*0.004+0.000001}
Core loss model
!HEAT!
!BREAKDOWN!
!HEAT!
.param Vin=40
Feeder model
!BREAKDOWN!
Parameters
Aux Supply
Snubber design: Lecture 8.7: The Flyback Converter 4 (RCD Snubber)
https://youtu.be/WQtO3i5ZG74
R_snubber = (Vsnubber*(Vsnubber-Vo/N)) / (0.5*(I_Lpeak^2)*L_leak*f_sw)
C_snubber = Does not matter at steady state if ideal model is assumed. Better to pick a value resulting in <%3 ripple
.param Rbat_0=0.1
MOSFET
IMPLEMENT LINEAR
 REGULATOR HERE
REMOVE ZENNER
Has lower L_esr
Has lower L_esr
.param ESL_cer=200p
.param ESL_elc=10n
Honestly, the mosfet model already includes drain and source inductances
I have added inductances because I could not find model of the mosfet 
We are planning to use. This is safe and worst case scenario
Output filter 16V/10A rated
Input Filter 60V/10A rated
CONTROLLER IC
discharge resistor
Blue Led
discharge resistor
Green Led
Indicator LEDs
Indicates that the output voltage
is reached to 13.5V
Indicates that the converter
Is working/battery is connected
.param V_cap_out={Vbat}
LOAD
Snubber
Diode Snubber
Transformer Model
.tran 0 2.5m 2m uic
