erdemcanaz/EE464-Emine-BOOSTanci/Demo circuit/single_switch_flyback_sim_reportv6.asc

B3: bv; V=-{V(V_input_circuit)}*I(source)
Buck-converter: voltage; 15
C2: cap; 220n; IC=0
C3: cap; 660n
C4: cap; 1n
C6: cap; 660n; IC=12.5
C7: cap; 940µ; IC=12.5
C11: cap; 470µ; IC={Vin}
C13: cap; 1nF
C14: cap; 660n
Ccomp: cap; 10n
Ct: cap; 1.1n
D1: zener; TDZV10
D3: schottky; MBR735
D4: schottky; MBRS340
L1: ind2; 20.94µ; Rser=0 Rpar=0
L2: ind; 10µ
L3: ind2; 20.94µ; Rser=0 Rpar=0
L4: ind2; 20.94µ
L7: ind; 25nH
L11: ind; 10µ
Q1: NMOS; AONR32320C
Q2: NMOS; AONR32320C
R1: res; 65m
R2: res; 150
R4: res; 1.2k
R5: res; 6
R6: res; 2m
R7: res; 2k
R8: res; 4.6m
R9: res; 5.7k
R10: res; 0.2
R11: res; 0.02
R12: res; 0.1
R14: res; 0.02
R17: res; 4.6m
R18: res; 1k
R22: res; 330
R25: res; 2m
R28: res; 43
R33: res; 0.1
Rcomp: res; 10k
Rout: res; 2.81
Rpot3: res; {2000*T_POT}
Rpot4: res; {2000*(1-T_POT)}
Rt: res; 15k
source: VOLTAGE; {Vin}
U1: PC817A
U2: LT1243
Named nets: 0, Vout_minus, Vcc, Vref, Vout_plus, Vfb, P_in, V_input_circuit, Vshunt
K1 L1 L3 L4 0.99
Core loss model
.param Vin=40
Feeder model
Parameters
Snubber design: Lecture 8.7: The Flyback Converter 4 (RCD Snubber)
https://youtu.be/WQtO3i5ZG74
R_snubber = (Vsnubber*(Vsnubber-Vo/N)) / (0.5*(I_Lpeak^2)*L_leak*f_sw)
C_snubber = Does not matter at steady state if ideal model is assumed. Better to pick a value resulting in <%3 ripple
Output filter 16V/10A rated
Input Filter 60V/10A rated
CONTROLLER IC
LOAD
Snubber
Diode Snubber
Transformer Model
.tran 0 1.5m 0m uic
.param T_POT=0.0001
Optocoupler feedback circuit
