erdemcanaz/EE464-Emine-BOOSTanci/Demo circuit/single_switch_flyback_sim_reportv5.asc

Buck_Converter1: voltage; 15
Buck_Converter: voltage; 15
C1: cap; 1.1n
C2: cap; 220n; IC=0
C3: cap; 660n
C4: cap; 1.1n
C5: cap; 1n
C6: cap; {Cout}; IC={V_cap_out}
C7: cap; 220n; IC=0
C8: cap; {Cout}; IC={V_cap_out}
C9: cap; {Cout}; IC={V_cap_out}
C10: cap; 660n
C11: cap; {Cout}; IC={Vin}
C12: cap; {Cout}; IC={Vin}
C13: cap; 1nF
C14: cap; 220n
C15: cap; {Cout}; IC={V_cap_out}
C16: cap; 100n
C17: cap; {Cout}; IC={Vin}
C18: cap; {Cout}; IC={Vin}
C19: cap; 1nF
C20: cap; 220n
C21: cap; 100n
C22: cap; 1n
D1: zener; TDZV10
D2: schottky; MBR735
D3: schottky; MBR735
D4: schottky; MBRS340
D5: schottky; MBRS340
D6: zener; TDZV10
L1: ind2; 20.94µ; Rser=0 Rpar=0
L2: ind; 10µ
L3: ind2; 20.94µ; Rser=0 Rpar=0
L4: ind2; 20.94µ
L5: ind2; 20.94µ; Rser=0 Rpar=0
L6: ind2; 20.94µ; Rser=0 Rpar=0
L7: ind2; 20.94µ
L8: ind; {ESL_cer}
L9: ind; {ESL_elc}
L10: ind; {ESL_elc}
L11: ind; 2.2µ
L12: ind; {ESL_cer}
L13: ind; {ESL_cer}
L14: ind; {ESL_cer}
L15: ind; {ESL_elc}
L16: ind; {ESL_elc}
L17: ind; {ESL_elc}
L18: ind; {ESL_elc}
L19: ind; {ESL_elc}
L20: ind; {ESL_elc}
L21: ind; 2.2µ
L22: ind; 10µ
Q1: NMOS; IRFR2607Z
Q2: NMOS; IRFR2607Z
Q3: NMOS; IRFR2607Z
Q4: NMOS; IRFR2607Z
R1: res; 15k
R2: res; 150
R3: res; 15k
R4: res; 1.2k
R5: res; 6
R6: res; 6
R7: res; 2k
R8: res; 4.6m
R9: res; 2.7k
R10: res; 330
R11: res; 4.6m
R12: res; {Rcout}
R13: res; {Rcout}
R14: res; {Rcout}
R15: res; 150
R16: res; 10k
R17: res; 4.6m
R18: res; 4.6m
R19: res; {Rcout}
R20: res; {Rcout}
R21: res; 43
R22: res; 330
R23: res; {Rcout}
R24: res; {Rcout}
R25: res; 2m
R26: res; 10k
R27: res; {Rcout}
R28: res; 43
R30: res; 0.05
R31: res; 0.05
R32: res; 0.05
R33: res; 2m
R34: res; 2m
R35: res; 2m
R36: res; 10k
R37: res; 1.2k
R38: res; 2k
R39: res; 2.7k
R40: res; 10k
Rpot1: res; {2000*(1-T_POT)}
Rpot2: res; {2000*T_POT}
Rpot3: res; {2000*T_POT}
Rpot4: res; {2000*(1-T_POT)}
Rsense1: res; 65m
Rsense: res; 65m
U1: PC817A
U2: LT1243
U3: LT1243
U4: PC817A
Named nets: 0, Vcc, Vref, Vfb, Vshunt
K1 L1 L3 L4 0.99
Core loss model
MOSFETS
Has lower L_esr
Has lower L_esr
Output filter 16V/10A rated
Input Filter 60V/10A rated
CONTROLLER IC
discharge resistor
Snubber
Diode Snubber
Transformer Model
.tran 0 5m 2m uic
OPTO VOLTAGE FEEDBACK
K1 L1 L3 L4 0.99
Core loss model
MOSFETS
Has lower L_esr
Has lower L_esr
Output filter 16V/10A rated
Input Filter 60V/10A rated
CONTROLLER IC
discharge resistor
Snubber
Diode Snubber
Transformer Model
.tran 0 5m 2m uic
OPTO VOLTAGE FEEDBACK
