erdemcanaz/EE464-Emine-BOOSTanci/New Design for two switch/flyback_circuit_two_switch2.asc

C1: cap; 77µf
C2: cap; 1000µ
D1: schottky; 1N5819
D2: schottky; 1N5819
D3: schottky; 1N5819
L1: ind2; 20µ
L2: ind; 1µ
L3: ind2; 20µ
M1: nmos; IRFZ48N
M2: nmos; IRFZ48N
R1: res; 3.3m
R2: res; 3.3m
R3: res; 2.4
V1: voltage; 20
V2: voltage; PULSE(0 10 0 200ns 200ns 4us 10us)
V3: voltage; PULSE(0 60 0 200ns 200ns 4us 10us)
Named nets: 0, signal, signal2
.tran 2ms
K1 L1 L3 1
