erdemcanaz/EE464-Emine-BOOSTanci/New Design for two switch/flyback_feedback_add_winding2.asc

C1: cap; 1.1n
C2: cap; .1µ
C3: cap; 0.1µ
C4: cap; .0022µ
C5: cap; 100p
C6: cap; 22µ
C9: polcap; 500µ
C10: cap; 10n
D1: schottky; BAT54
D2: schottky; BAT54
D3: schottky; MBRS340
D4: zener; BZX84C15L
L1: ind2; 20µ; Rser=0 Rpar=0
L2: ind2; 32µ; Rser=.1
L3: ind2; 20µ; Rser=0 Rpar=0
Q1: NMOS; Si7802DN
R1: RES; 0.1
R2: res; 200k
R3: res; 15k
R4: res; 25k
R5: res; 12
R7: res; 150k
R13: res; 300k
Rload: res; 2.4
U2: LT1243
V1: VOLTAGE; 40
Named nets: 0, +20V, IN
.tran 12m
K1 L1 L2 L3 1
