erdemcanaz/EE464-Emine-BOOSTanci/IR2184-ltspice bootstrap trial/ir2184_test.asc

C1: cap; 1n
C2: cap; 1n
V1: voltage; 15
V2: voltage; PULSE(0 3.5 2u 1n 1n 6u 12u)
V3: voltage; PULSE(3.5 0 .5u 1n 1n .5u)
X1: IR2184
Named nets: 0, SD\, Ho, Lo, In, 15V
VZos: 625V
VZin: 10V
Td on: 680ns
Td off: 270ns
Tsd: 180ns
Tr on: 40ns
Tf off: 20ns
VHin: 2.7V
VLin: 0.8V
VHsat: 1.2V
Ros: 12e6
Rb: 250k
Rcc: 15k
Rin: 1e6
 Lin\\: R to +5
UVrise: 8.9V
UVfall: 8.2V
Io+: 1.9A
Io-: 2.3A
.tran 9u
