erdemcanaz/EE464-Emine-BOOSTanci/flyback_circuit_two_switch.asc

C1: cap; 77µf
C2: cap; 1000µ
D1: schottky; 1N5819
D2: schottky; 1N5819
D3: schottky; 1N5819
L1: ind2; 30µ
L2: ind; 1.5µ
L3: ind2; 7.5µ
M1: nmos; IRFZ48N
M2: nmos; IRFZ48N
R3: res; 2.4
V1: voltage; 40
V2: voltage; PULSE(0 12 0 200ns 200ns 5us 10us)
V3: voltage; PULSE(0 32 0 200ns 200ns 5us 10us)
Named nets: 0, signal, signal2
out/in = 0.5
.tran 2ms
K1 L1 L3 1
