erdemcanaz/EE464-Emine-BOOSTanci/IR2104-ltspice bootstrap trial/ır2110.asc

C1: cap; 1µ
C2: cap; 1µ
C3: cap; 47µ
D1: schottky; SS24
Hin-1: voltage; PULSE(0 10 0 10n 10n 5u 10u)
M1: nmos; IRFZ48Z
M2: nmos; IRFZ48Z
R1: res; {Rmotor}
R2: res; {Rgate}
R3: res; {Rgate}
U1: ir2110
VCC1: voltage; 40
VCC: voltage; 12
Named nets: 0, VCC, Vmax
.include ir2110.sub
.param Td=560n
.param Rgate=100
.param Rmotor=1
.param Lmotor=500u
.tran 0.005
