erdemcanaz/EE464-Emine-BOOSTanci/IR2104-ltspice bootstrap trial/Draft1.asc

C1: polcap; 10µ; V=2 Irms=3 Rser=0.011 Lser=0 mfg="Rubycon" pn="2SXB100M" type="Al electrolytic"
D1: schottky; 1N5819
M1: nmos; IRFZ48Z
M2: nmos; IRFZ48Z
R1: res; 100
U1: ir2104
V1: voltage; 20
V2: voltage; 10
V3: voltage; PULSE(0 5 0 0.1u 0.1u 5u 10u)
V4: voltage; 40
Named nets: 0, vcc, PWM, Vg
.tran 0.005
.include ir2104.sub
