erdemcanaz/EE464-Emine-BOOSTanci/IR2184-ltspice bootstrap trial/ir2184.asc

A1: diffschmitt; Vt=1.75 Vh=0.95; Trise=430n Tfall=5n; Td=220n Tripdt=50n
A2: diffschmitt; Vt=1.75 Vh=0.95; Td=130n Tripdt=30n
A3: diffschmtbuf; Vt=8.55 Vh=.35; Td=50n Tripdt=10n
A4: and; Tau=30n; Tripdt=10n; Ref=.95
A5: diffschmtbuf; Vt=8.55 Vh=.35; Td=50n Tripdt=10n
A6: and; Tau=30n; Tripdt=10n; Ref=.95
C1: cap; 10p; Rpar=1e6
C2: cap; 10p; Rpar=1e6
C3: cap; 42p
C4: cap; 50p; Rpar=100k
C5: cap; 42p
C6: cap; 50p; Rpar=100k
D1: diode; Dd
D2: zener; 10V
D3: diode; Dd
D4: zener; 10V
D5: diode; Dd
D6: diode; Dd
D7: zener; 625V
D8: zener; 25V
D9: zener; 25V
D10: diode; Dd
D11: diode; Dd
E1: e; 5
R1: res; 16k
S1: sw; SH
S2: sw; SL
S3: sw; SH
S4: sw; SL
Named nets: Ho, In, Vb, Vs, Com, Vcc, Lo, 0, 4, 6, 8, SD\, 7, 5, 5V, 2, 3, 9, COM, 1
>> IR2184 Behavioral Model by analog@ieee.org 12/2005 Rev - <<
.model Dd D(Ron=.5 Vfwd=.5)
.model 10V D(Ron=.5 Vfwd=.5 Vrev=10)
.model 25V D(Ron=.5 Vfwd=.5 Vrev=25.2 Roff=250k)
.model 625V D(Ron=.5 Vfwd=.5 Vrev=625 Roff=12e6)
.model SH SW(Vt=.5 Vh=-.5 Ron=8 Ilimit=1.9 Vser=1.2)
.model SL SW(Vt=.5 Vh=-.5 Ron=3 Ilimit=2.3)
Td=50ns
(outputs)
