erdemcanaz/EE464-Emine-BOOSTanci/controller/uc3843.asc

C1: cap; 2.2n
C2: cap; 1µ
C3: cap; 1µ
R1: res; 8.2k
R2: res; 5k
R3: res; 25k
R4: res; 1k
R5: res; 4k
U4: LT1243
V1: voltage; 1
V2: voltage; 15
Named nets: 0, Vreg
.tran 0.001
