erdemcanaz/EE464-Emine-BOOSTanci/Demo circuit/noniverting_amplifier/lm741_noninverting_amplifier.asc

I1: current; PWL(0 0 30m 15)
R1: res; {R_f1}
R2: res; {R_f2}
R3: res; 10k
R4: res; {R_shunt}
U1: LM741
V1: voltage; 12V
Named nets: 0, 12V
.param R_f2=1k R_f1=66.6k R_shunt=15m
.tran 50m
