erdemcanaz/EE464-Emine-BOOSTanci/controller/controller_simulation/flyback_circuit_control.asc

C1: cap; 100µ
C2: cap; 1µ
C3: cap; 1.1n
C4: cap; 1µ
C5: cap; 10n
D1: schottky; 1N5819
L1: ind2; 30µ
L3: ind2; 7.5µ
M1: nmos; IRFZ48N
R1: res; 13k
R2: res; 12
R3: res; 2.4
R4: res; 95k
R5: res; 25k
R6: res; 0.15
R7: res; 1k
U1: LT1243
V1: voltage; 40
V2: voltage; PULSE(0 15 0 200ns 200ns 3.75us 10us)
V3: voltage; 15
Named nets: 0, signal, Vreg, Vout
.tran 10ms
K1 L1 L3 1
