erdemcanaz/EE464-Emine-BOOSTanci/(commit log)

2024-03-15 Magnetic Design
    Magnetic Design code up to selecting duty cycle, turns ratio, number of primary and secondary turns, E core, Lm, air gap length, AWG cable is completed. Additional documents for design and core material is also added
2024-03-16 Core Loss calculation
    This document is obtained from the Magnetics website
    [Magnetics-Ferrite-Core-Loss-Equations.xlsx]
2024-04-08 Two switch flyback
    Two switch flyback topology
2024-04-13 IR2101 equivalent gate driver LTspice model
2024-04-13 IR2110
    Başka bir mosfet sürücü
2024-04-14 Optocoupler and regulator
    Optocoupler and regulator that will be used in feedback.
2024-04-14 Two Switch Design
    0.5 is the maximum allowable duty cycle thus all design is updated
2024-04-18 Reports File and Start of the Simulation Report
    A reports file is constructed. HW1 report is appended with the start of the simulation report. In simulation report introduction, topology selection and new magnetic design is written for now.
2024-04-18 simulation report ltspice circuit progress1
2024-04-18 not working simulation circuit
2024-04-19 Flyback- first prototype circuit is finished
2024-04-20 Component list
    [components.xlsx]
2024-04-20 Output indicator leds & filters are added
2024-04-20 Create Simulation report circuit_20_04_2024_15_51.zip
2024-04-20 Inductor added
    [components.xlsx]
2024-04-23 New Mosfet
    Same mosfet with different package is added
    [components.xlsx]
2024-04-24 Addition to power point
2024-06-09 Linear regulator and current sense amplifier
    current sense amplifier does not work
2024-06-10 Magnetic design for correction
    This is used for corrections that are given by Ogün Abi
2024-06-12 Datasheet data
    [data.xlsx]
2024-06-12 datasheet prep
    [data.xlsx]
2024-06-12 cct schematic
2024-06-13 Final Report
    Intro-Initial design-Magnetic Design are revised. Controller design is written
2024-06-13 Thermal Circuits Simulations
    Thermal Circuits are simulated in Matlab and Simulink
2024-06-13 Simulation results
    [simulation_results.xlsx]
